DANTRACX/OpenVFD/README.md

# OpenVFD
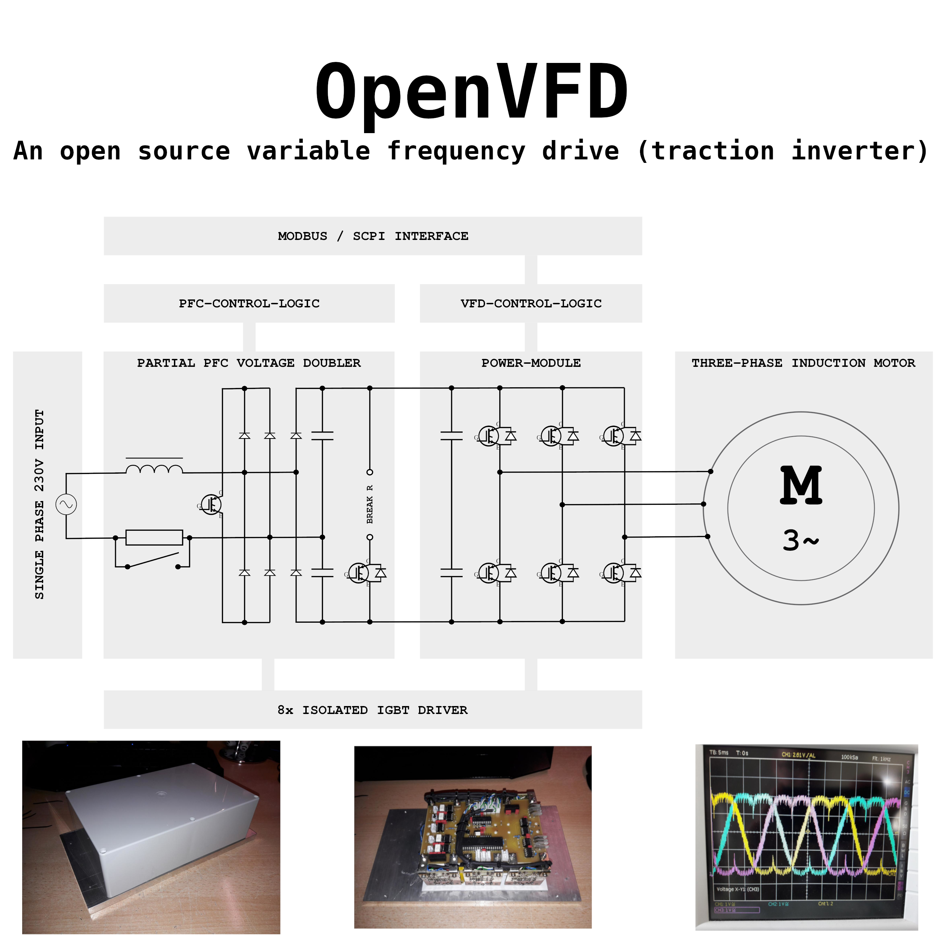
[picture p1: vfd_images/OpenVFD.png]
OpenVFD structure
