DANTRACX/OpenVFD/vfd_images/20190318_145512.jpg

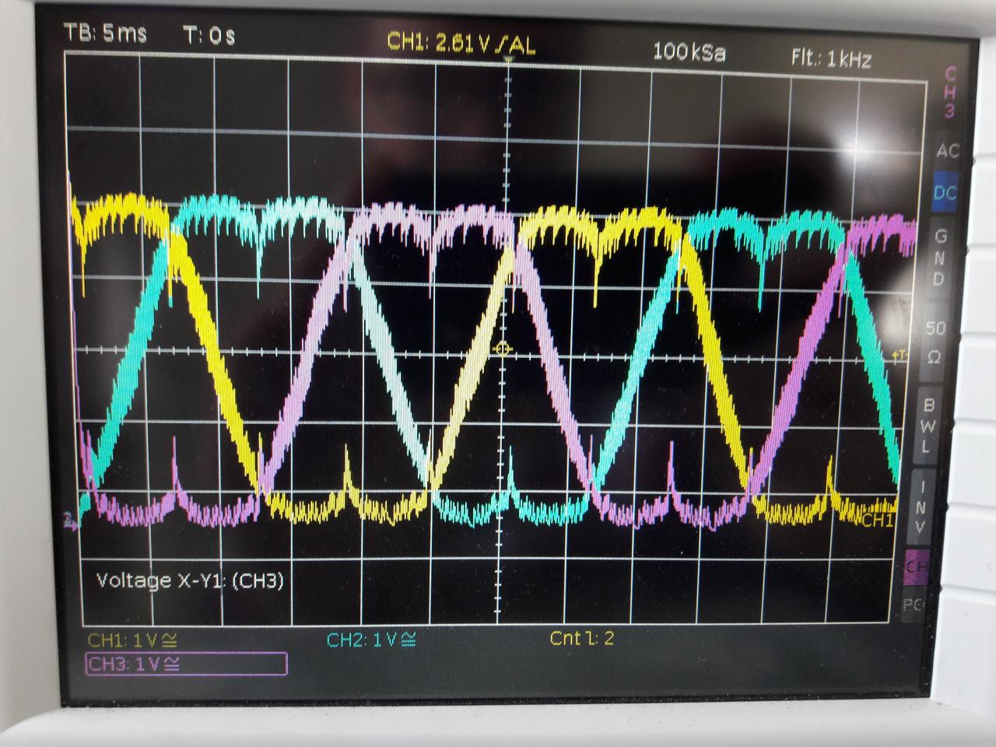
vfd_images/20190318_145512.jpg
