DANTRACX/OpenVFD/vfd_images/20191023_152630.jpg

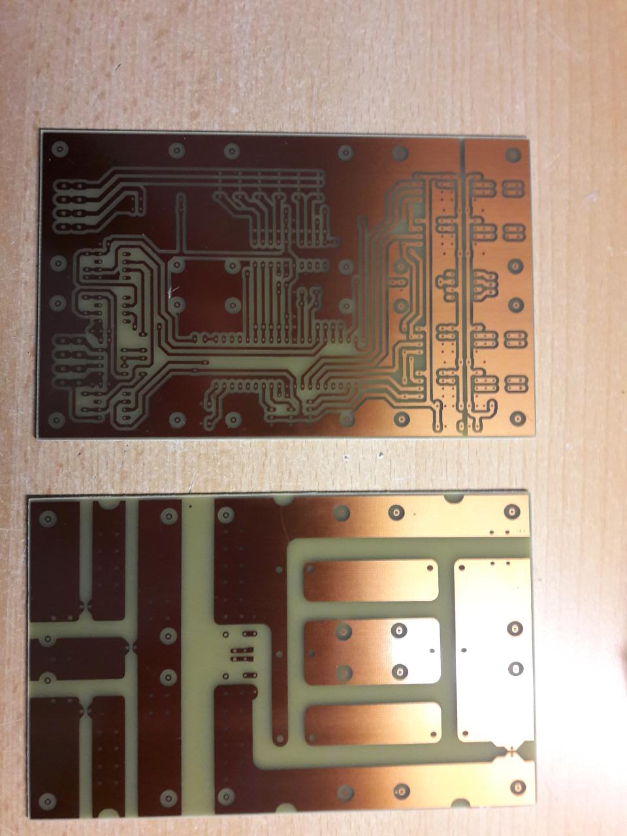
vfd_images/20191023_152630.jpg
