DANTRACX/OpenVFD/vfd_images/20191025_230519.jpg

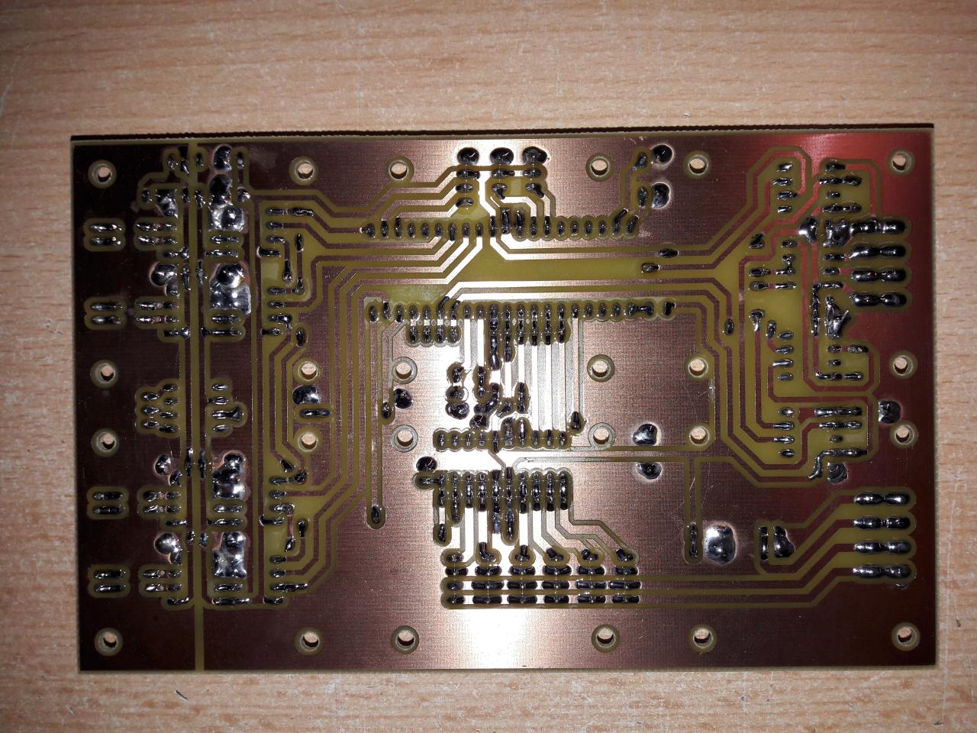
vfd_images/20191025_230519.jpg
