DANTRACX/OpenVFD/vfd_images/20200607_120607.jpg

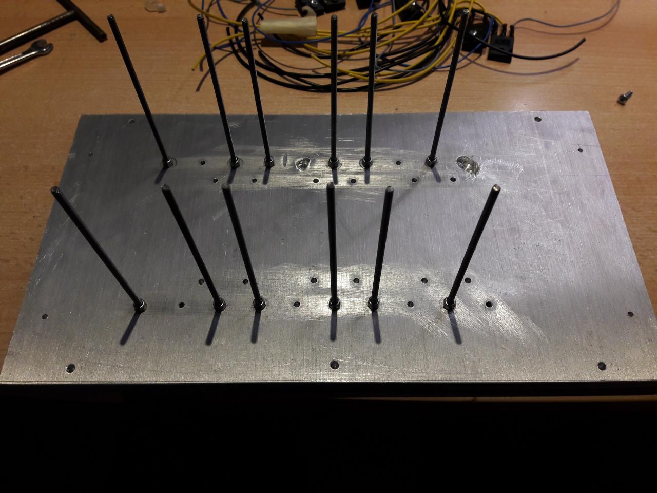
vfd_images/20200607_120607.jpg
