DANTRACX/OpenVFD/vfd_images/20200611_165828.jpg

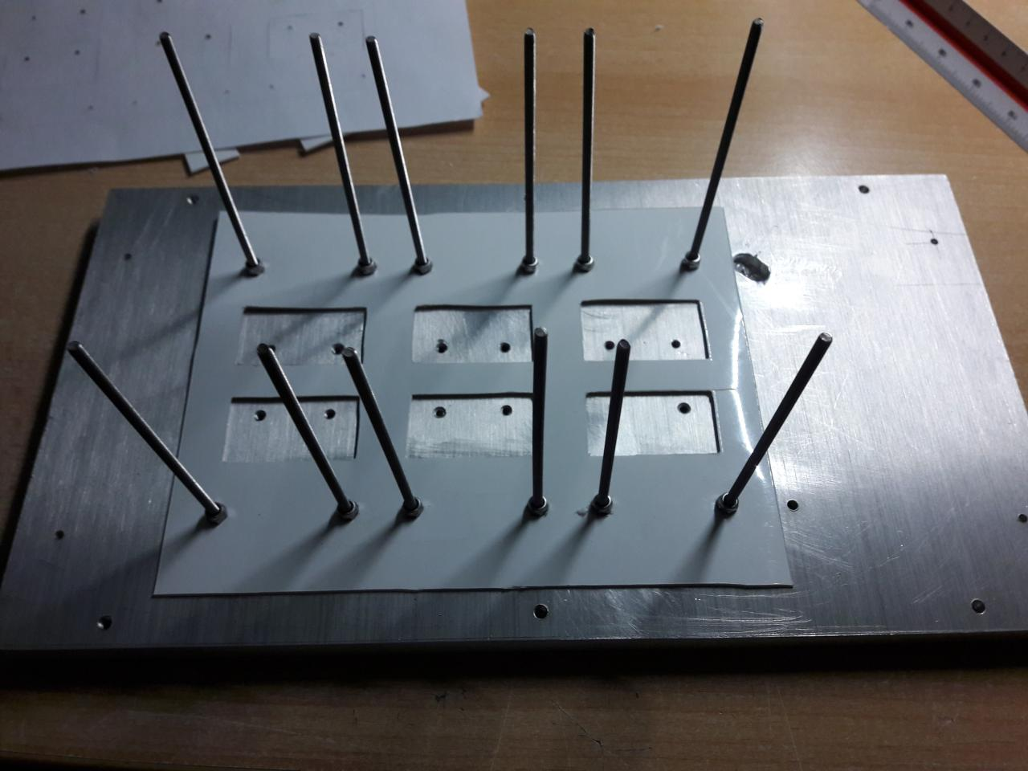
vfd_images/20200611_165828.jpg
