DANTRACX/OpenVFD/vfd_images/20200611_165842.jpg

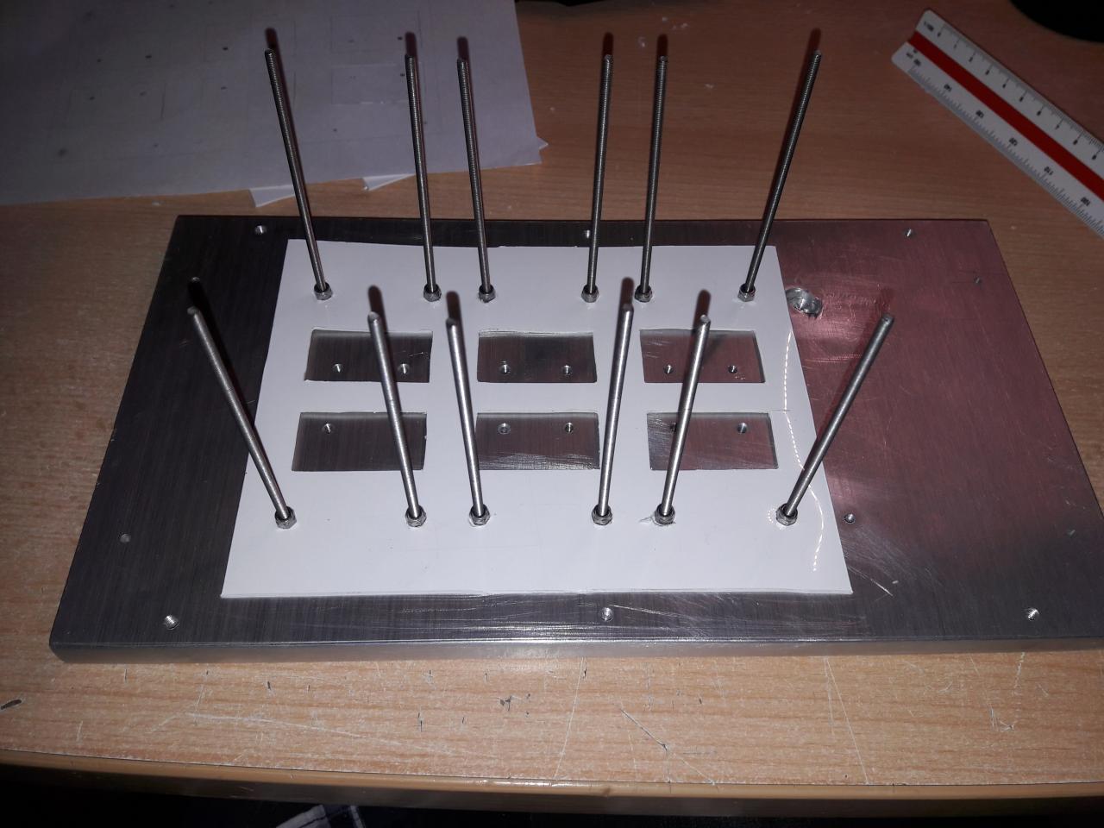
vfd_images/20200611_165842.jpg
