DANTRACX/OpenVFD/vfd_images/20200611_175108.jpg

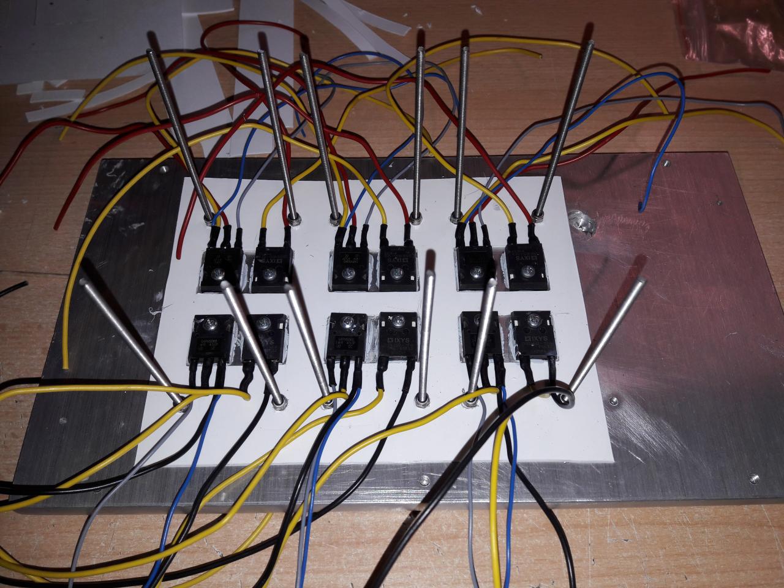
vfd_images/20200611_175108.jpg
