DANTRACX/OpenVFD/vfd_images/20200612_174039.jpg

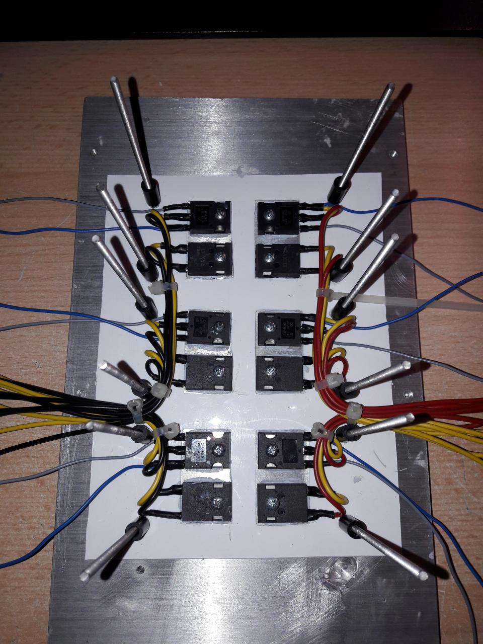
vfd_images/20200612_174039.jpg
