DANTRACX/OpenVFD/vfd_images/20200612_174147.jpg

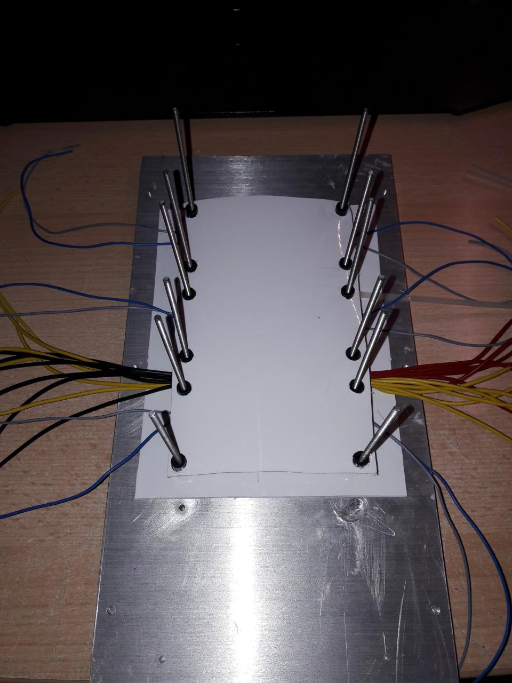
vfd_images/20200612_174147.jpg
