DANTRACX/OpenVFD/vfd_images/20200612_174251.jpg

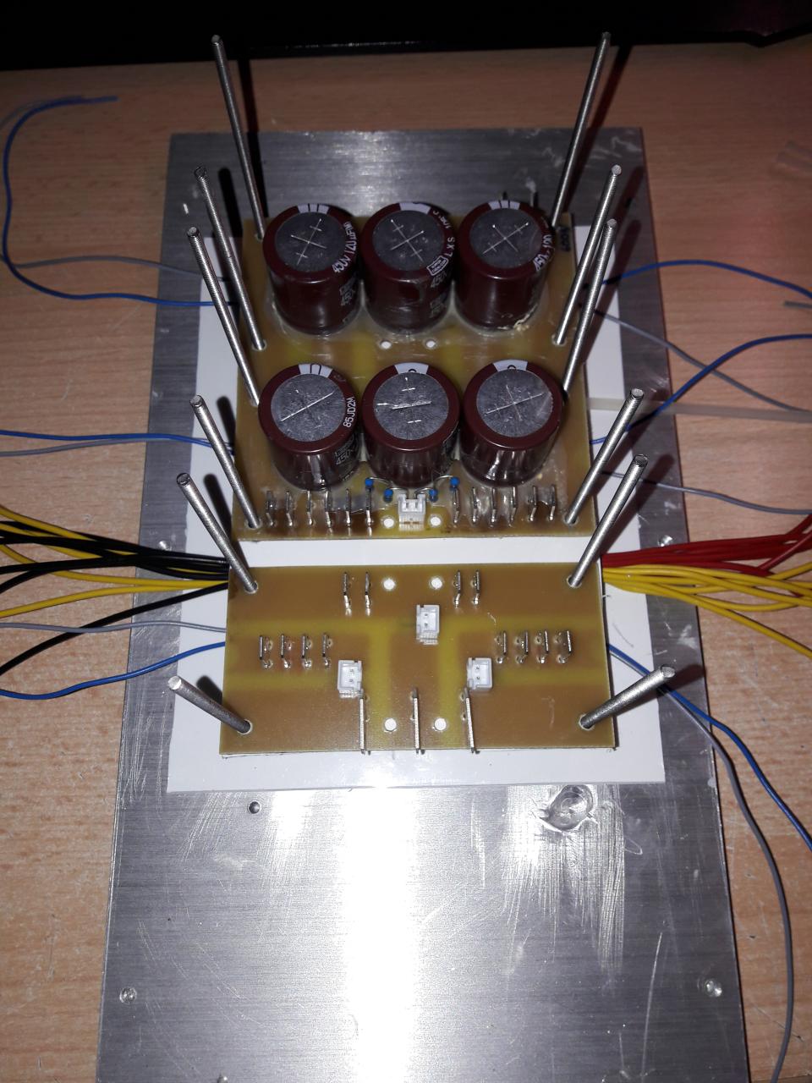
vfd_images/20200612_174251.jpg
