DANTRACX/OpenVFD/vfd_images/20200612_174302.jpg

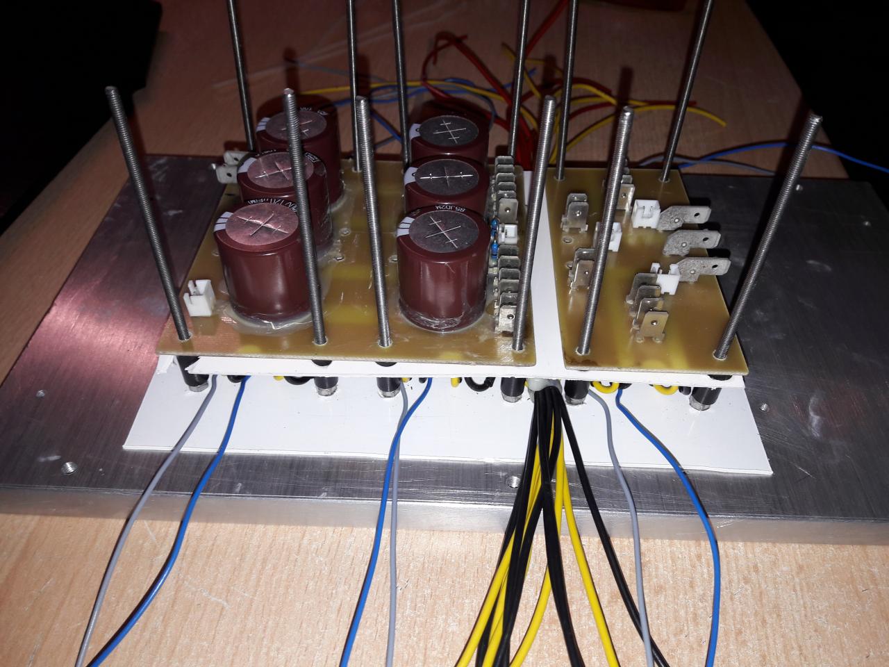
vfd_images/20200612_174302.jpg
