DANTRACX/OpenVFD/vfd_images/20200612_174313.jpg

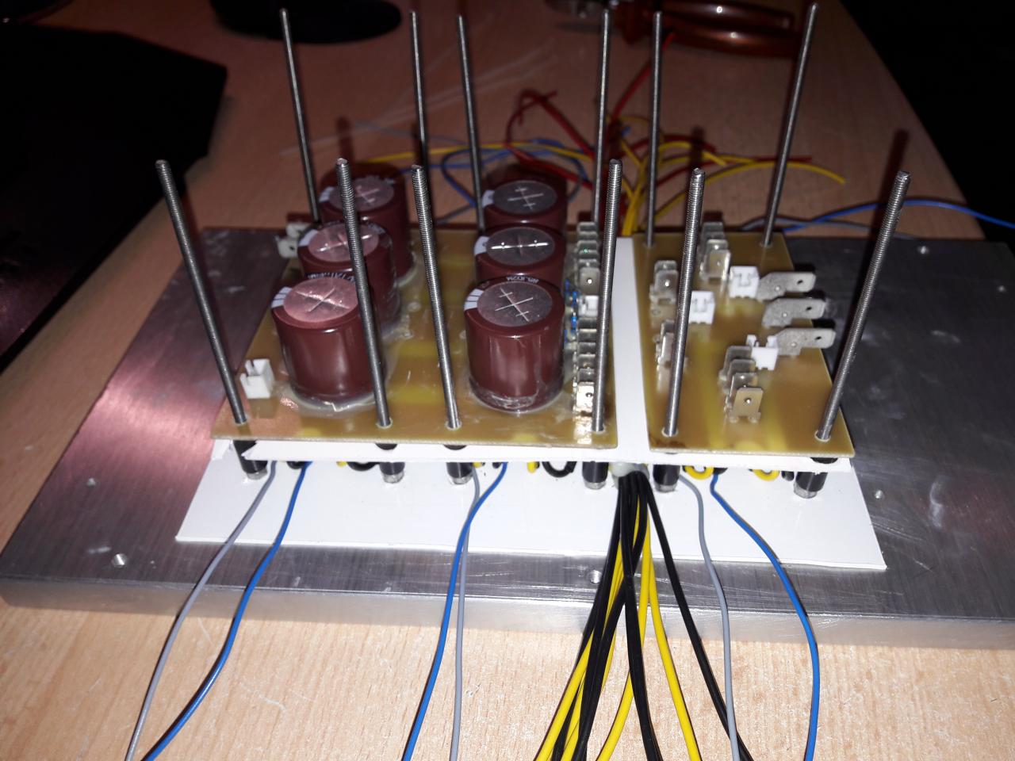
vfd_images/20200612_174313.jpg
