DANTRACX/OpenVFD/vfd_images/20200612_213444.jpg

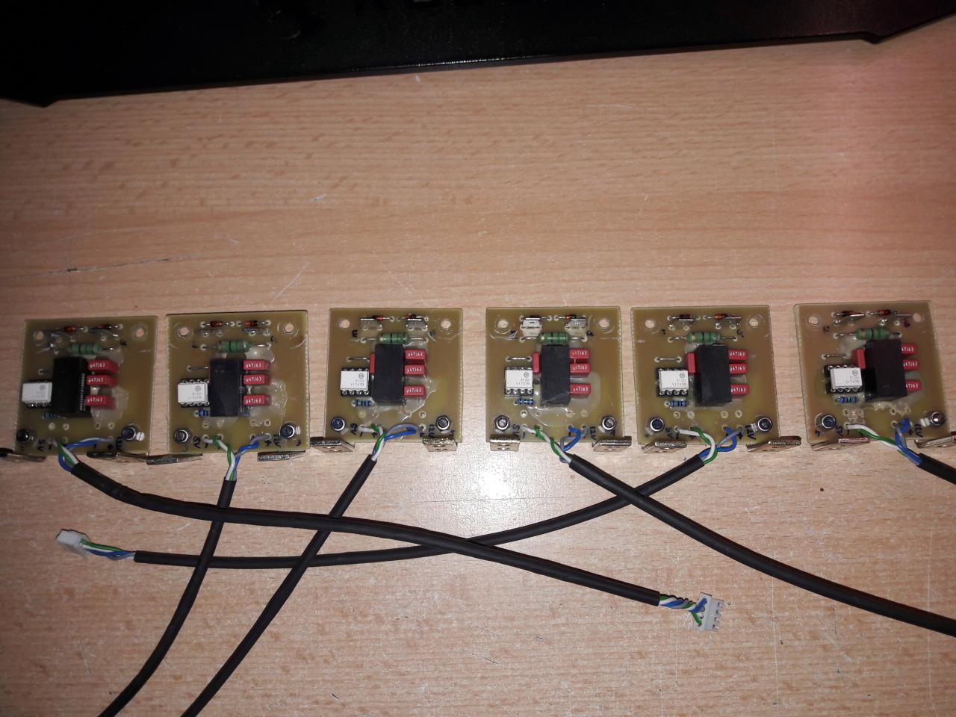
vfd_images/20200612_213444.jpg
