DANTRACX/OpenVFD/vfd_images/20200612_213753.jpg

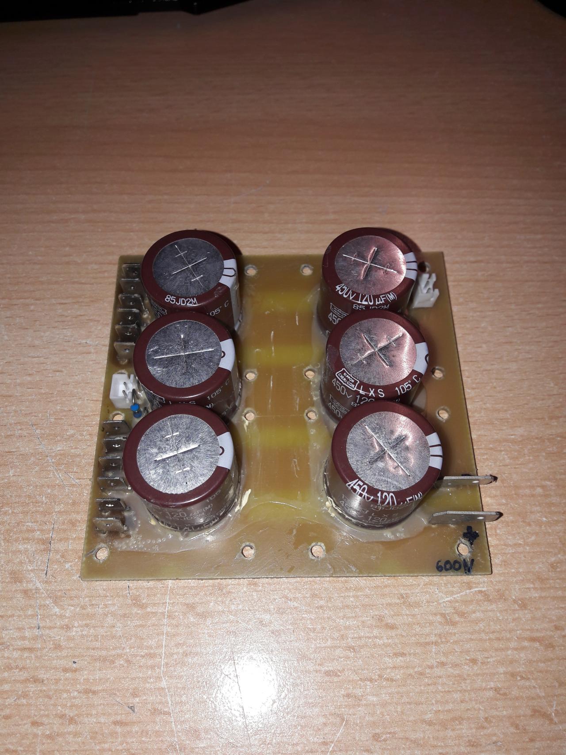
vfd_images/20200612_213753.jpg
