DANTRACX/OpenVFD/vfd_images/20200612_213925.jpg

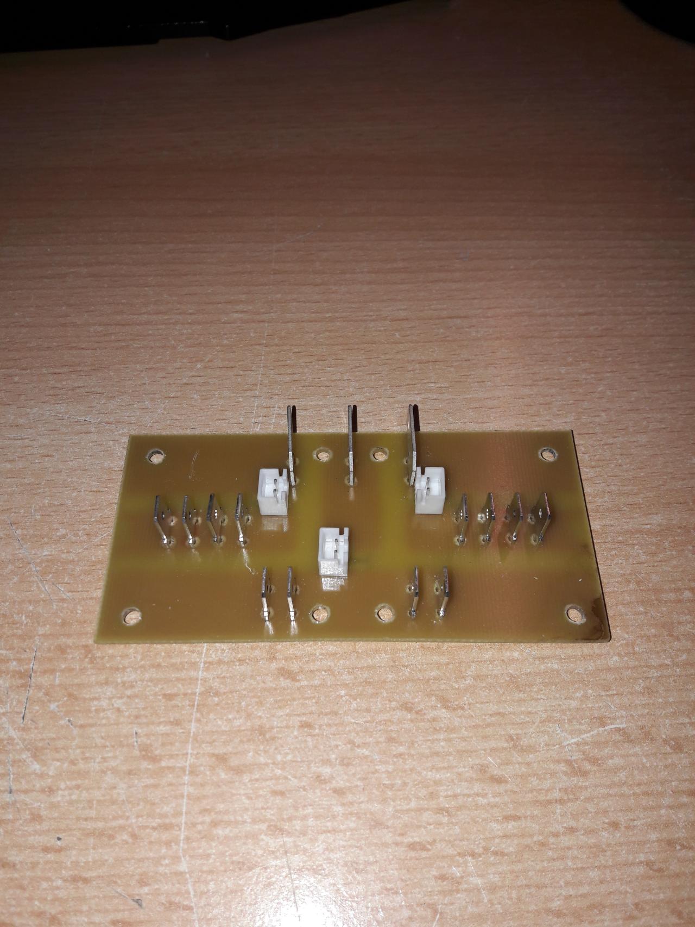
vfd_images/20200612_213925.jpg
