DANTRACX/OpenVFD/vfd_images/20200612_214124.jpg

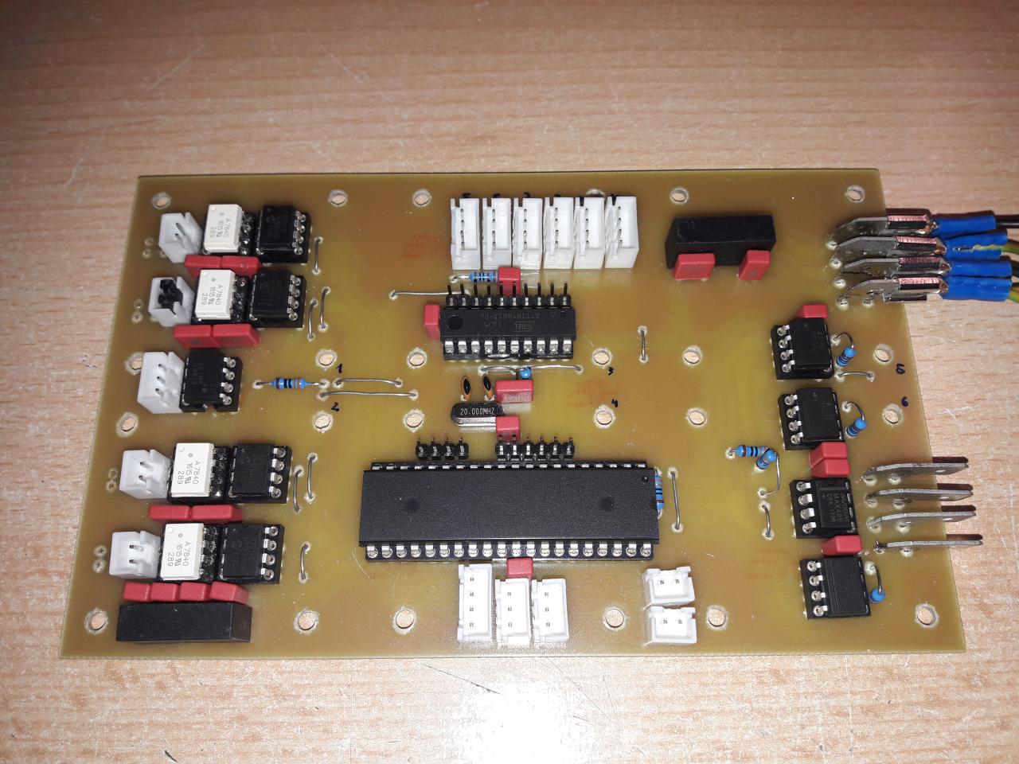
vfd_images/20200612_214124.jpg
