DANTRACX/OpenVFD/vfd_images/20200613_154349.jpg

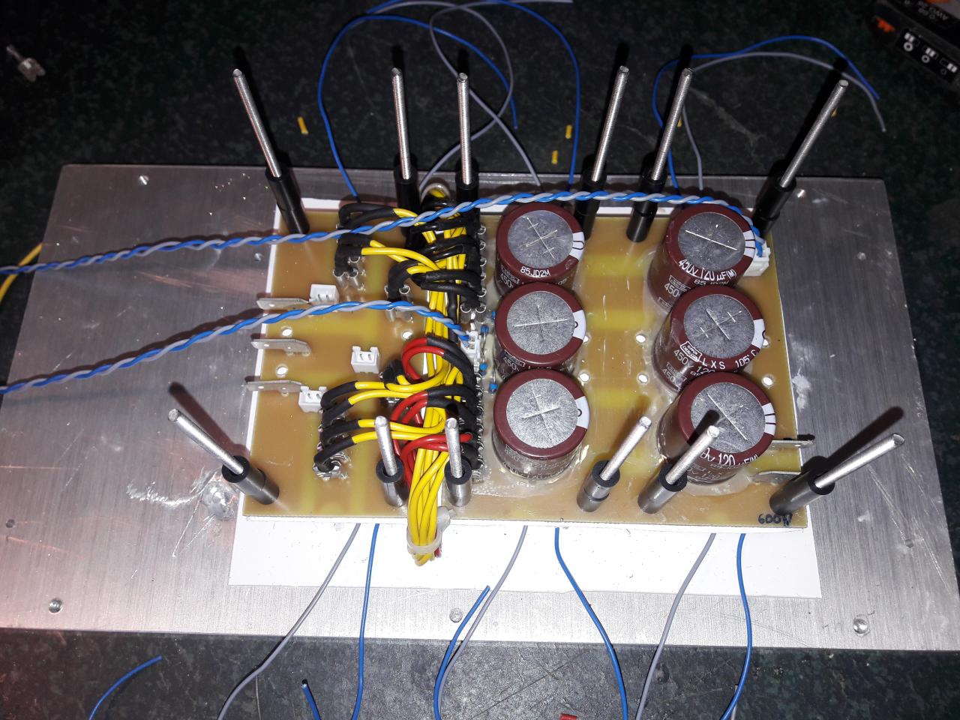
vfd_images/20200613_154349.jpg
