DANTRACX/OpenVFD/vfd_images/20200613_154356.jpg

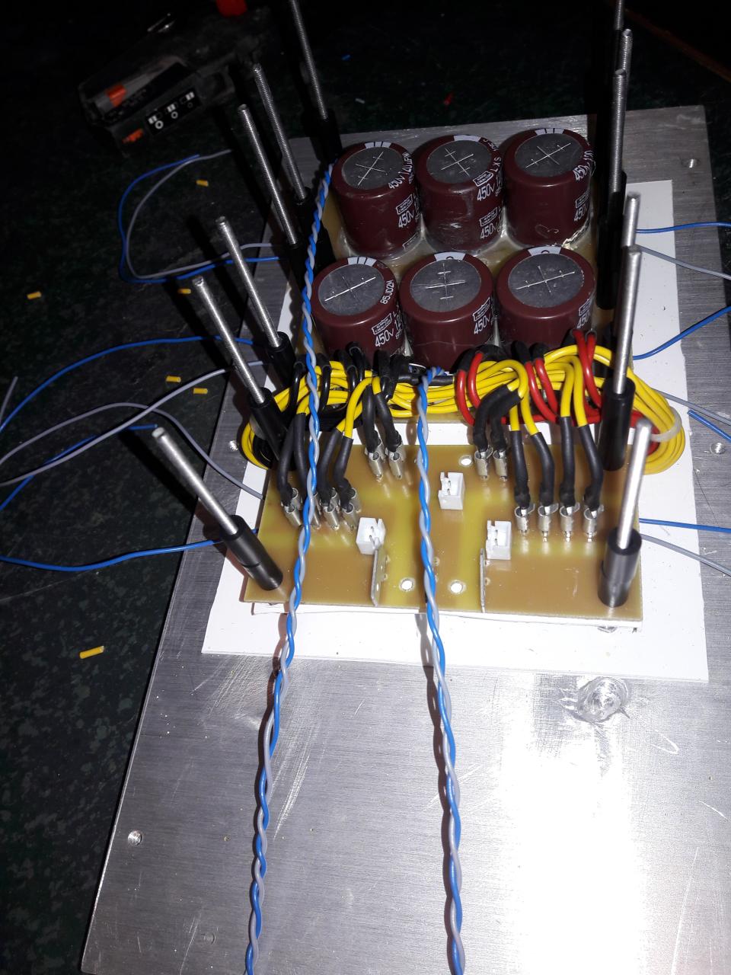
vfd_images/20200613_154356.jpg
