DANTRACX/OpenVFD/vfd_images/20200613_165805.jpg

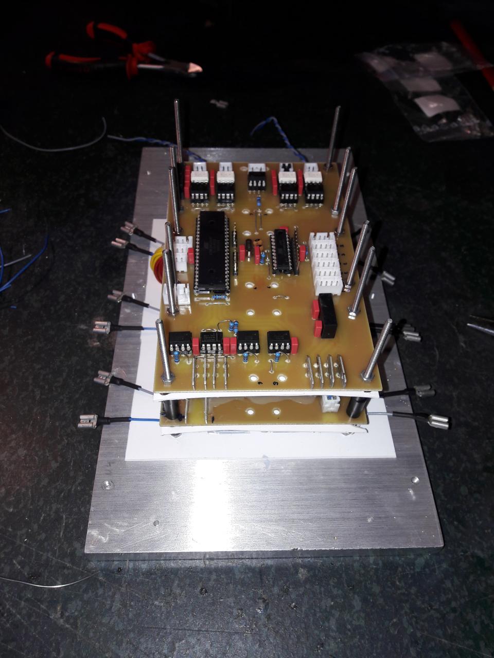
vfd_images/20200613_165805.jpg
