DANTRACX/OpenVFD/vfd_images/20200613_165815.jpg

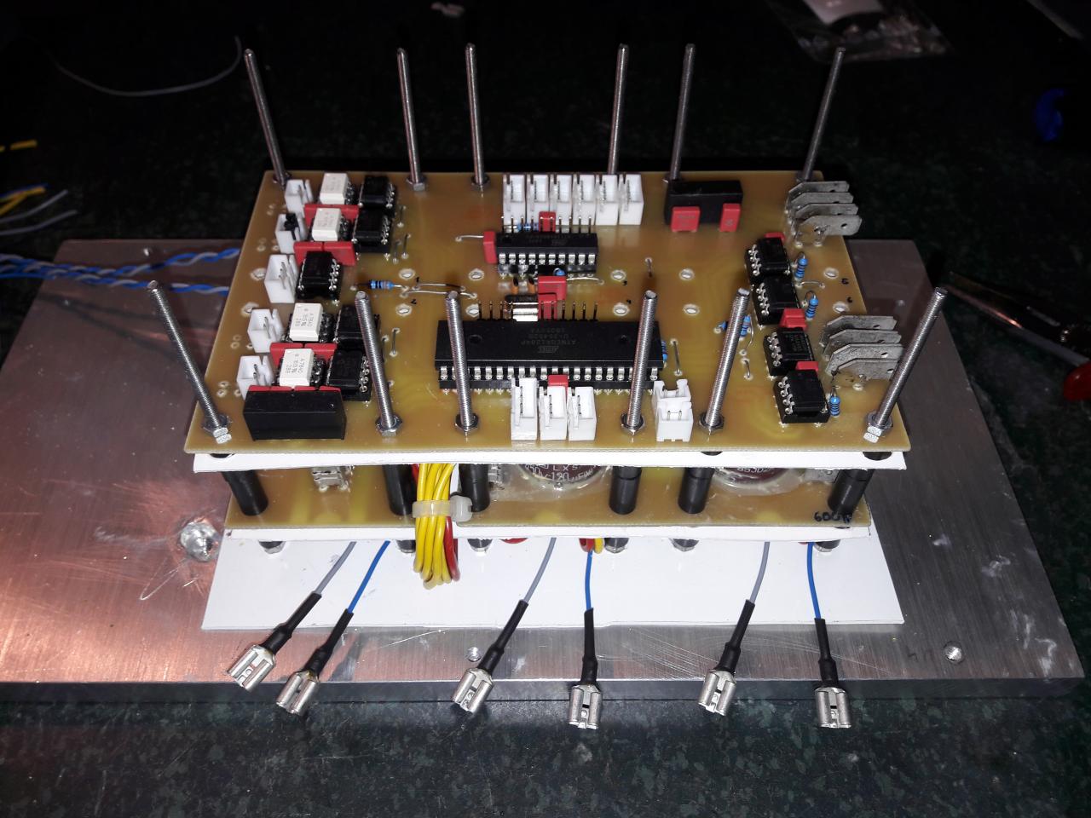
vfd_images/20200613_165815.jpg
