DANTRACX/OpenVFD/vfd_images/20200613_175017.jpg

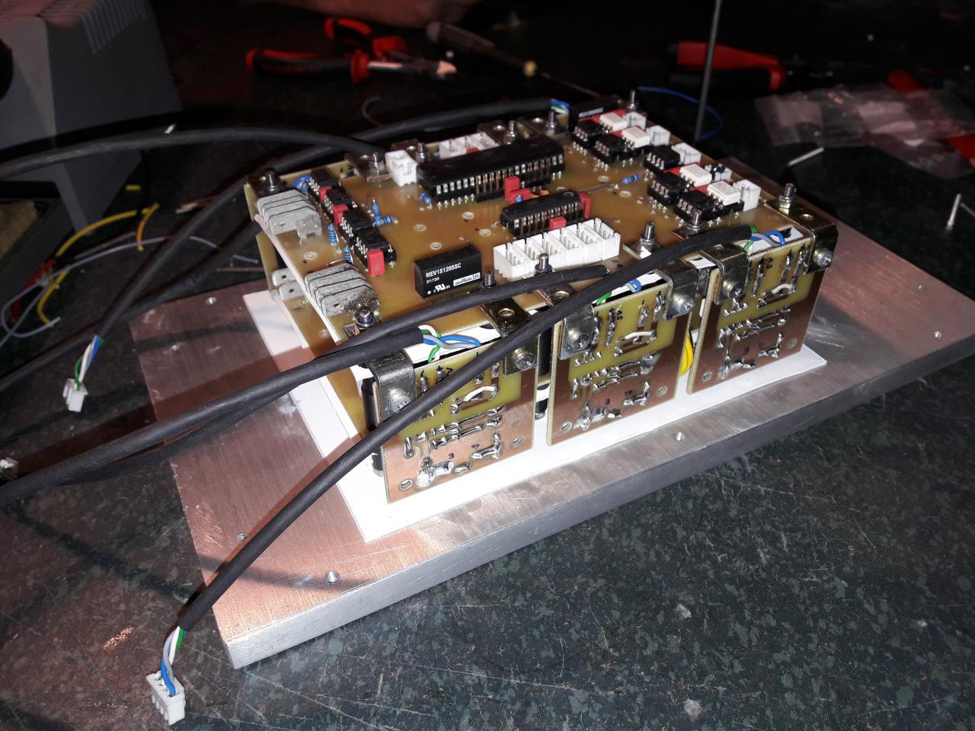
vfd_images/20200613_175017.jpg
