DANTRACX/OpenVFD/vfd_images/20200613_175026.jpg

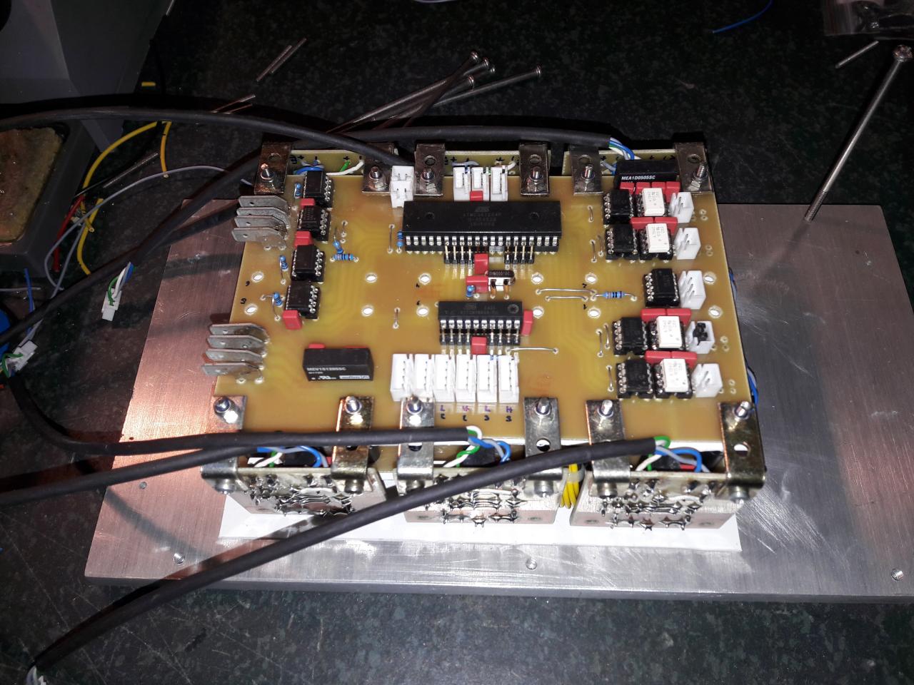
vfd_images/20200613_175026.jpg
