DANTRACX/OpenVFD/vfd_images/20200613_202628.jpg

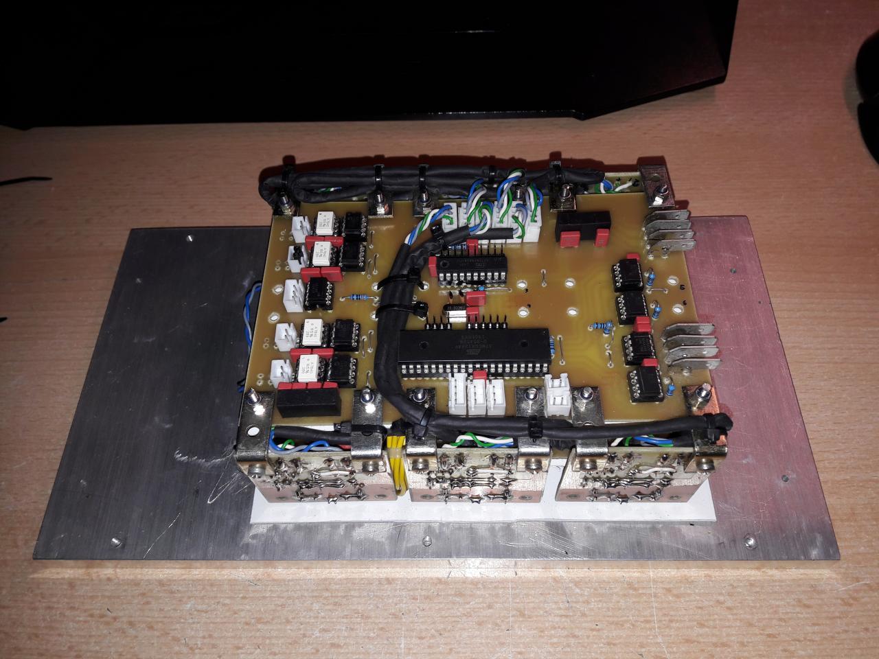
vfd_images/20200613_202628.jpg
