DANTRACX/OpenVFD/vfd_images/20200613_202829.jpg

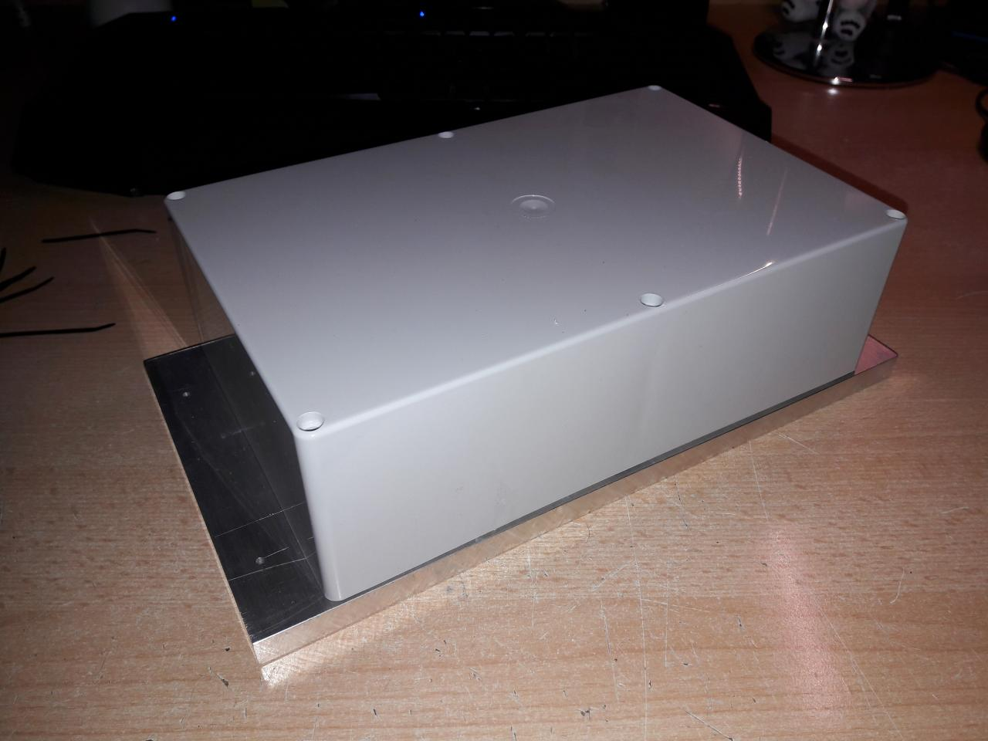
vfd_images/20200613_202829.jpg
