DANTRACX/OpenVFD/vfd_images/IMG-20191023-WA0008.jpeg

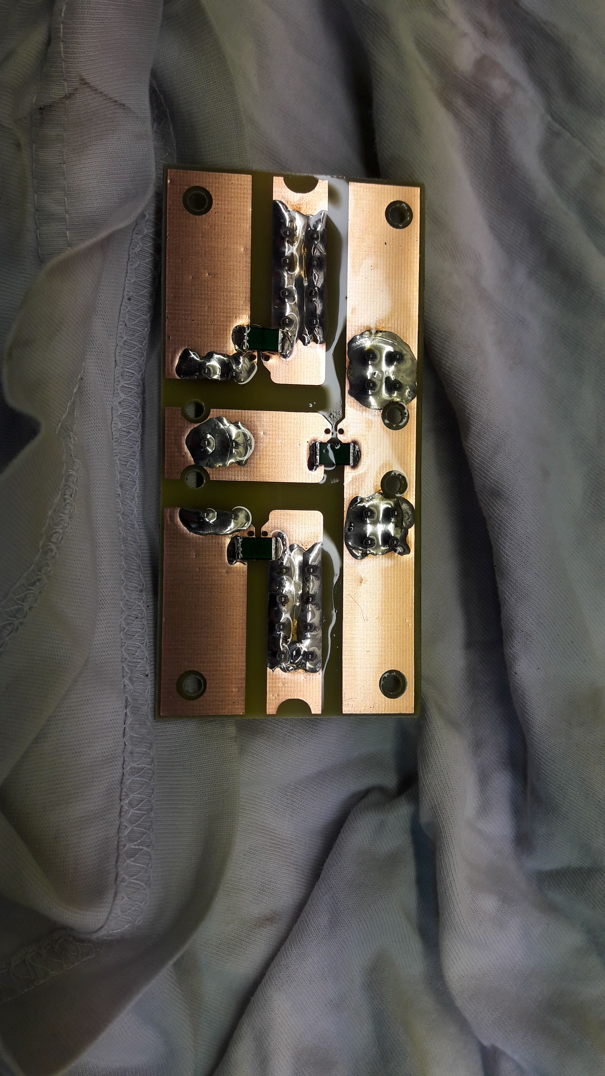
vfd_images/IMG-20191023-WA0008.jpeg
