DANTRACX/OpenVFD/(threads)

Thread 1 (2019-04-19):

IGBT-Driver wrong DC/DC footprint

DANTRACX, 2019-04-19:
The DC/DC footpring got the wrong size.
The input voltage pins are misaligned and the capacitors interfere with the housing.

- [ ] Change DC/DC Footprint

- [ ] Move 470µ Capacitors to the right

Closed 2019-10-10.

Thread 2 (2020-06-18):

U and I measurement incorrect [hardware design flaw confirmed] - will be fixed soon

DANTRACX, 2020-06-18:
The voltage and current measurement for the controlling algorithm does not work as intended. The sensors show strong non-linear dependencies which need to be investigated.

DANTRACX, 2020-07-04:
Tried multiple software filter solutions but results were not acceptable.
Discovered a major design flow with the isolation-amplifier's reference and negative input which should be connected. This might require a complete redesign of the measurement hardware an the controller pcb.
First test show perfect results for one channel when bridging reference and negative input, but all channel's references are connected in parallel which does not allow to connect all negative inputs to the references as this might lead to a potential shift on different measurement points.

Closed 2020-07-18.
