DANTRACX/OpenVFD/vfd_controller/schematics/vfd_controller_cpu_brd.pdf

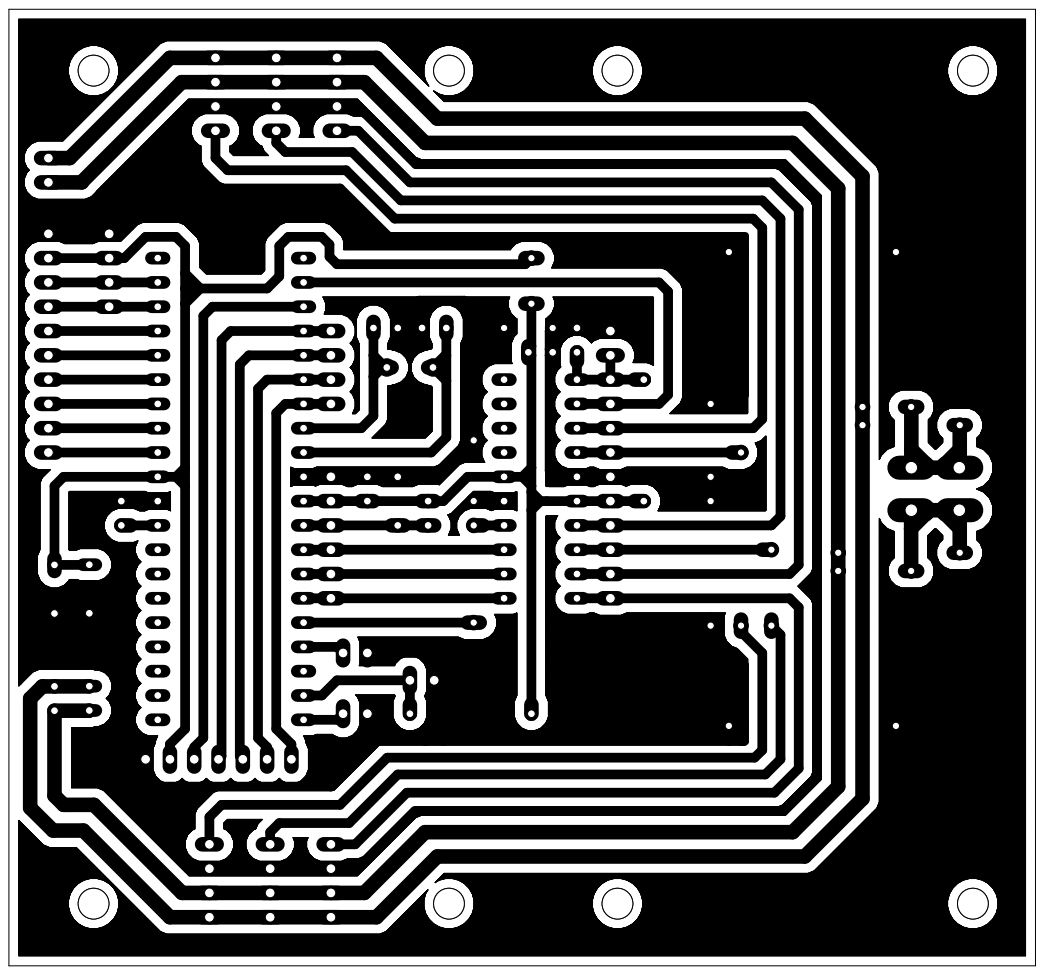
[picture p27: page 1]

VFD-Conroller CPU Board
(C) 2020 Christoph Klie
