DANTRACX/OpenVFD/vfd_controller/schematics/vfd_controller_cpu_brd_assembly.pdf

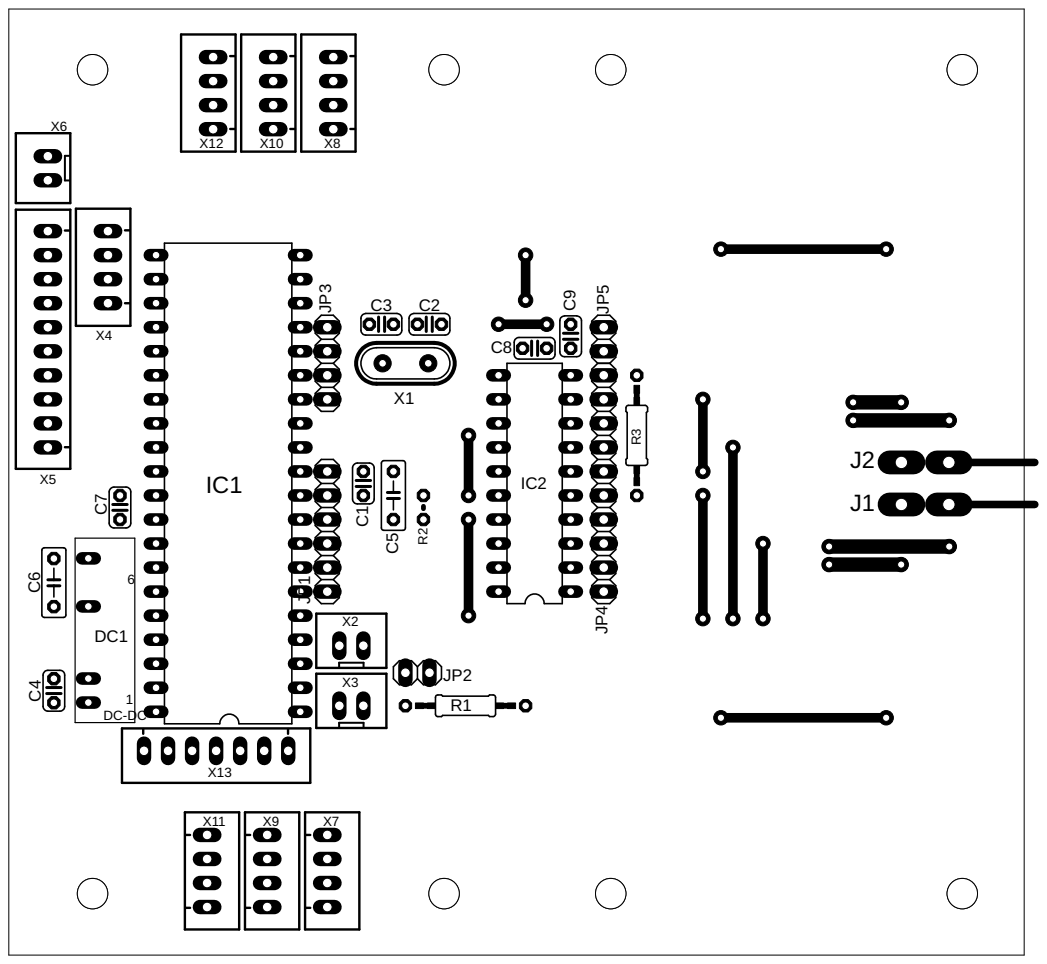
[picture p28: page 1]

OpenVFD VFD-Conroller CPU Board (C) 2020 Christoph Klie

Version 1.0 | [1/1]
