DANTRACX/OpenVFD/vfd_controller/schematics/vfd_controller_cpu_sch.pdf

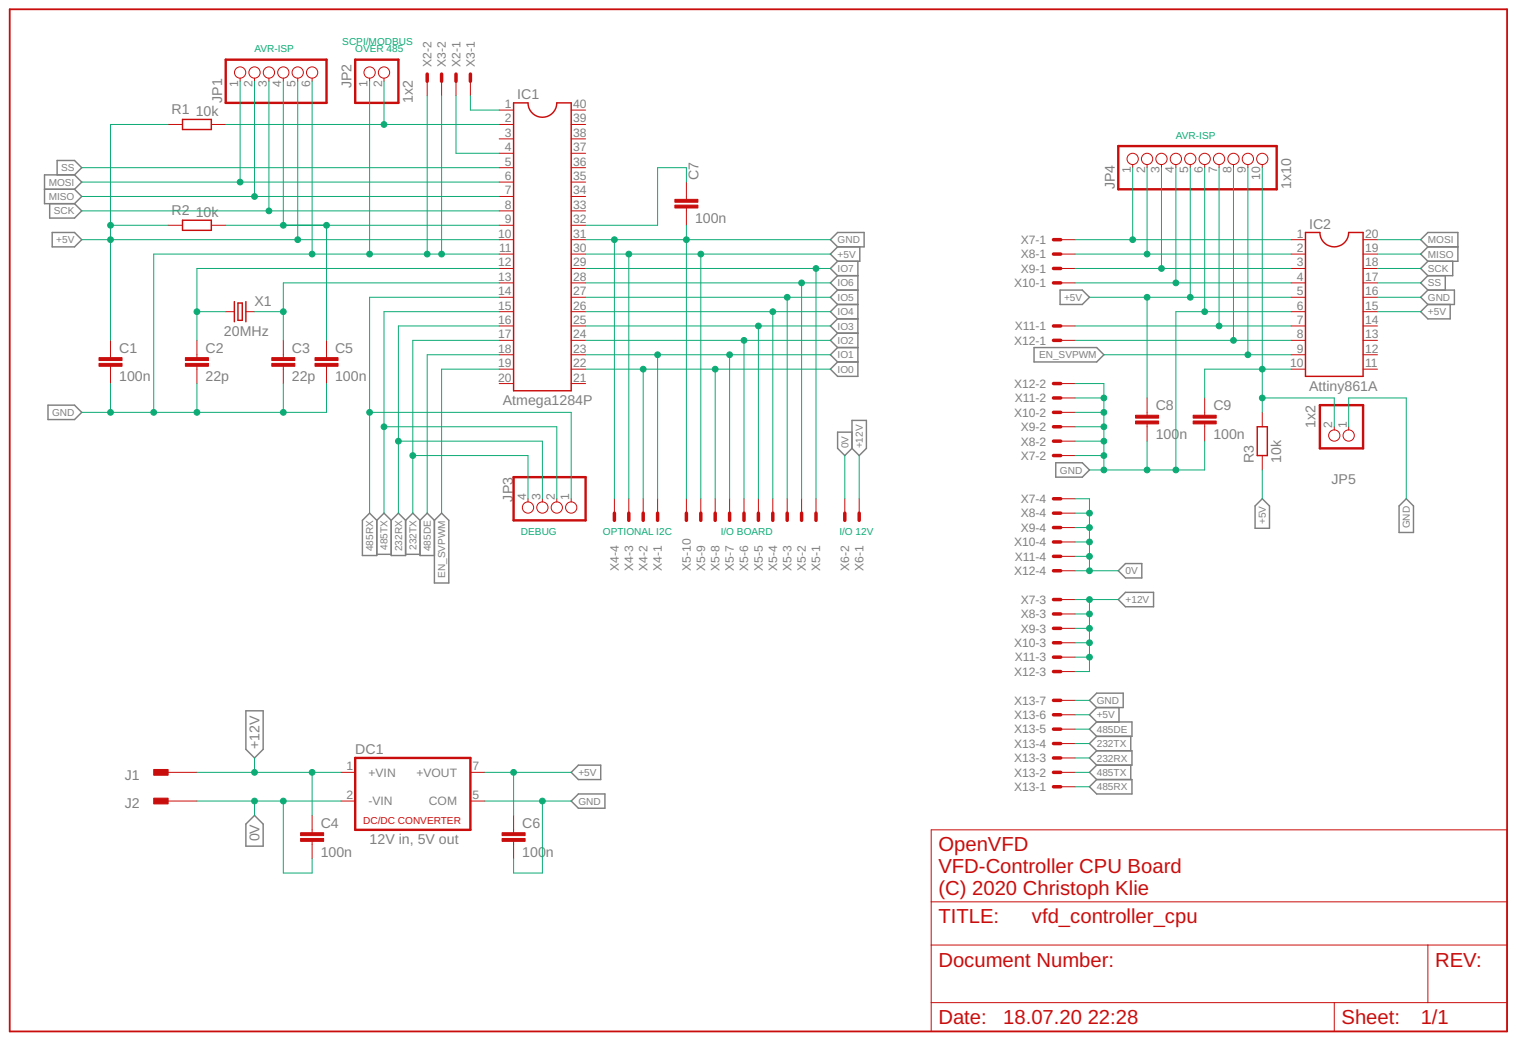
[picture p29: page 1]

OpenVFD
VFD-Controller CPU Board
(C) 2020 Christoph Klie
TITLE:

Document Number: | REV:

Date: 18.07.20 22:28 | Sheet: 1/1
