DANTRACX/OpenVFD/vfd_controller/schematics/vfd_controller_io_brd_assembly.pdf

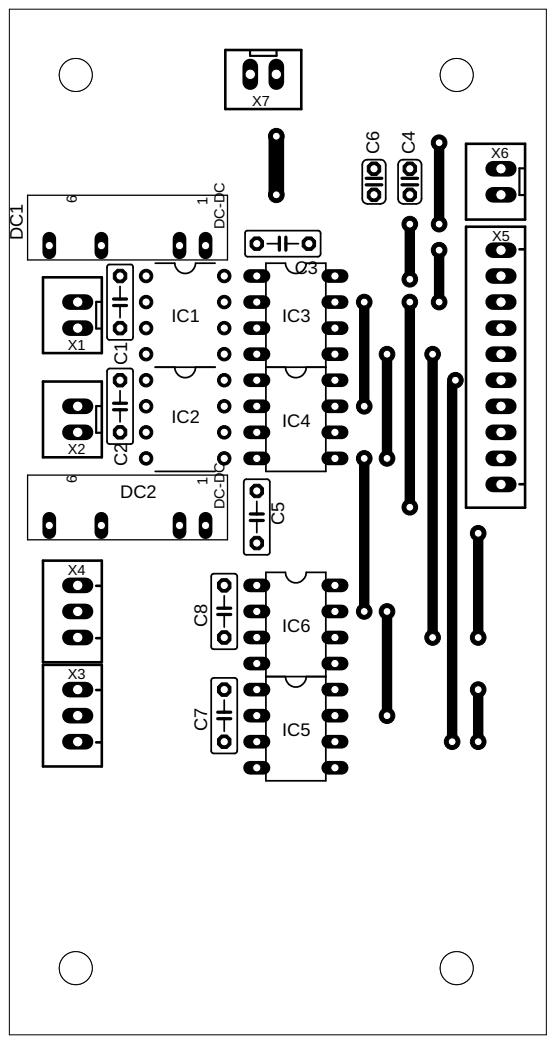
[picture p30: page 1]

OpenVFD VFD-Conroller I/O Board (C) 2020 Christoph Klie

Version 1.0 | [1/1]
