DANTRACX/OpenVFD/vfd_igbt_driver/schematics/vfd_igbtdriver_brd_assembly.pdf

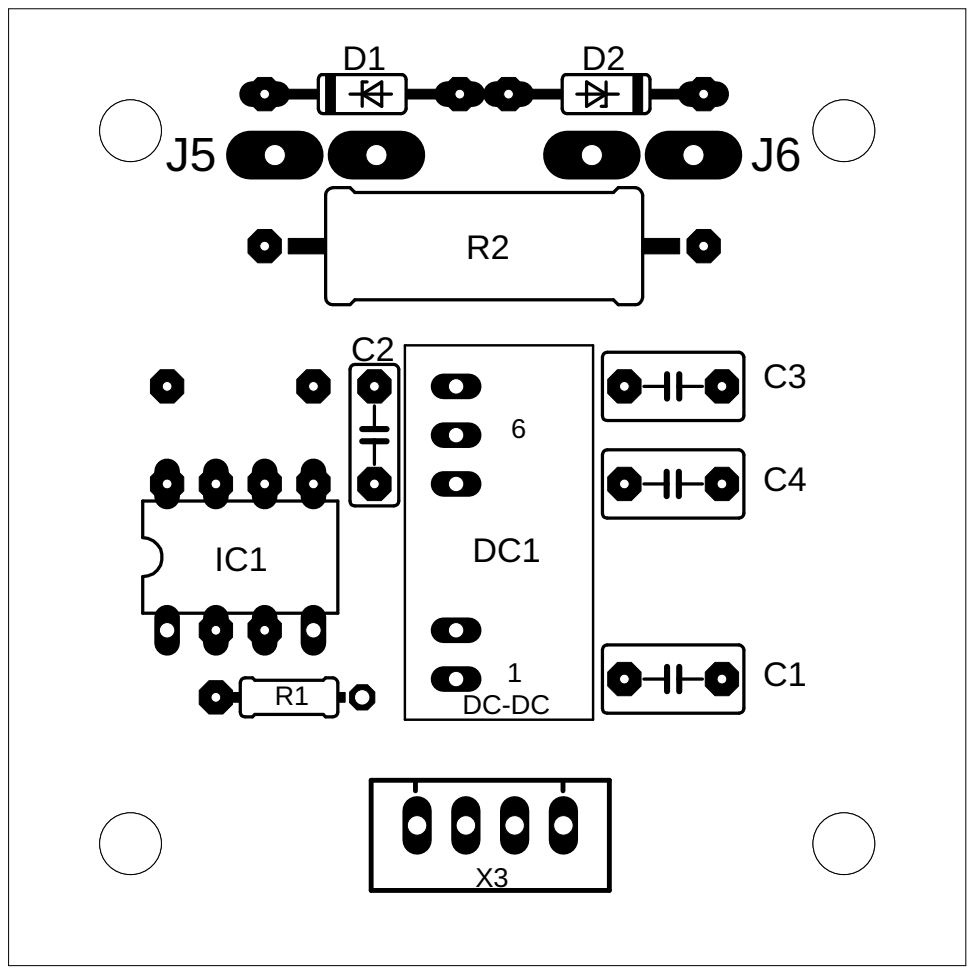
[picture p31: page 1]

OpenVFD VFD IGBT-DRIVER (C) 2020 Christoph Klie

Version 1.0 | [1/1]
