DANTRACX/OpenVFD/vfd_controller/schematics/vfd_controller_io_brd.pdf

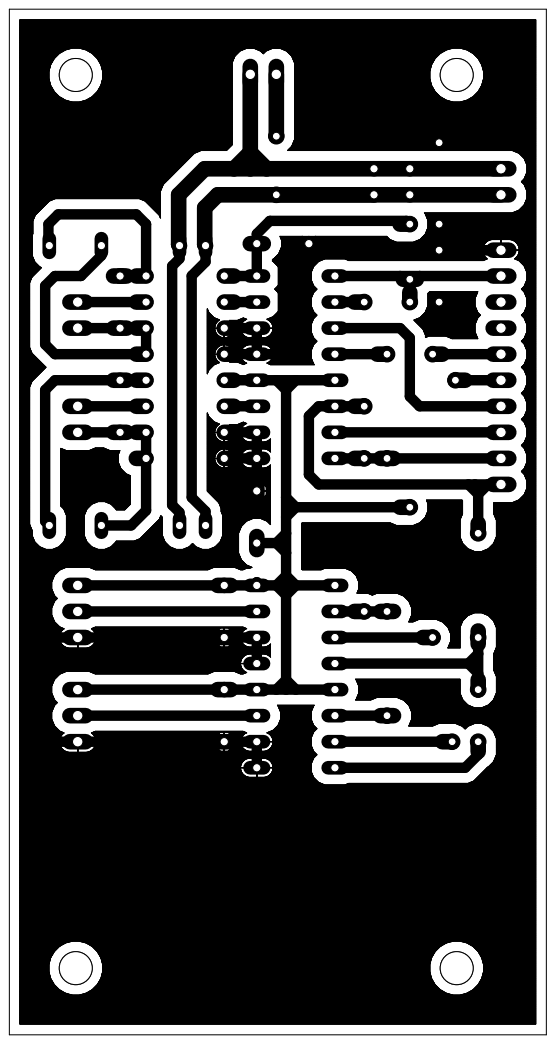
[picture p32: page 1]
