DANTRACX/OpenVFD/vfd_controller/schematics/vfd_controller_io_sch.pdf

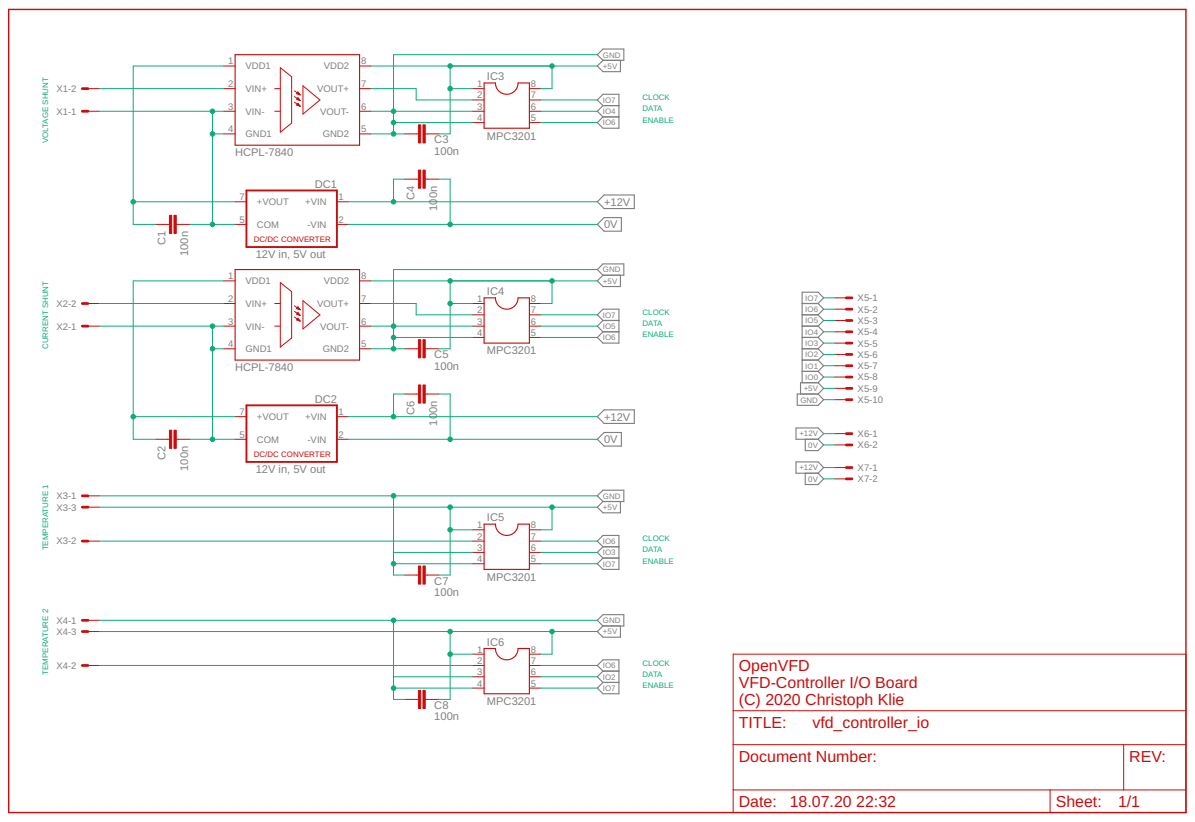
[picture p33: page 1]
