DANTRACX/OpenVFD/vfd_dcbus/schematics/vfd_dcbus_assembly.pdf

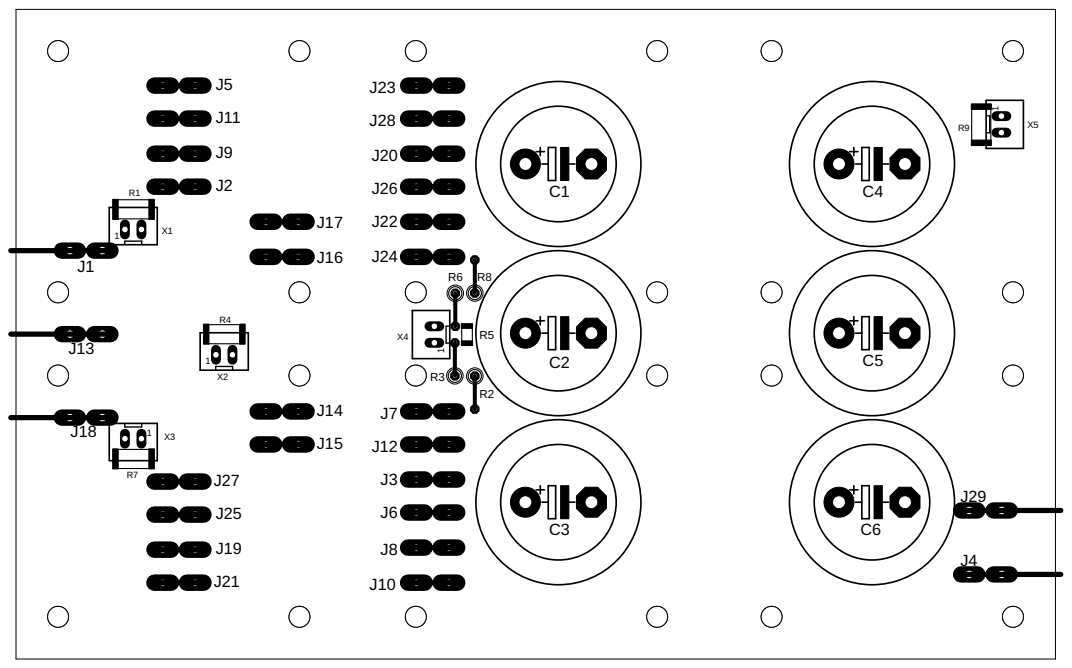
[picture p34: page 1]

1 1 1 1 1 C1 C2 C3 C4 C5 C6 J10 J11 J12 J13 J14 J17 J18 J19 J20 J22 J23 J24 J26 J27 J28 J29 J1 J2 J3 J4 J6J7J8 R1 R9 R4 R7 J9J5 J15 J16 J21 J25 R2 R3 R5 R6 R8 X5 X1 X2 X3 X4 Version 1.0 [1/1] OpenVFD DC-BUS (C) 2019 Christoph Klie ABCD 1 2 3 4 5 6 ABCD 1 2 3 4 5 6
