DANTRACX/OpenVFD/vfd_dcbus/schematics/vfd_dcbus_brd.pdf

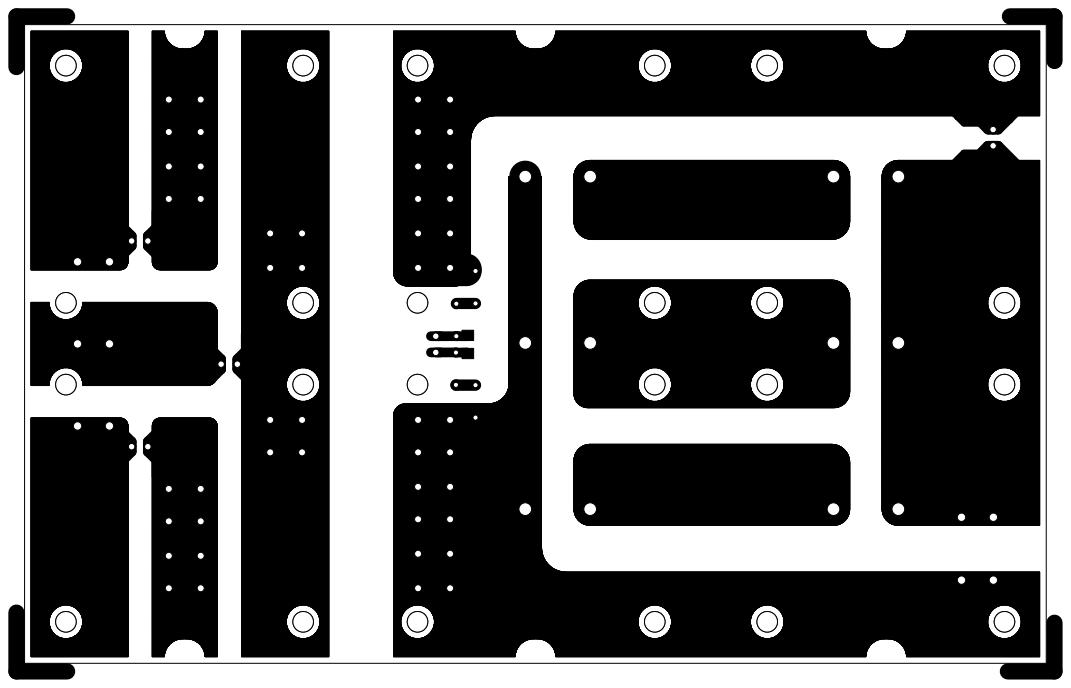
[picture p35: page 1]
