DANTRACX/OpenVFD/vfd_igbt_driver/schematics/vfd_igbtdriver_brd_production.pdf

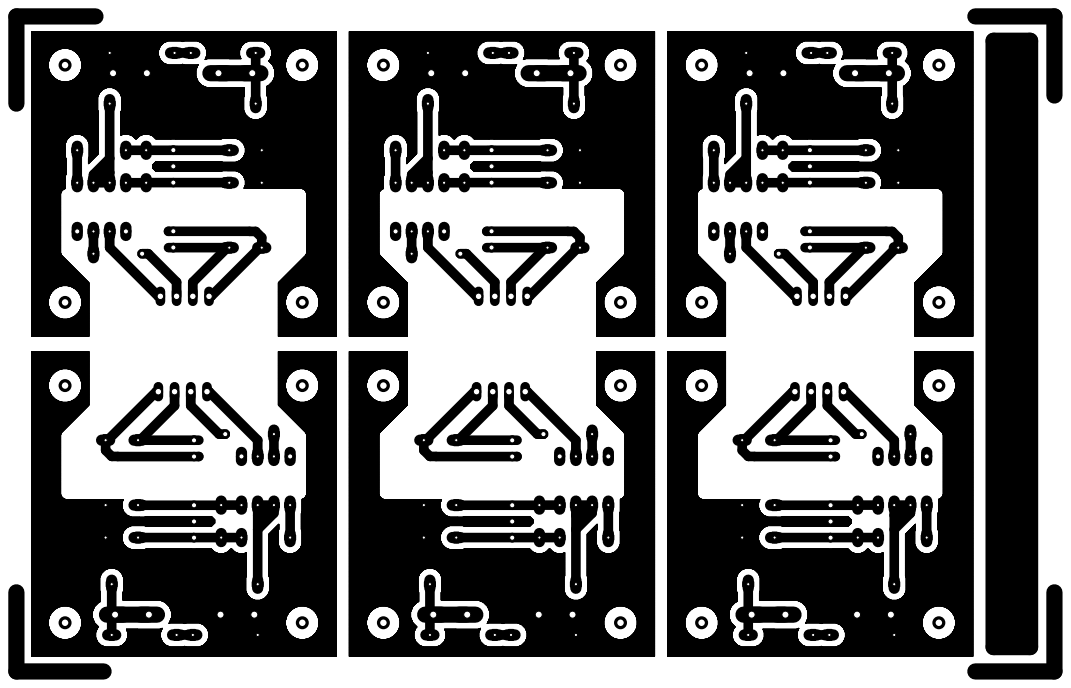
[picture p36: page 1]
