DANTRACX/OpenVFD/vfd_igbt_driver/schematics/vfd_igbtdriver_sch.pdf

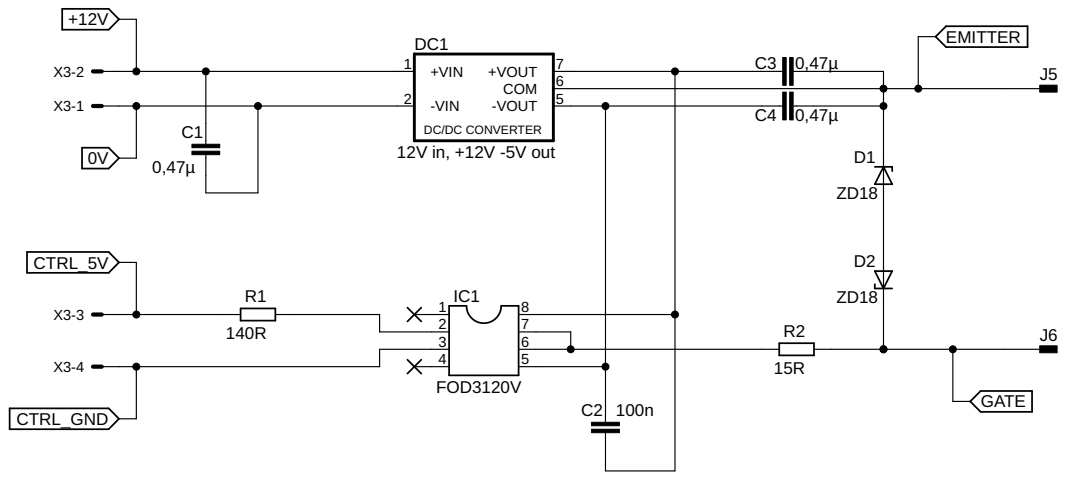
[picture p37: page 1]

Document Number: | REV:

Date: 18.07.20 22:25 | Sheet: 1/1
