DANTRACX/OpenVFD/vfd_controller/schematics/vfd_controller_production.pdf

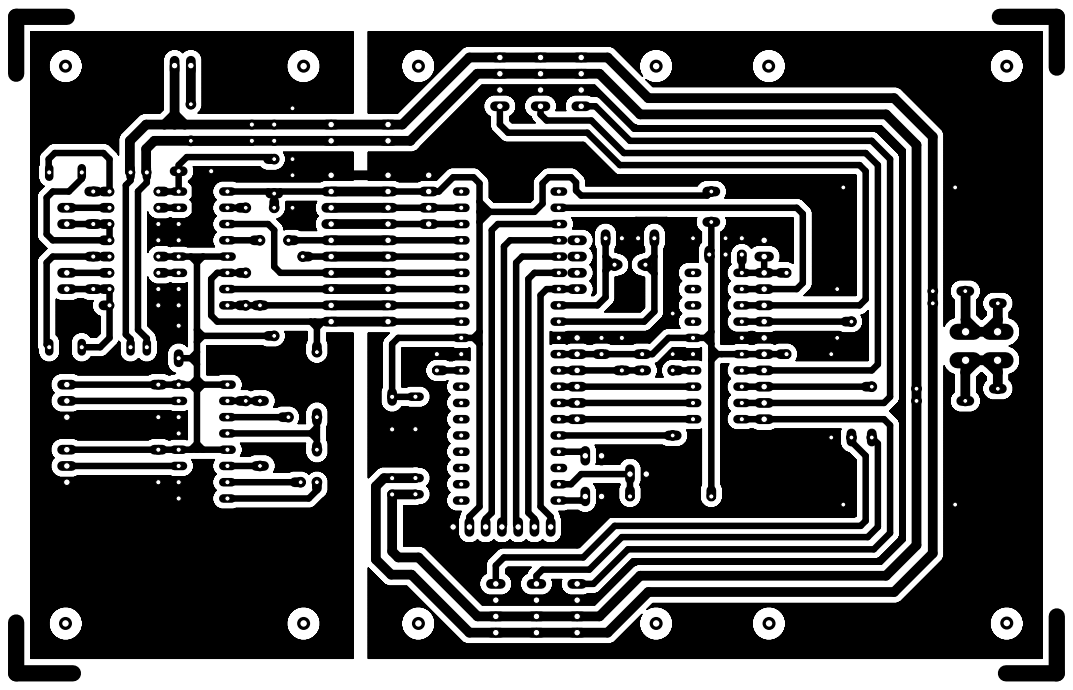
[picture p38: page 1]
