DANTRACX/OpenVFD/vfd_power_module/schematics/vfd_dcbus.pdf

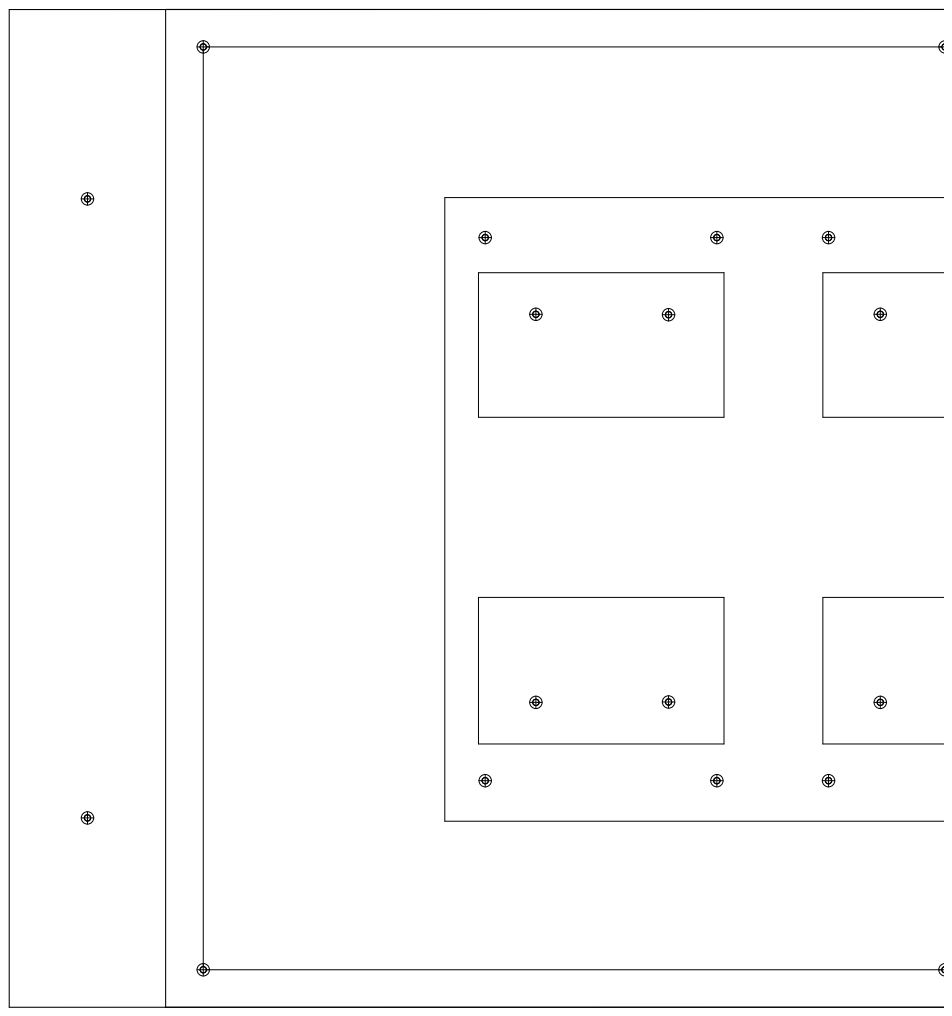
[picture p39: page 1]

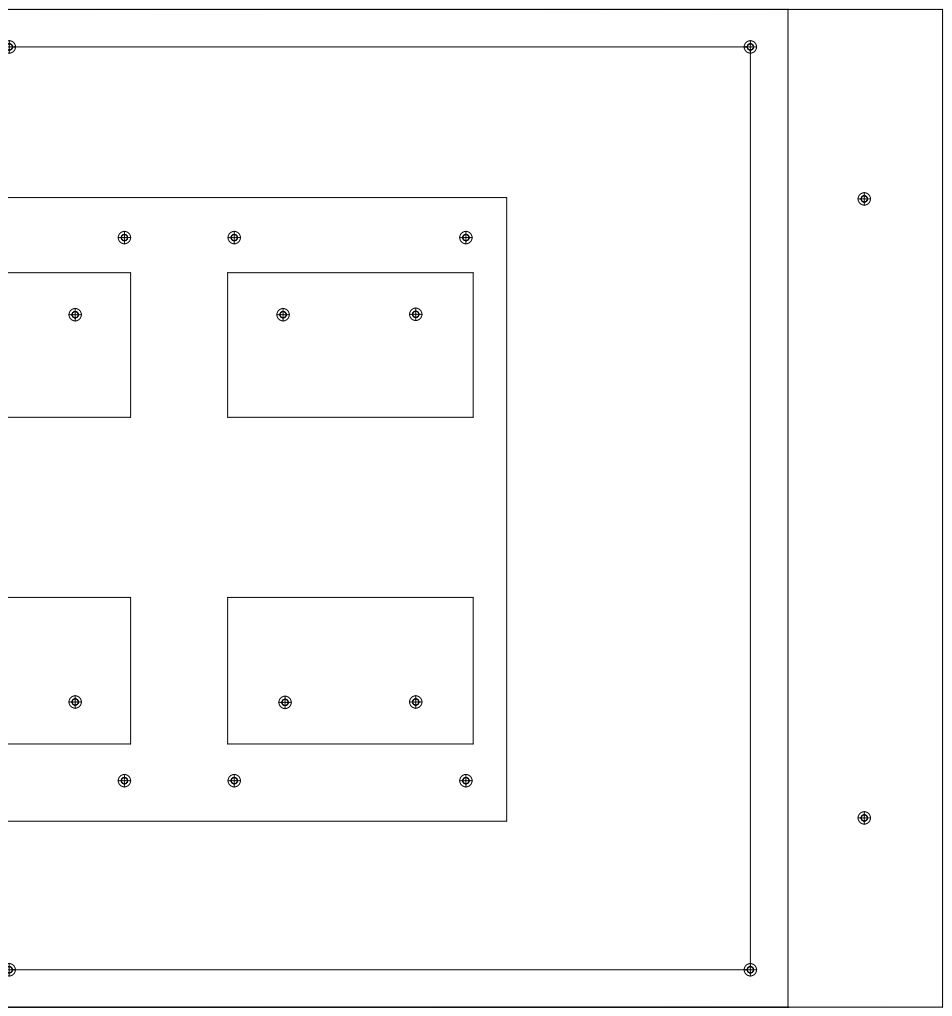
[picture p40: page 2]
