DANTRACX/OpenVFD/vfd_power_module/schematics/vfd_power_module.pdf

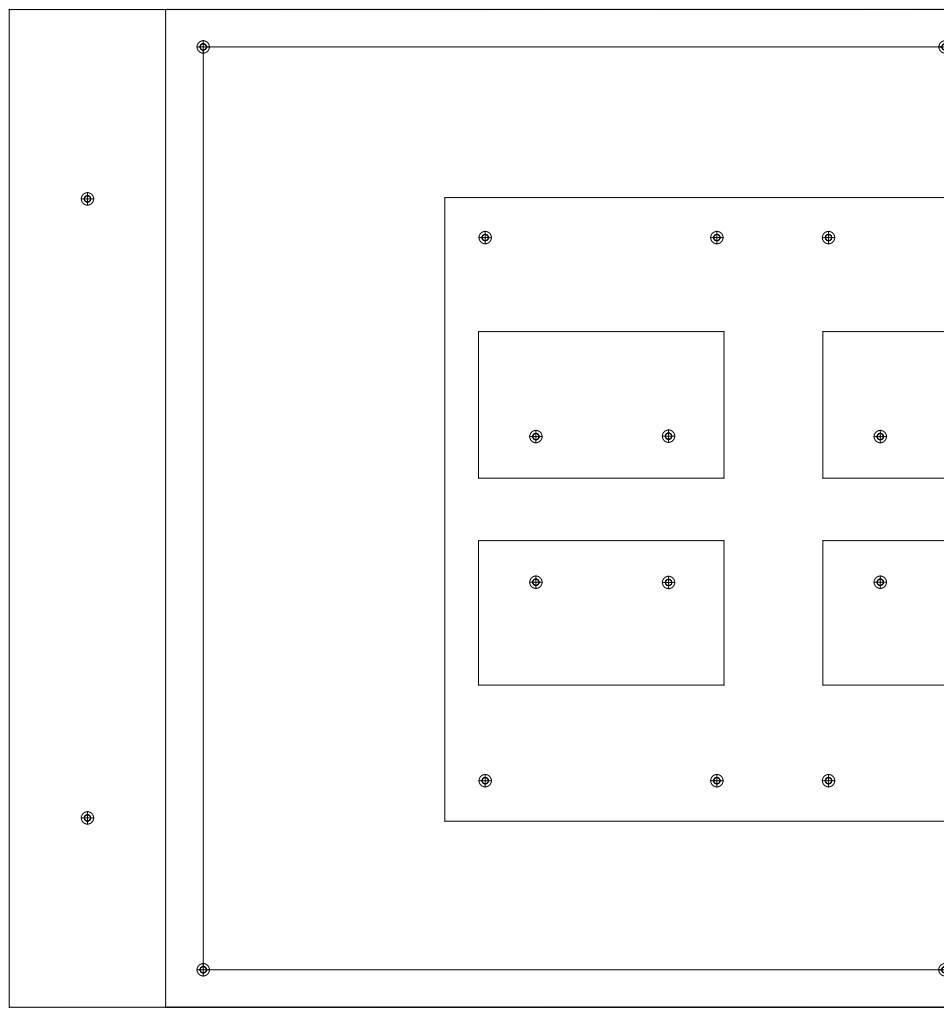
[picture p41: page 1]

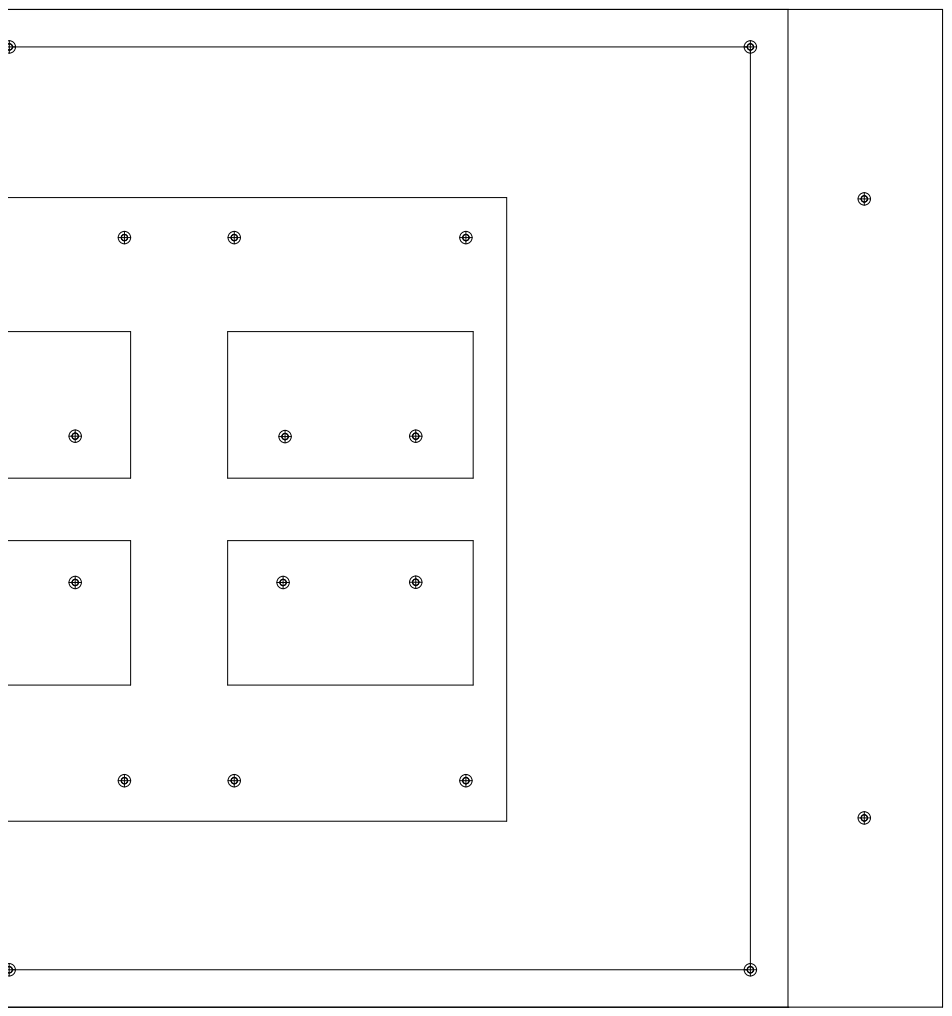
[picture p42: page 2]
