DANTRACX/OpenVFD/vfd_dcbus/schematics/vfd_dcbus_sch.pdf

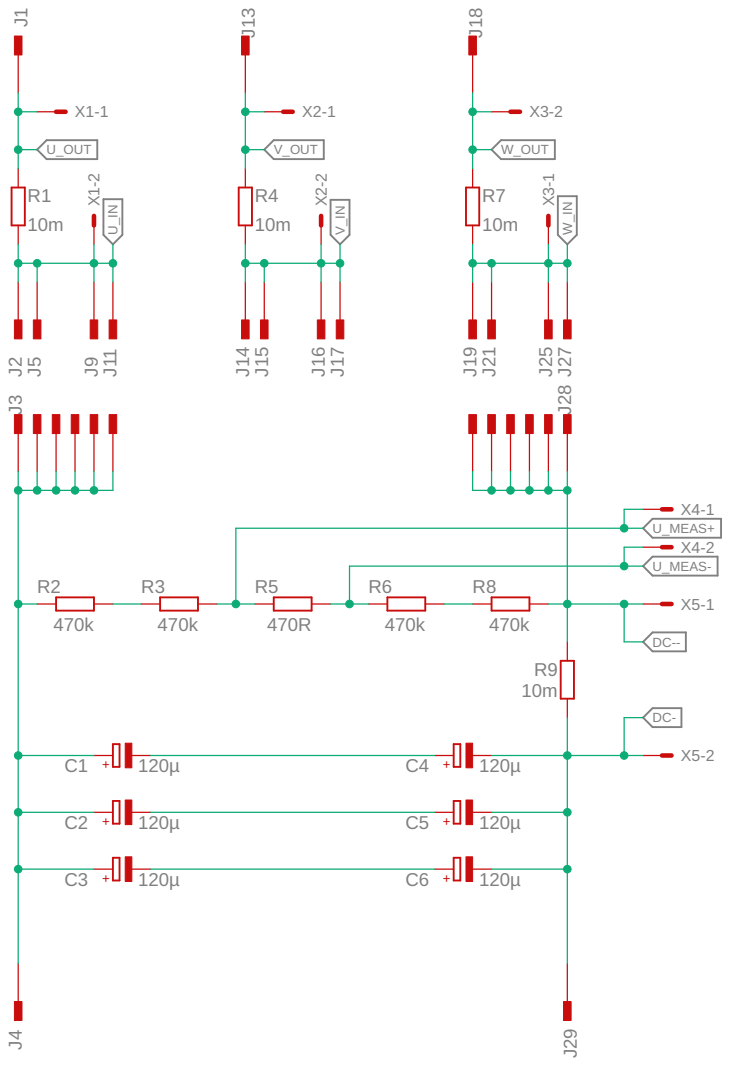
[picture p43: page 1]

Document Number: | REV:

Date: 20.10.19 16:37 | Sheet: 1/1
