DANTRACX/OpenVFD/vfd_controller/schematics/vfd_controller_io.brd

## EAGLE design vfd_controller/schematics/vfd_controller_io.brd (2020-07-18)

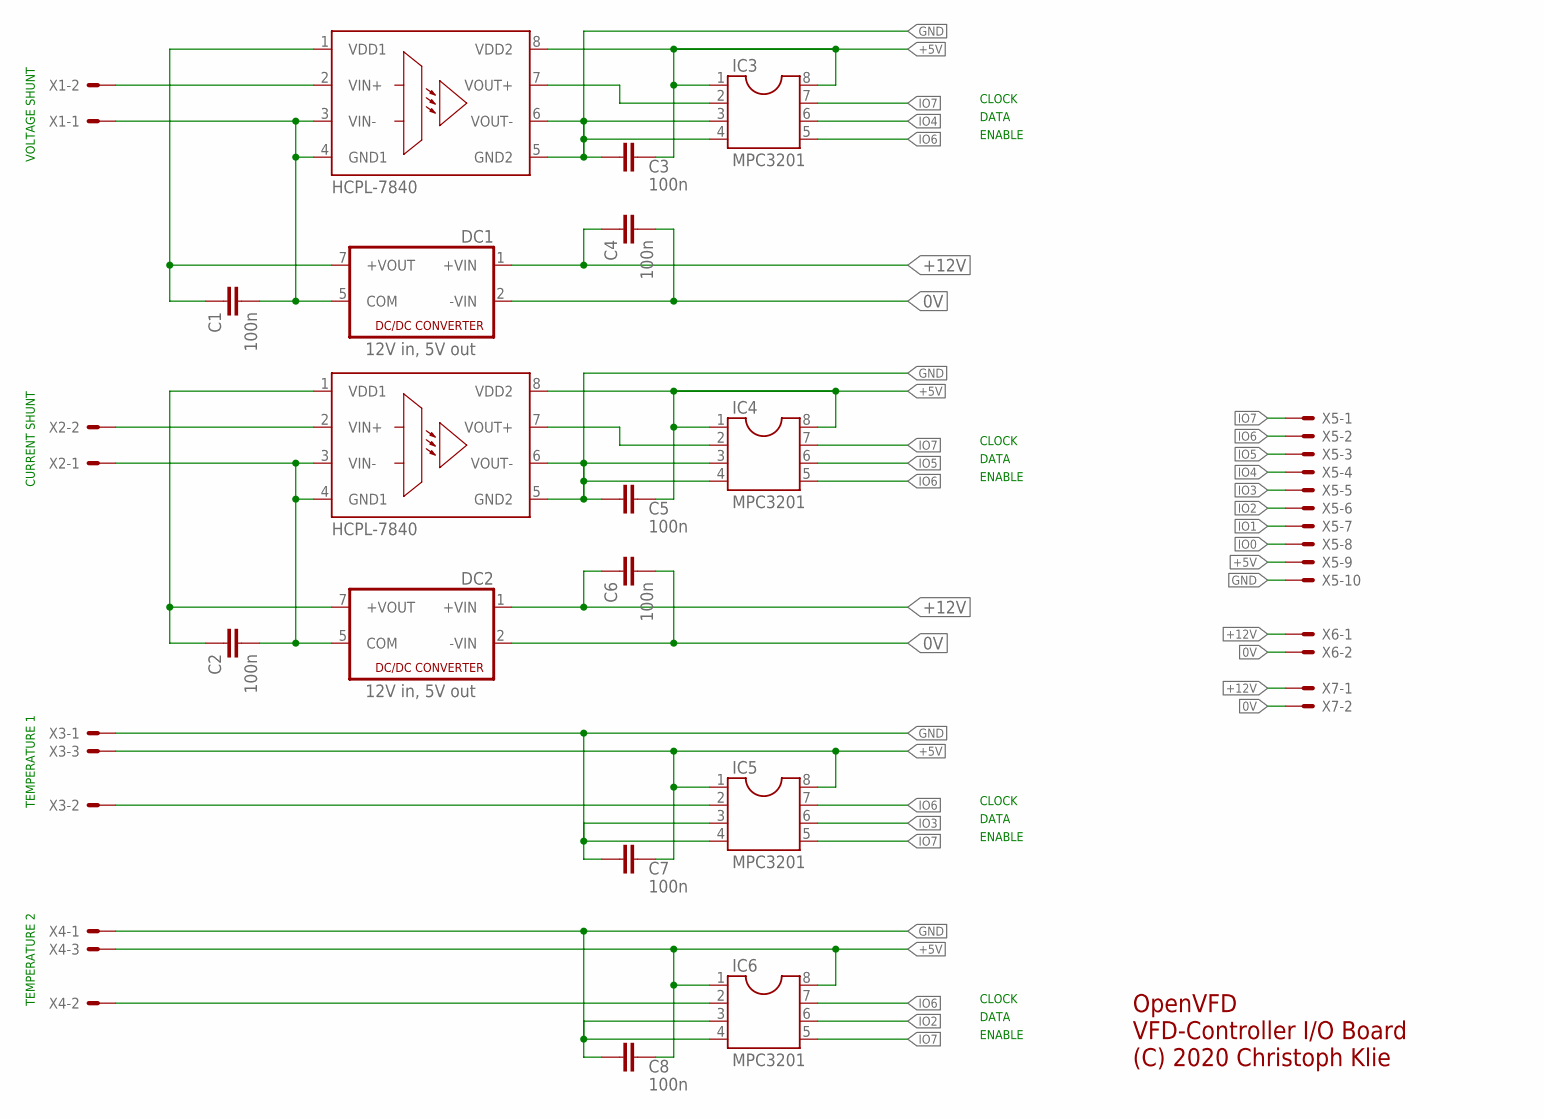
[picture p44: schematic vfd_controller_io.sch]

Parts:
C1, C2, C3, C5, C7, C8: 100n; C050-025X075
C4, C6: 100n; C025-024X044
DC1, DC2: 12V in, 5V out; MEV
IC1, IC2: HCPL-7840; DIL08
IC3, IC4, IC5, IC6: MPC3201; DIL08
X1, X2, X6, X7: JST-XH-02-PIN-LONG-PAD; JST-XH-02-PACKAGE-LONG-PAD
X3, X4: JST-XH-03-PIN-LONG-PAD; JST-XH-03-PACKAGE-LONG-PAD
X5: JST-XH-10-PIN-LONG-PAD; JST-XH-10-PACKAGE-LONG-PAD

Connections:
0V: C4.2, C6.2, DC1.2 (-VIN), DC2.2 (-VIN), X6.2, X7.2
+5V: C3.2, C5.2, C7.2, C8.2, IC1.8 (VDD2), IC2.8 (VDD2), IC3.1, IC3.8, IC4.1, IC4.8, IC5.1, IC5.8, IC6.1, IC6.8, X3.3, X4.3, X5.9
+12V: C4.1, C6.1, DC1.1 (+VIN), DC2.1 (+VIN), X6.1, X7.1
GND: C3.1, C5.1, C7.1, C8.1, IC1.5 (GND2), IC1.6 (VOUT-), IC2.5 (GND2), IC2.6 (VOUT-), IC3.3, IC3.4, IC4.3, IC4.4, IC5.3, IC5.4, IC6.3, IC6.4, X3.1, X4.1, X5.10
IO0: X5.8
IO1: X5.7
IO2: IC6.6, X5.6
IO3: IC5.6, X5.5
IO4: IC3.6, X5.4
IO5: IC4.6, X5.3
IO6: IC3.5, IC4.5, IC5.7, IC6.7, X5.2
IO7: IC3.7, IC4.7, IC5.5, IC6.5, X5.1
unnamed: IC6.2, X4.2
unnamed: IC5.2, X3.2
unnamed: C2.1, DC2.7 (+VOUT), IC2.1 (VDD1)
unnamed: C2.2, DC2.5 (COM), IC2.3 (VIN-), IC2.4 (GND1), X2.1
unnamed: IC1.2 (VIN+), X1.2
unnamed: IC1.7 (VOUT+), IC3.2
unnamed: C1.2, DC1.5 (COM), IC1.3 (VIN-), IC1.4 (GND1), X1.1
unnamed: IC2.2 (VIN+), X2.2
unnamed: C1.1, DC1.7 (+VOUT), IC1.1 (VDD1)
unnamed: IC2.7 (VOUT+), IC4.2

Notes on the sheet:
CLOCK
ENABLE
DATA
VOLTAGE SHUNT
CURRENT SHUNT
TEMPERATURE 1
TEMPERATURE 2
OpenVFD
VFD-Controller I/O Board
(C) 2020 Christoph Klie

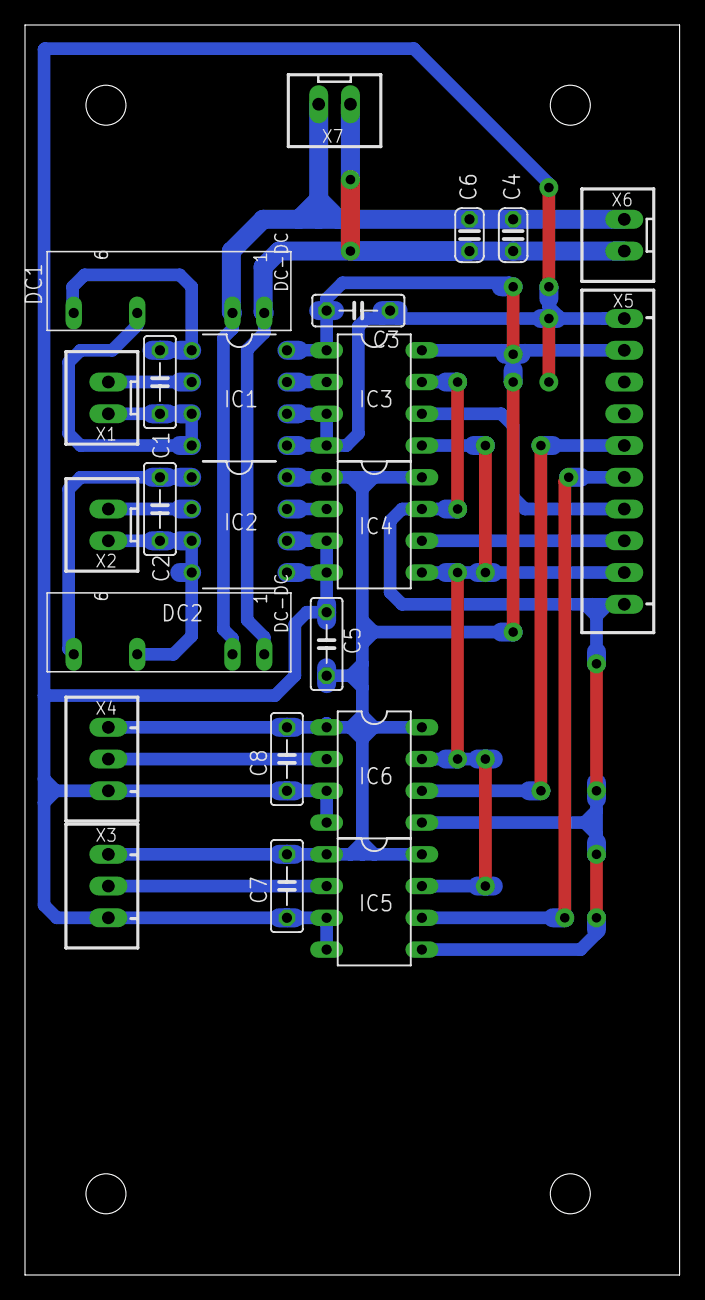
[picture p45: board vfd_controller_io.brd from above]

Board: 2 copper layers, 52.4 x 100.0 mm, 24 parts (0 on the bottom side), 20 nets.

Other parts of the board:
U$1: A4L-LOC
