DANTRACX/OpenVFD/vfd_igbt_driver/schematics/vfd_igbtdriver.brd

## EAGLE design vfd_igbt_driver/schematics/vfd_igbtdriver.brd (2020-07-18)

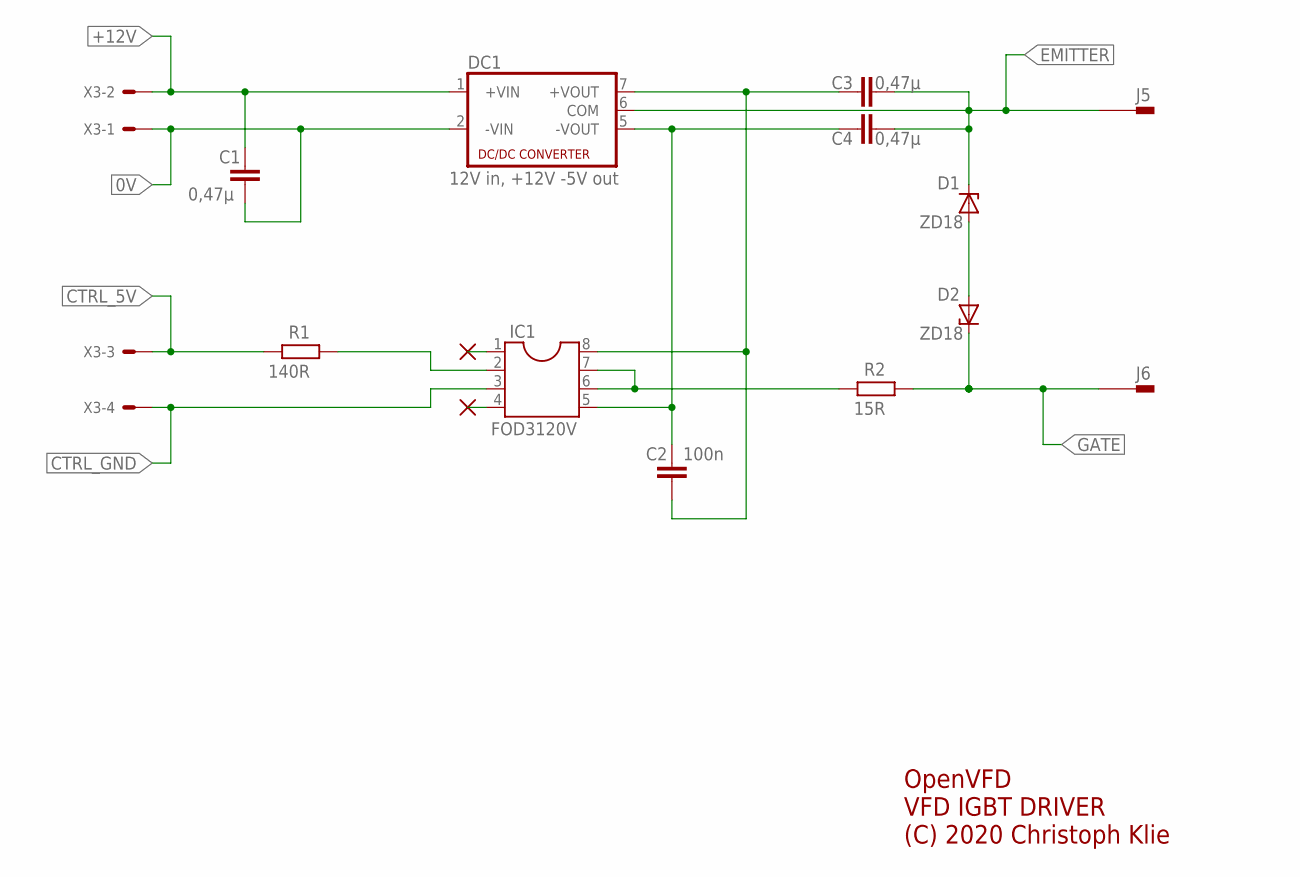
[picture p46: schematic vfd_igbtdriver.sch]

Parts:
C1, C3, C4: 0,47µ; C050-035X075
C2: 100n; C050-025X075
D1, D2: ZD18; DO35Z10
DC1: 12V in, +12V -5V out; MGJ2
IC1: FOD3120V; DIL08
J5, J6: PIN2F061.040; F061.040
R1: 140R; 0204/7
R2: 15R; 0617/22
X3: JST-XH-04-PIN-LONG-PAD; JST-XH-04-PACKAGE-LONG-PAD

Connections:
0V: C1.2, DC1.2 (-VIN), X3.1
+12V: C1.1, DC1.1 (+VIN), X3.2
CTRL_5V: R1.2, X3.3
CTRL_GND: IC1.3, X3.4
EMITTER: C3.2, C4.1, D1.C, DC1.6 (COM), J5.A1, J5.A2
GATE: D2.C, J6.A1, J6.A2, R2.1
unnamed: C2.1, C4.2, DC1.5 (-VOUT), IC1.5
unnamed: C2.2, C3.1, DC1.7 (+VOUT), IC1.8
unnamed: IC1.6, IC1.7, R2.2
unnamed: IC1.2, R1.1
unnamed: D1.A, D2.A

Notes on the sheet:
OpenVFD
VFD IGBT DRIVER
(C) 2020 Christoph Klie

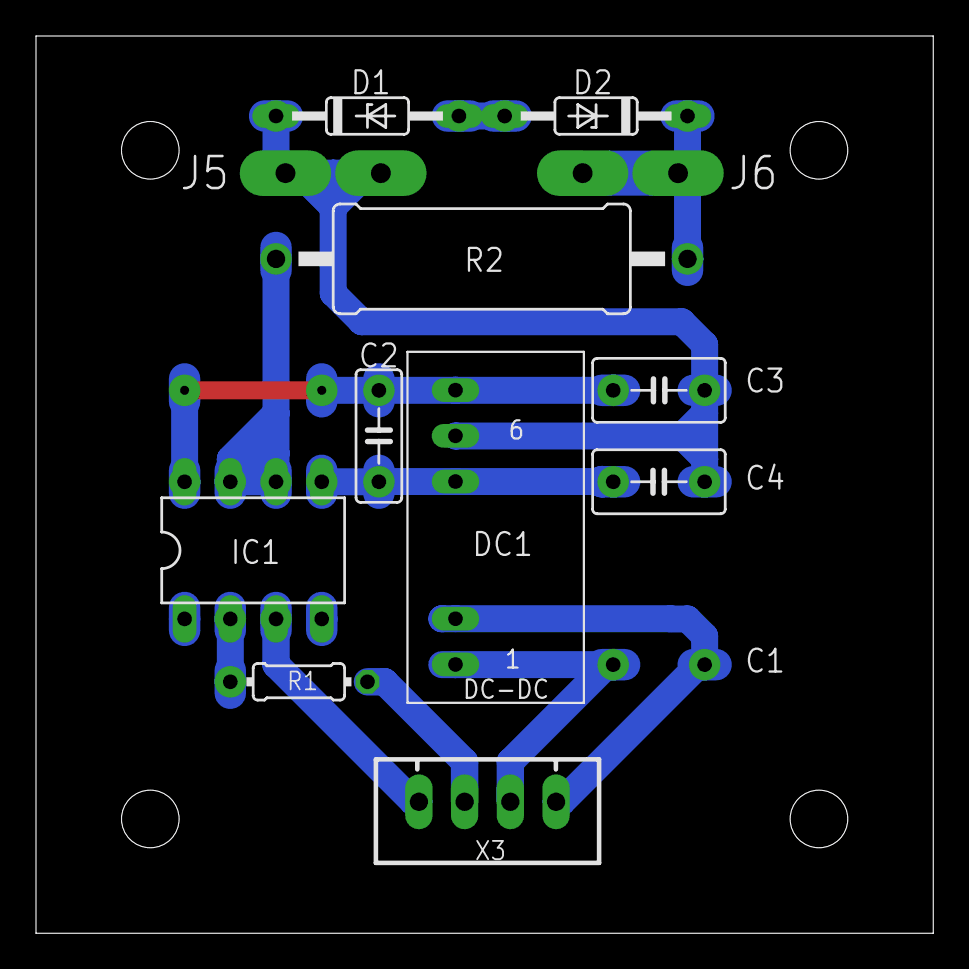
[picture p47: board vfd_igbtdriver.brd from above]

Board: 2 copper layers, 49.8 x 49.8 mm, 14 parts (1 on the bottom side), 11 nets.

Other parts of the board:
U$1: A4L-LOC
