DANTRACX/OpenVFD/vfd_dcbus/schematics/vfd_dcbus.brd

## EAGLE design vfd_dcbus/schematics/vfd_dcbus.brd (2020-07-18)

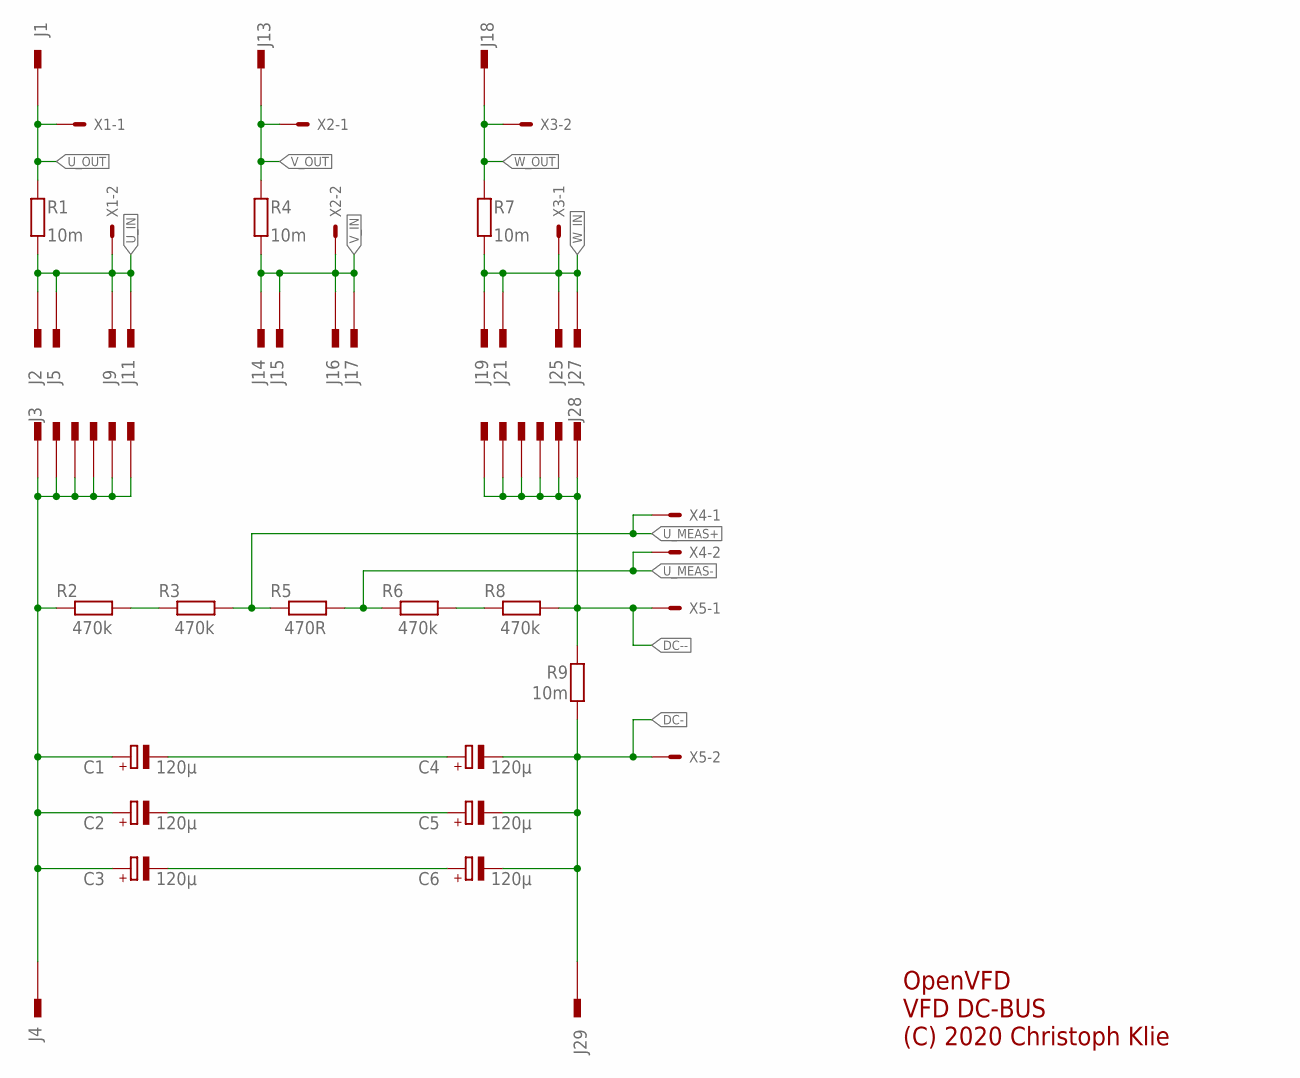
[picture p48: schematic vfd_dcbus.sch]

Parts:
C1, C2, C3, C4, C5, C6: 120µ; EB25D
J1, J4, J13, J18, J29: PIN2F061.200; F061.200
J2, J3, J5, J6, J7, J8, J9, J10, J11, J12, J14, J15, J16, J17, J19, J20, J21, J22, J23, J24, J25, J26, J27, J28: PIN2F061.080; F061.080
R1, R4, R7, R9: 10m; R2512
R2, R3, R6, R8: 470k; 0207/5V
R5: 470R; R1206
X1, X2, X3, X4, X5: JST-XH-02-PIN-LONG-PAD; JST-XH-02-PACKAGE-LONG-PAD

Connections:
DC+: C1.+, C2.+, C3.+, J3.1A, J3.1B, J4.1A, J4.1B, J6.1A, J6.1B, J7.1A, J7.1B, J8.1A, J8.1B, J10.1A, J10.1B, J12.1A, J12.1B, R2.2
DC-: C4.-, C5.-, C6.-, J29.1A, J29.1B, R9.1, X5.2
DC--: J20.1A, J20.1B, J22.1A, J22.1B, J23.1A, J23.1B, J24.1A, J24.1B, J26.1A, J26.1B, J28.1A, J28.1B, R8.2, R9.2, X5.1
unnamed: R2.1, R3.1
unnamed: R6.1, R8.1
unnamed: C1.-, C4.+
unnamed: C2.-, C5.+
unnamed: C3.-, C6.+
U_IN: J2.1A, J2.1B, J5.1A, J5.1B, J9.1A, J9.1B, J11.1A, J11.1B, R1.1, X1.2
U_MEAS+: R3.2, R5.1, X4.1
U_MEAS-: R5.2, R6.2, X4.2
U_OUT: J1.1A, J1.1B, R1.2, X1.1
V_IN: J14.1A, J14.1B, J15.1A, J15.1B, J16.1A, J16.1B, J17.1A, J17.1B, R4.1, X2.2
V_OUT: J13.1A, J13.1B, R4.2, X2.1
W_IN: J19.1A, J19.1B, J21.1A, J21.1B, J25.1A, J25.1B, J27.1A, J27.1B, R7.1, X3.1
W_OUT: J18.1A, J18.1B, R7.2, X3.2

Notes on the sheet:
OpenVFD
VFD DC-BUS
(C) 2020 Christoph Klie

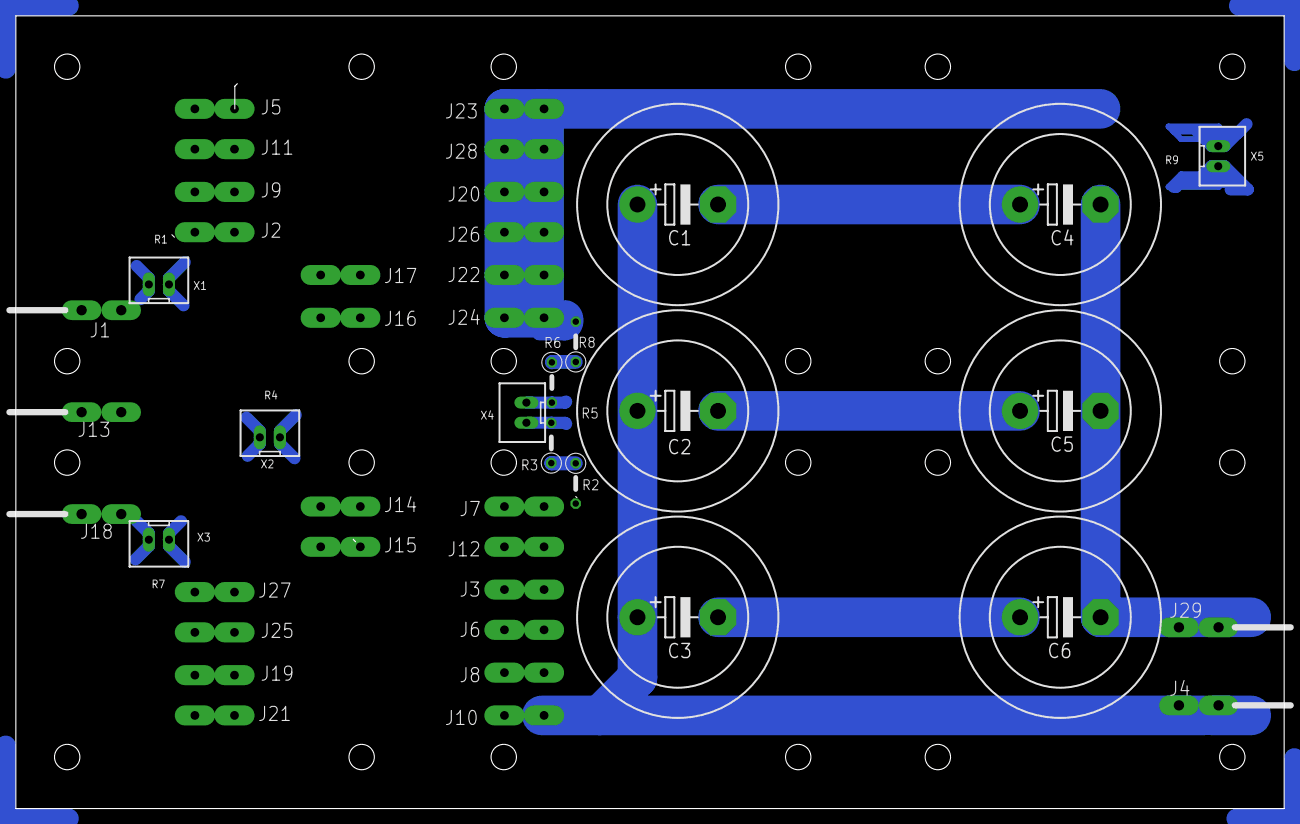
[picture p49: board vfd_dcbus.brd from above]

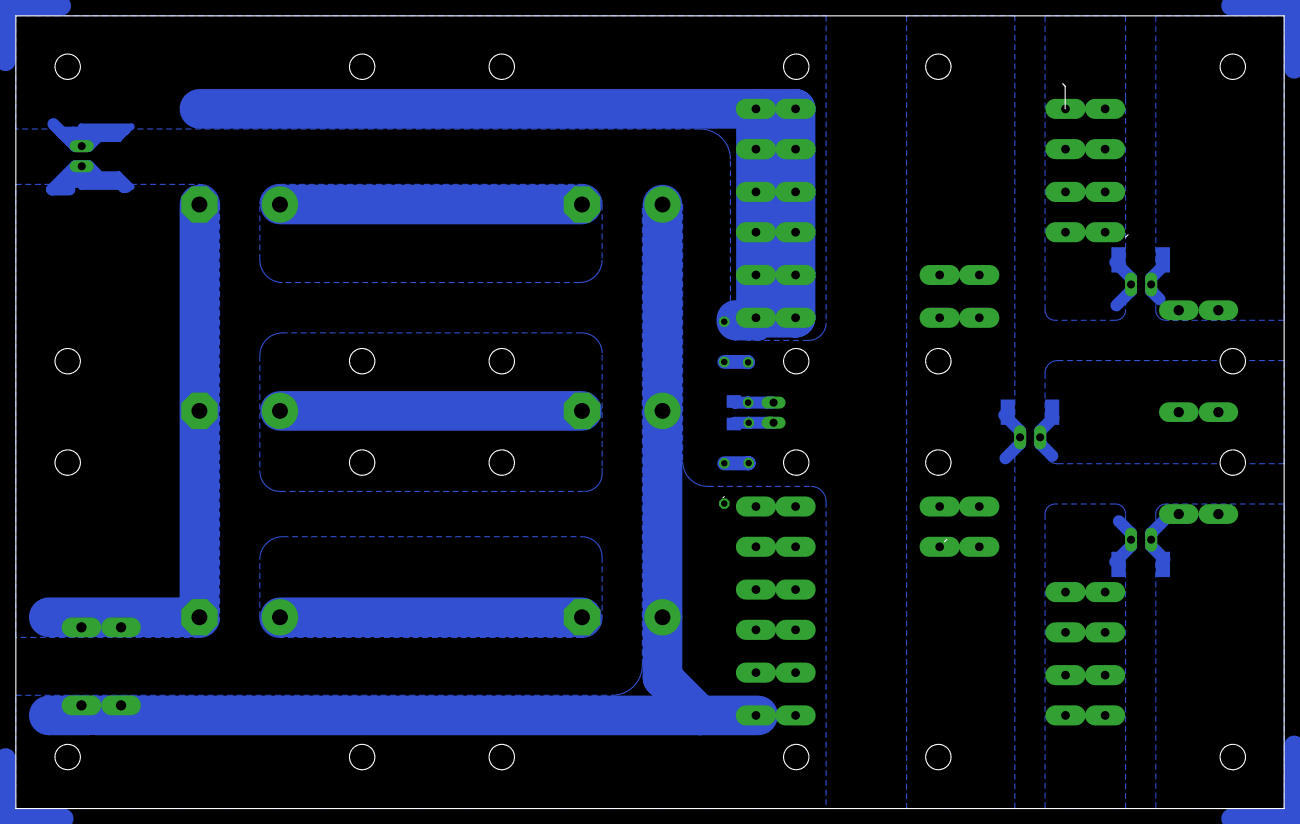
[picture p50: board vfd_dcbus.brd from below]

Board: 2 copper layers, 160.0 x 100.0 mm, 50 parts (5 on the bottom side), 16 nets.

Other parts of the board:
U$1: A4L-LOC
