DANTRACX/OpenVFD/vfd_controller/schematics/vfd_controller_cpu.brd

## EAGLE design vfd_controller/schematics/vfd_controller_cpu.brd (2020-07-18)

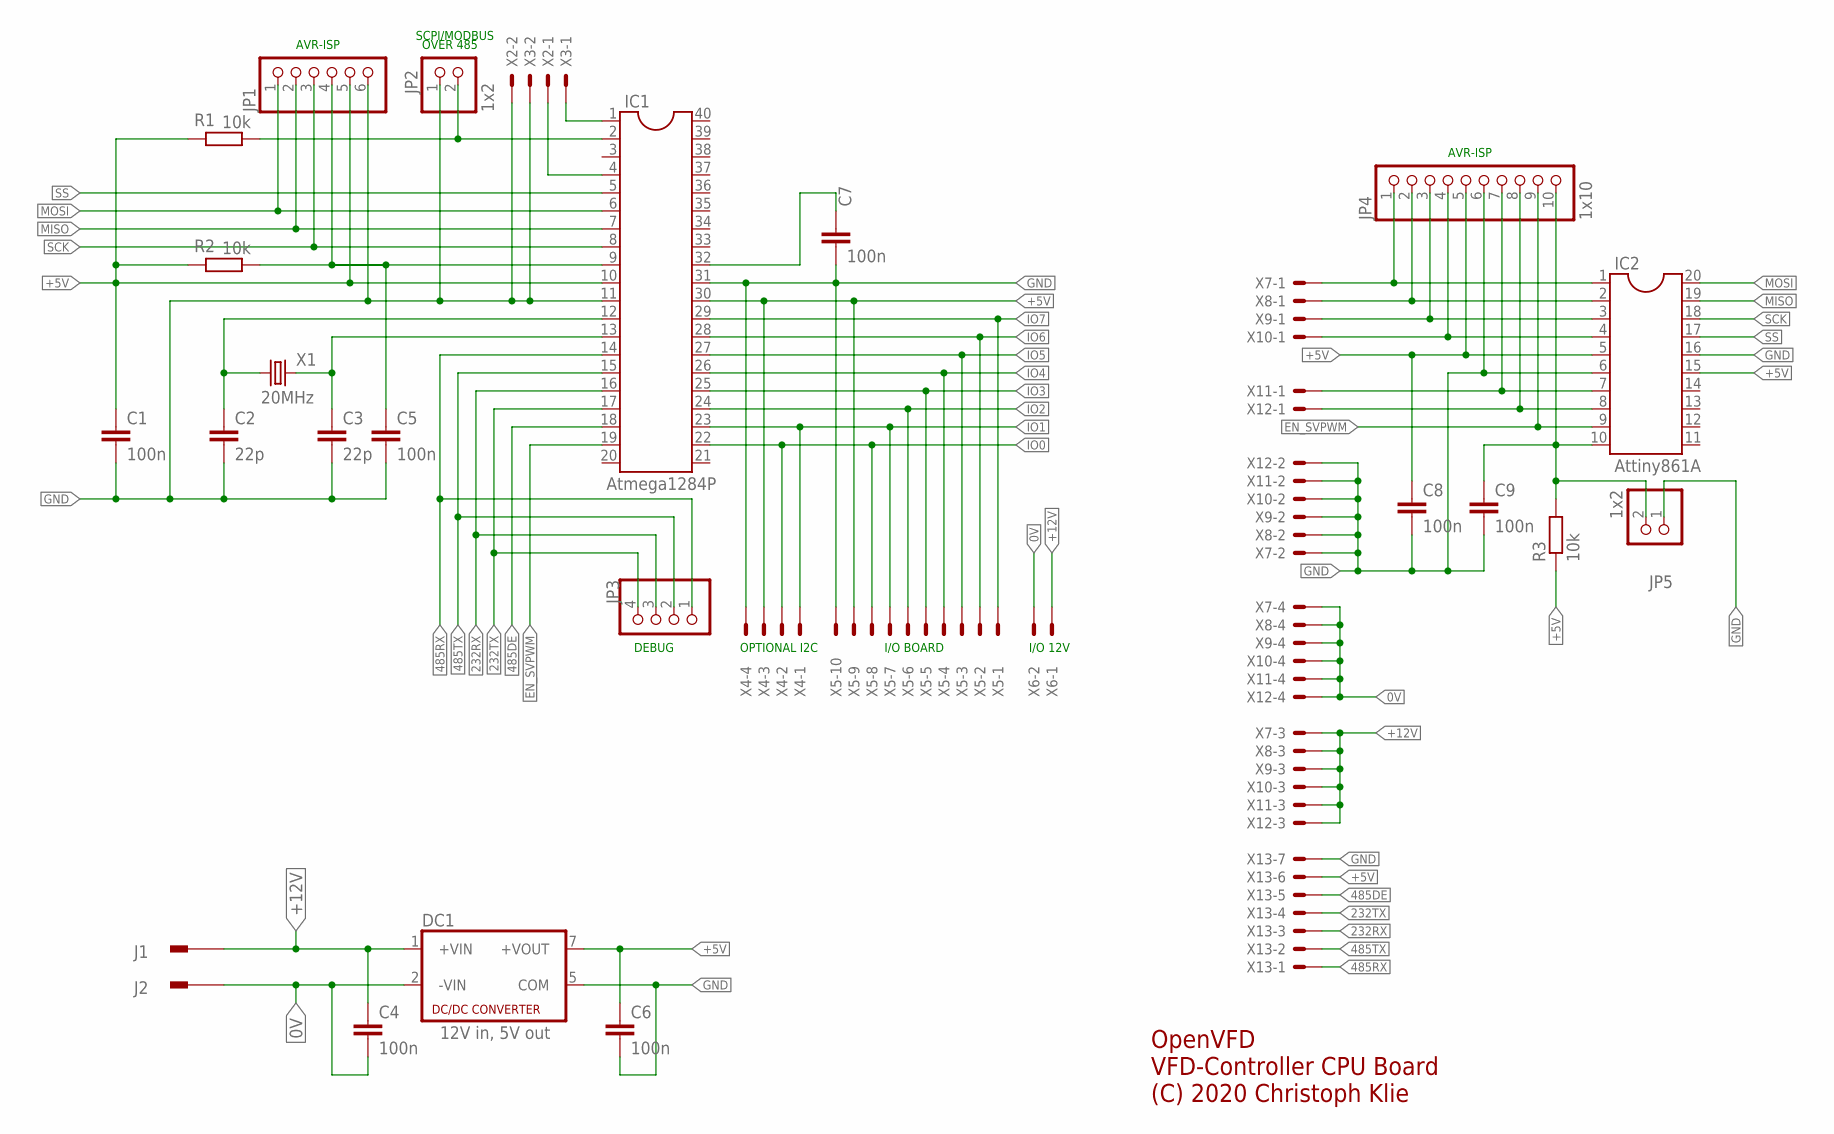
[picture p51: schematic vfd_controller_cpu.sch]

Parts:
C1, C4, C7, C8, C9: 100n; C025-024X044
C2, C3: 22p; C025-024X044
C5, C6: 100n; C050-025X075
DC1: 12V in, 5V out; MEV
IC1: Atmega1284P; DIL40
IC2: Attiny861A; DIL20
J1, J2: F061.200
JP1: 1x6; 1X06
JP2, JP5: 1x2; 1X02
JP3: 1x4; 1X04
JP4: 1x10; 1X10
R1, R3: 10k; 0207/12
R2: 10k; 0204V
X1: 20MHz; HC49
X2, X3, X6: JST-XH-02-PIN-LONG-PAD; JST-XH-02-PACKAGE-LONG-PAD
X4, X7, X8, X9, X10, X11, X12: JST-XH-04-PIN-LONG-PAD; JST-XH-04-PACKAGE-LONG-PAD
X5: JST-XH-10-PIN-LONG-PAD; JST-XH-10-PACKAGE-LONG-PAD
X13: JST-XH-07-PIN-LONG-PAD; JST-XH-07-PACKAGE-LONG-PAD

Connections:
0V: C4.2, DC1.2 (-VIN), J2.1A, J2.1B, X6.2, X7.4, X8.4, X9.4, X10.4, X11.4, X12.4
232RX: IC1.16, JP3.3, X13.3
232TX: IC1.17, JP3.4, X13.4
485DE: IC1.18, X13.5
485RX: IC1.14, JP3.1, X13.1
485TX: IC1.15, JP3.2, X13.2
+5V: C1.1, C6.1, C8.1, DC1.7 (+VOUT), IC1.10, IC1.30, IC2.5, IC2.15, JP1.5, JP4.5, R1.2, R2.2, R3.1, X4.3, X5.9, X13.6
+12V: C4.1, DC1.1 (+VIN), J1.1A, J1.1B, X6.1, X7.3, X8.3, X9.3, X10.3, X11.3, X12.3
EN_SVPWM: IC1.19, IC2.9, JP4.9
GND: C1.2, C2.2, C3.2, C5.2, C6.2, C7.2, C8.2, C9.2, DC1.5 (COM), IC1.11, IC1.31, IC2.6, IC2.16, JP1.6, JP2.1, JP4.6, JP5.1, X2.2, X3.2, X4.4, X5.10, X7.2, X8.2, X9.2, X10.2, X11.2, X12.2, X13.7
H1: IC2.1, JP4.1, X7.1
H2: IC2.3, JP4.3, X9.1
H3: IC2.7, JP4.7, X11.1
IO0: IC1.22, X4.2, X5.8
IO1: IC1.23, X4.1, X5.7
IO2: IC1.24, X5.6
IO3: IC1.25, X5.5
IO4: IC1.26, X5.4
IO5: IC1.27, X5.3
IO6: IC1.28, X5.2
IO7: IC1.29, X5.1
L1: IC2.2, JP4.2, X8.1
L2: IC2.4, JP4.4, X10.1
L3: IC2.8, JP4.8, X12.1
MISO: IC1.7, IC2.19, JP1.2
MOSI: IC1.6, IC2.20, JP1.1
unnamed: IC1.1, X3.1
unnamed: C7.1, IC1.32
unnamed: IC1.4, X2.1
unnamed: IC1.2, JP2.2, R1.1
unnamed: C9.1, IC2.10, JP4.10, JP5.2, R3.2
unnamed: C5.1, IC1.9, JP1.4, R2.1
unnamed: C2.1, IC1.12, X1.1
unnamed: C3.1, IC1.13, X1.2
SCK: IC1.8, IC2.18, JP1.3
SS: IC1.5, IC2.17

Notes on the sheet:
AVR-ISP
OPTIONAL I2C
I/O BOARD
I/O 12V
SCPI/MODBUS
OVER 485
DEBUG
OpenVFD
(C) 2020 Christoph Klie
VFD-Controller CPU Board

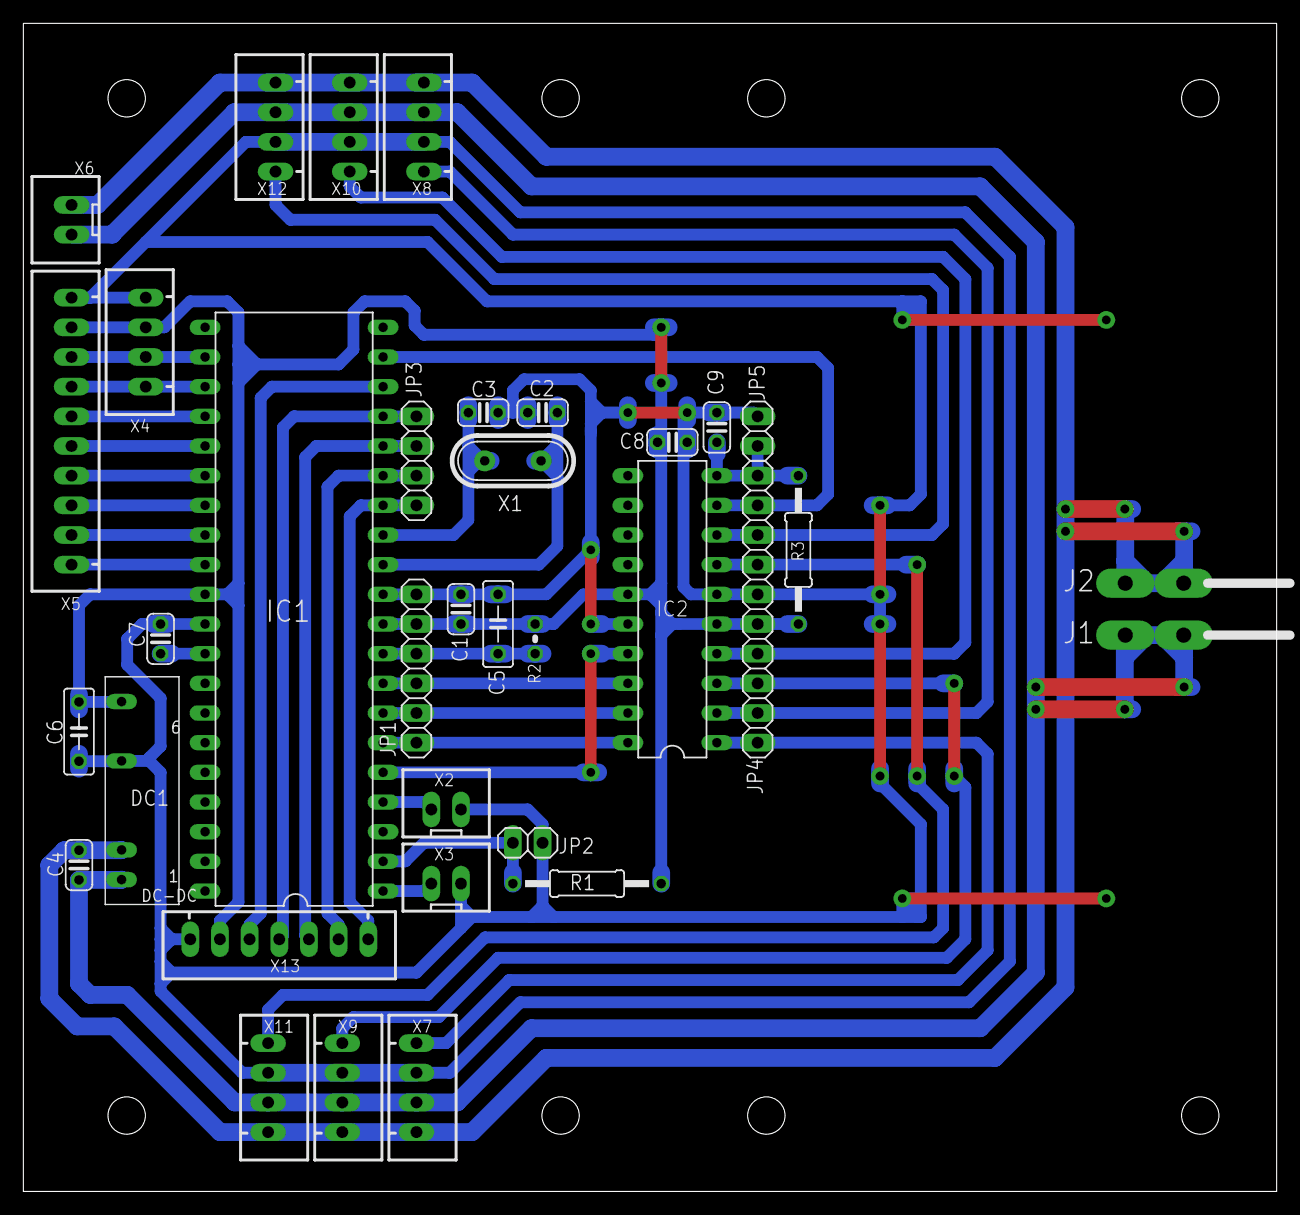
[picture p52: board vfd_controller_cpu.brd from above]

Board: 2 copper layers, 107.3 x 100.0 mm, 36 parts (0 on the bottom side), 36 nets.

Other parts of the board:
U$1: A4L-LOC
