DANTRACX/OpenVFD/vfd_controller/schematics/vfd_controller_com.brd

## EAGLE design vfd_controller/schematics/vfd_controller_com.brd (2020-07-17)

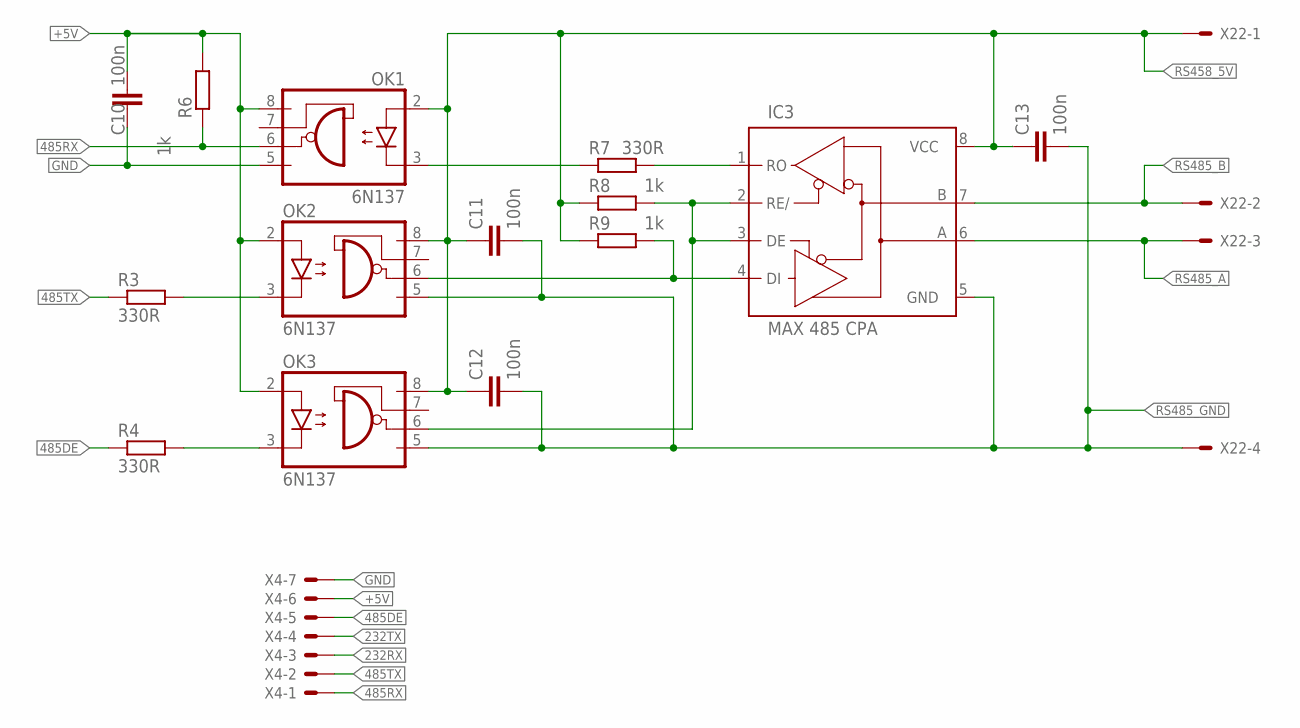
[picture p53: schematic vfd_controller_com.sch]

Parts:
C10, C11, C12, C13: 100n; C025-024X044
IC3: MAX 485 CPA; DIL08
OK1, OK2, OK3: 6N137; DIL08
R3, R4, R7: 330R; 0204/7
R6, R8, R9: 1k; 0204/7
X4: JST-XH-07-PIN-LONG-PAD; JST-XH-07-PACKAGE-LONG-PAD
X22: JST-XH-04-PIN-LONG-PAD; JST-XH-04-PACKAGE-LONG-PAD

Connections:
232RX: X4.3
232TX: X4.4
485DE: R4.1, X4.5
485RX: OK1.6 (VO), R6.1, X4.1
485TX: R3.1, X4.2
+5V: C10.2, OK1.8 (VCC), OK2.2 (A), OK3.2 (A), R6.2, X4.6
GND: C10.1, OK1.5 (GND), X4.7
unnamed: IC3.2 (RE/), IC3.3 (DE), OK3.6 (VO), R8.2
unnamed: IC3.1 (RO), R7.2
unnamed: OK1.3 (C), R7.1
unnamed: IC3.4 (DI), OK2.6 (VO), R9.2
unnamed: OK3.3 (C), R4.2
unnamed: OK2.3 (C), R3.2
RS458_5V: C11.1, C12.1, C13.1, IC3.8 (VCC), OK1.2 (A), OK2.8 (VCC), OK3.8 (VCC), R8.1, R9.1, X22.1
RS485_A: IC3.6 (A), X22.3
RS485_B: IC3.7 (B), X22.2
RS485_GND: C11.2, C12.2, C13.2, IC3.5 (GND), OK2.5 (GND), OK3.5 (GND), X22.4

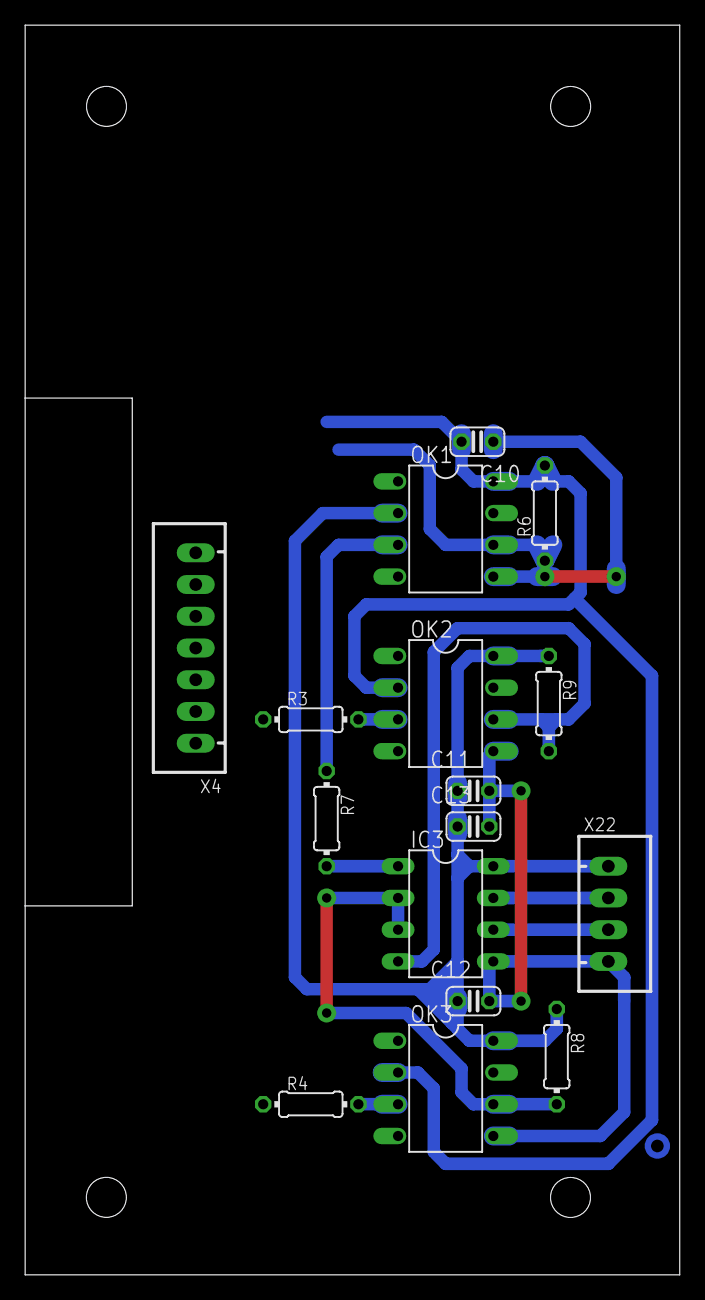
[picture p54: board vfd_controller_com.brd from above]

Board: 2 copper layers, 52.4 x 100.0 mm, 17 parts (0 on the bottom side), 15 nets.

Other parts of the board:
U$1: A4L-LOC
