DANTRACX/OpenVFD/vfd_igbt_driver/schematics/vfd_igbtdriver_brd_production.brd

## EAGLE design vfd_igbt_driver/schematics/vfd_igbtdriver_brd_production.brd (2020-07-18)

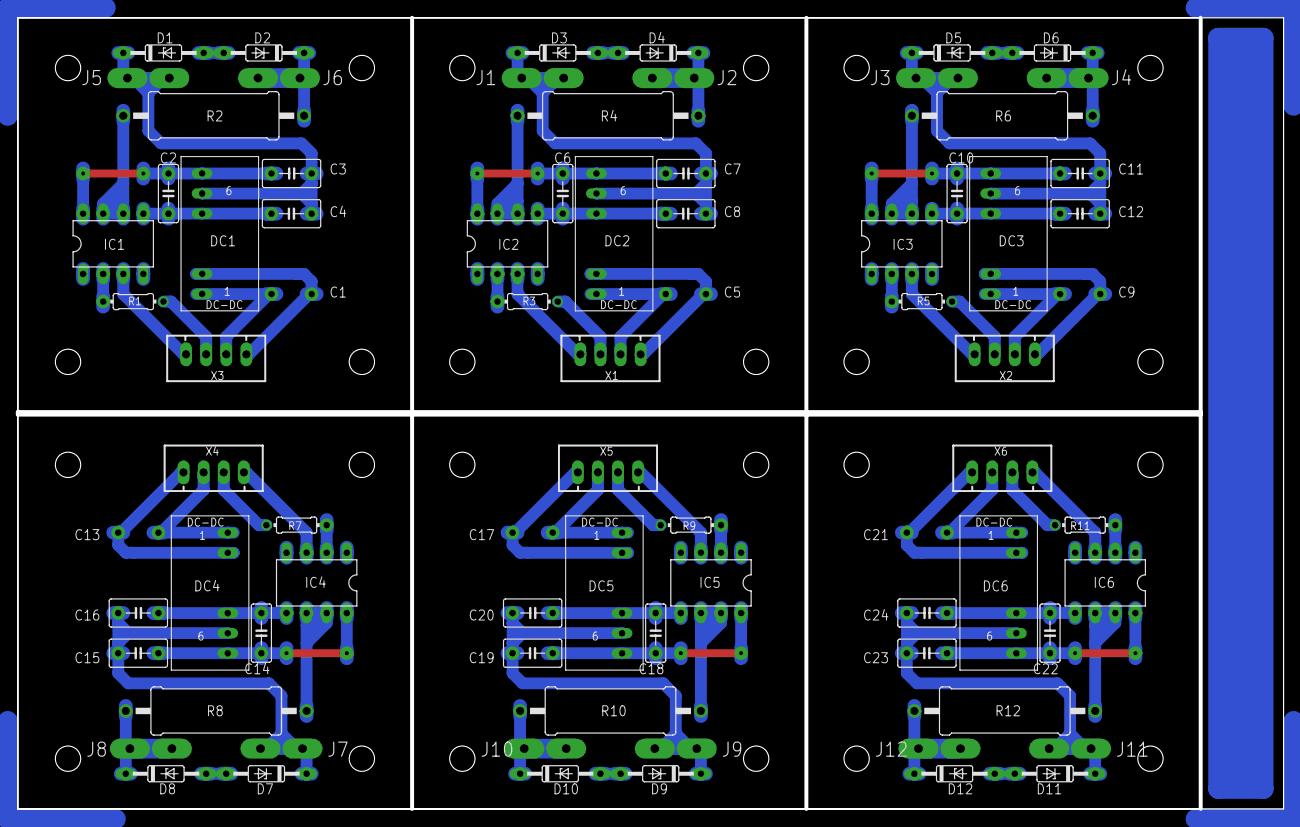
[picture p55: board vfd_igbtdriver_brd_production.brd from above]

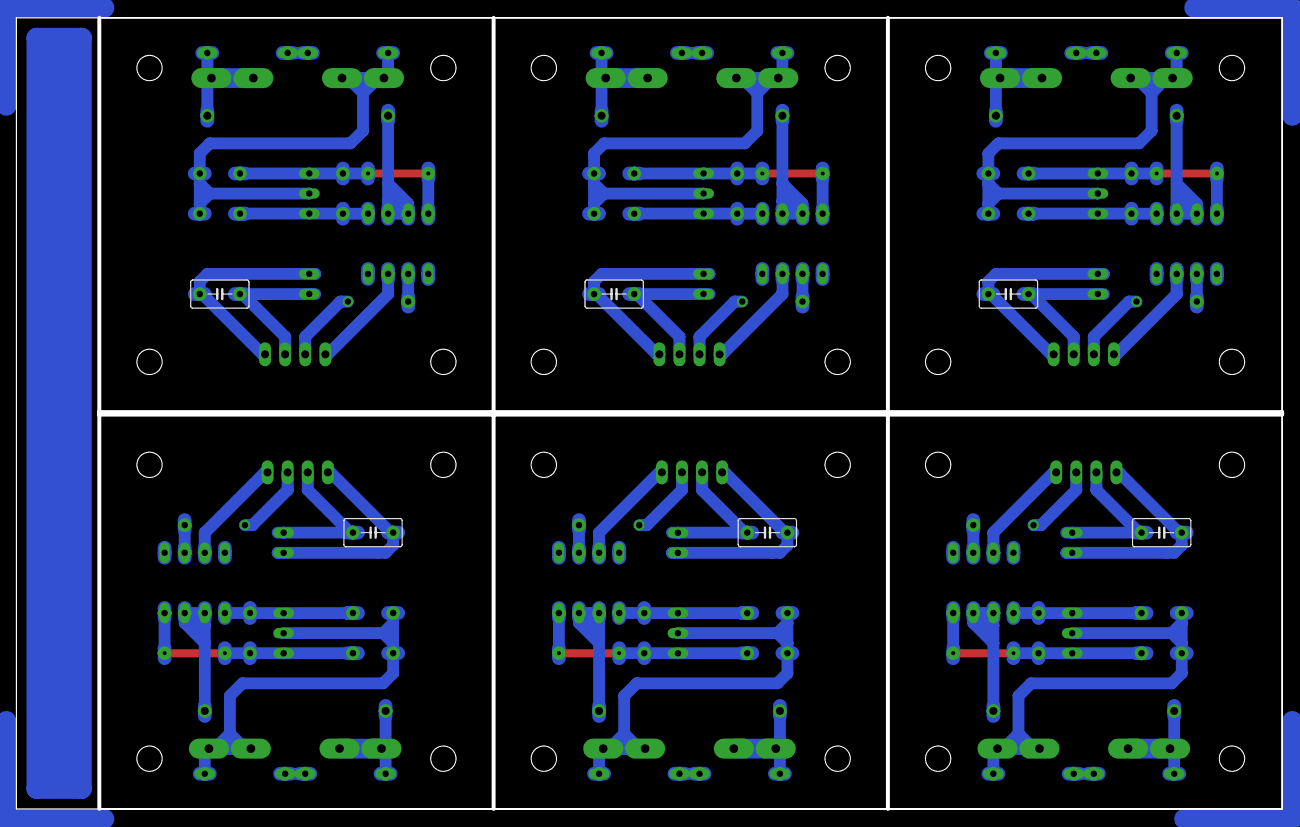
[picture p56: board vfd_igbtdriver_brd_production.brd from below]

Board: 2 copper layers, 160.0 x 100.0 mm, 79 parts (6 on the bottom side), 66 nets.

Parts:
C1, C3, C4, C5, C7, C8, C9, C11, C12, C13, C15, C16, C17, C19, C20, C21, C23, C24: 0,47µ; C050-035X075
C2, C6, C10, C14, C18, C22: 100n; C050-025X075
D1, D2, D3, D4, D5, D6, D7, D8, D9, D10, D11, D12: ZD18; DO35Z10
DC1, DC2, DC3, DC4, DC5, DC6: 12V in, +12V -5V out; MGJ2
E$1: A4L-LOC
IC1, IC2, IC3, IC4, IC5, IC6: FOD3120V; DIL08
J1, J2, J3, J4, J5, J6, J7, J8, J9, J10, J11, J12: F061.040
R1, R3, R5, R7, R9, R11: 140R; 0204/7
R2, R4, R6, R8, R10, R12: 15R; 0617/22
X1, X2, X3, X4, X5, X6: JST-XH-04-PIN-LONG-PAD; JST-XH-04-PACKAGE-LONG-PAD

Connections:
0V: C1.2, DC1.2, X3.1
0V1: C5.2, DC2.2, X1.1
0V2: C9.2, DC3.2, X2.1
0V3: C13.2, DC4.2, X4.1
0V4: C17.2, DC5.2, X5.1
0V5: C21.2, DC6.2, X6.1
+12V: C1.1, DC1.1, X3.2
+12V1: C5.1, DC2.1, X1.2
+12V2: C9.1, DC3.1, X2.2
+12V3: C13.1, DC4.1, X4.2
+12V4: C17.1, DC5.1, X5.2
+12V5: C21.1, DC6.1, X6.2
CTRL_5V: R1.2, X3.3
CTRL_5V1: R3.2, X1.3
CTRL_5V2: R5.2, X2.3
CTRL_5V3: R7.2, X4.3
CTRL_5V4: R9.2, X5.3
CTRL_5V5: R11.2, X6.3
CTRL_GND: IC1.3, X3.4
CTRL_GND1: IC2.3, X1.4
CTRL_GND2: IC3.3, X2.4
CTRL_GND3: IC4.3, X4.4
CTRL_GND4: IC5.3, X5.4
CTRL_GND5: IC6.3, X6.4
EMITTER: C3.2, C4.1, D1.C, DC1.6, J5.A1, J5.A2
EMITTER1: C7.2, C8.1, D3.C, DC2.6, J1.A1, J1.A2
EMITTER2: C11.2, C12.1, D5.C, DC3.6, J3.A1, J3.A2
EMITTER3: C15.2, C16.1, D7.C, DC4.6, J7.A1, J7.A2
EMITTER4: C19.2, C20.1, D9.C, DC5.6, J9.A1, J9.A2
EMITTER5: C23.2, C24.1, D11.C, DC6.6, J11.A1, J11.A2
GATE: D2.C, J6.A1, J6.A2, R2.1
GATE1: D4.C, J2.A1, J2.A2, R4.1
GATE2: D6.C, J4.A1, J4.A2, R6.1
GATE3: D8.C, J8.A1, J8.A2, R8.1
GATE4: D10.C, J10.A1, J10.A2, R10.1
GATE5: D12.C, J12.A1, J12.A2, R12.1
unnamed: C2.1, C4.2, DC1.5, IC1.5
unnamed: C2.2, C3.1, DC1.7, IC1.8
unnamed: IC1.6, IC1.7, R2.2
unnamed: IC1.2, R1.1
unnamed: C6.1, C8.2, DC2.5, IC2.5
unnamed: D1.A, D2.A
unnamed: C6.2, C7.1, DC2.7, IC2.8
unnamed: IC2.6, IC2.7, R4.2
unnamed: D3.A, D4.A
unnamed: IC2.2, R3.1
unnamed: C10.1, C12.2, DC3.5, IC3.5
unnamed: C10.2, C11.1, DC3.7, IC3.8
unnamed: IC3.6, IC3.7, R6.2
unnamed: D5.A, D6.A
unnamed: IC3.2, R5.1
unnamed: C14.1, C16.2, DC4.5, IC4.5
unnamed: C14.2, C15.1, DC4.7, IC4.8
unnamed: IC4.6, IC4.7, R8.2
unnamed: D7.A, D8.A
unnamed: IC4.2, R7.1
unnamed: C18.1, C20.2, DC5.5, IC5.5
unnamed: C18.2, C19.1, DC5.7, IC5.8
unnamed: IC5.6, IC5.7, R10.2
unnamed: D9.A, D10.A
unnamed: IC5.2, R9.1
unnamed: C22.1, C24.2, DC6.5, IC6.5
unnamed: C22.2, C23.1, DC6.7, IC6.8
unnamed: IC6.6, IC6.7, R12.2
unnamed: D11.A, D12.A
unnamed: IC6.2, R11.1
