DANTRACX/OpenVFD/vfd_controller/schematics/vfd_controller_production.brd

## EAGLE design vfd_controller/schematics/vfd_controller_production.brd (2020-07-17)

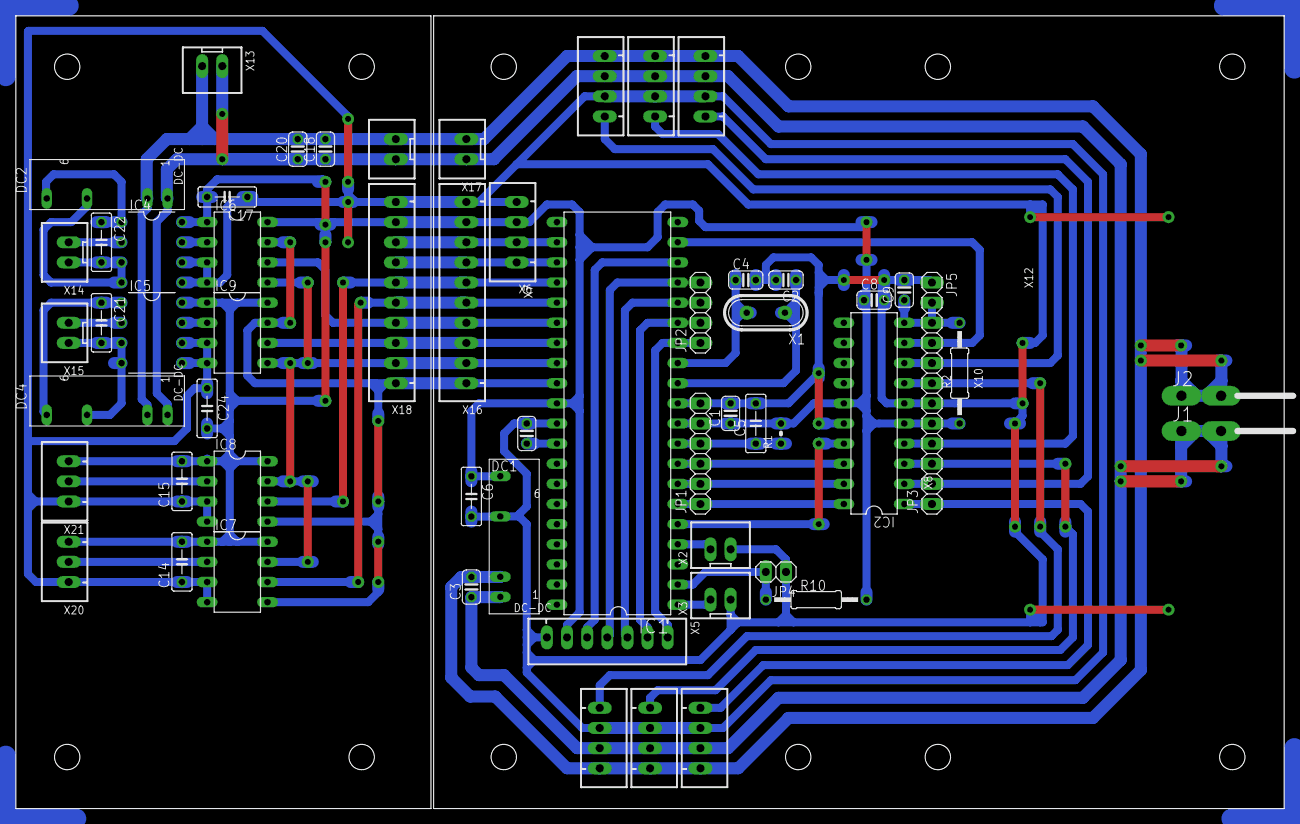
[picture p57: board vfd_controller_production.brd from above]

Board: 2 copper layers, 160.0 x 100.0 mm, 59 parts (0 on the bottom side), 46 nets.

Parts:
C1, C3, C7, C8, C9, C18, C20: 100n; C025-024X044
C2, C4: 22p; C025-024X044
C5, C6, C14, C15, C17, C21, C22, C24: 100n; C050-025X075
DC1, DC2, DC4: 12V in, 5V out; MEV
IC1: Atmega1284P; DIL40
IC2: Attiny861A; DIL20
IC4, IC5: HCPL-7840; DIL08
IC6, IC7, IC8, IC9: MPC3201; DIL08
J1, J2: F061.200
JP1: 1x6; 1X06
JP2: 1x4; 1X04
JP3: 1x10; 1X10
JP4, JP5: 1X02
R1: 10k; 0204V
R2, R10: 10k; 0207/12
U$1: A4L-LOC
X1: 20MHz; HC49
X2, X3, X14, X15: JST-XH-02-PACKAGE-LONG-PAD
X5: JST-XH-07-PIN-LONG-PAD; JST-XH-07-PACKAGE-LONG-PAD
X6, X7, X8, X9, X10, X11, X12: JST-XH-04-PACKAGE-LONG-PAD
X13, X17, X19: JST-XH-02-PIN-LONG-PAD; JST-XH-02-PACKAGE-LONG-PAD
X16, X18: JST-XH-10-PIN-LONG-PAD; JST-XH-10-PACKAGE-LONG-PAD
X20, X21: JST-XH-03-PIN-LONG-PAD; JST-XH-03-PACKAGE-LONG-PAD

Connections:
0V: C3.2, C18.2, C20.2, DC1.2, DC2.2, DC4.2, J2.1A, J2.1B, X7.4, X8.4, X9.4, X10.4, X11.4, X12.4, X13.2, X17.2, X19.2
232RX: IC1.16, JP2.3, X5.3
232TX: IC1.17, JP2.4, X5.4
485DE: IC1.18, X5.5
485RX: IC1.14, JP2.1, X5.1
485TX: IC1.15, JP2.2, X5.2
+5V: C1.1, C6.1, C8.1, C14.2, C15.2, C17.2, C24.2, DC1.7, IC1.10, IC1.30, IC2.5, IC2.15, IC4.8, IC5.8, IC6.1, IC6.8, IC7.1, IC7.8, IC8.1, IC8.8, IC9.1, IC9.8, JP1.5, JP3.5, R1.2, R2.1, R10.2, X5.6, X6.3, X16.9, X18.9, X20.3, X21.3
+12V: C3.1, C18.1, C20.1, DC1.1, DC2.1, DC4.1, J1.1A, J1.1B, X7.3, X8.3, X9.3, X10.3, X11.3, X12.3, X13.1, X17.1, X19.1
EN_SVPWM: IC1.19, IC2.9, JP3.9
GND: C1.2, C2.2, C4.2, C5.2, C6.2, C7.2, C8.2, C9.2, C14.1, C15.1, C17.1, C24.1, DC1.5, IC1.11, IC1.31, IC2.6, IC2.16, IC4.5, IC4.6, IC5.5, IC5.6, IC6.3, IC6.4, IC7.3, IC7.4, IC8.3, IC8.4, IC9.3, IC9.4, JP1.6, JP3.6, JP4.1, JP5.1, X2.2, X3.2, X5.7, X6.4, X7.2, X8.2, X9.2, X10.2, X11.2, X12.2, X16.10, X18.10, X20.1, X21.1
H1: IC2.1, JP3.1, X7.1
H2: IC2.3, JP3.3, X9.1
H3: IC2.7, JP3.7, X11.1
IO0: IC1.22, X6.2, X16.8, X18.8
IO1: IC1.23, X6.1, X16.7, X18.7
IO2: IC1.24, IC8.6, X16.6, X18.6
IO3: IC1.25, IC7.6, X16.5, X18.5
IO4: IC1.26, IC6.6, X16.4, X18.4
IO5: IC1.27, IC9.6, X16.3, X18.3
IO6: IC1.28, IC6.5, IC7.7, IC8.7, IC9.5, X16.2, X18.2
IO7: IC1.29, IC6.7, IC7.5, IC8.5, IC9.7, X16.1, X18.1
L1: IC2.2, JP3.2, X8.1
L2: IC2.4, JP3.4, X10.1
L3: IC2.8, JP3.8, X12.1
MISO: IC1.7, IC2.19, JP1.2
MOSI: IC1.6, IC2.20, JP1.1
unnamed: IC8.2, X21.2
unnamed: IC7.2, X20.2
unnamed: IC1.1, X3.1
unnamed: C21.1, DC4.7, IC5.1
unnamed: C21.2, DC4.5, IC5.3, IC5.4, X15.1
unnamed: IC4.2, X14.2
unnamed: C7.1, IC1.32
unnamed: IC4.7, IC6.2
unnamed: C22.2, DC2.5, IC4.3, IC4.4, X14.1
unnamed: IC5.2, X15.2
unnamed: C22.1, DC2.7, IC4.1
unnamed: IC1.4, X2.1
unnamed: IC1.2, JP4.2, R10.1
unnamed: IC5.7, IC9.2
unnamed: C9.1, IC2.10, JP3.10, JP5.2, R2.2
unnamed: C5.1, IC1.9, JP1.4, R1.1
unnamed: C2.1, IC1.12, X1.1
unnamed: C4.1, IC1.13, X1.2
SCK: IC1.8, IC2.18, JP1.3
SS: IC1.5, IC2.17
