DANTRACX/OpenVFD/vfd_igbt_driver/schematics/vfd_igbtdriver_mfg.brd

## EAGLE design vfd_igbt_driver/schematics/vfd_igbtdriver_mfg.brd (2019-10-20)

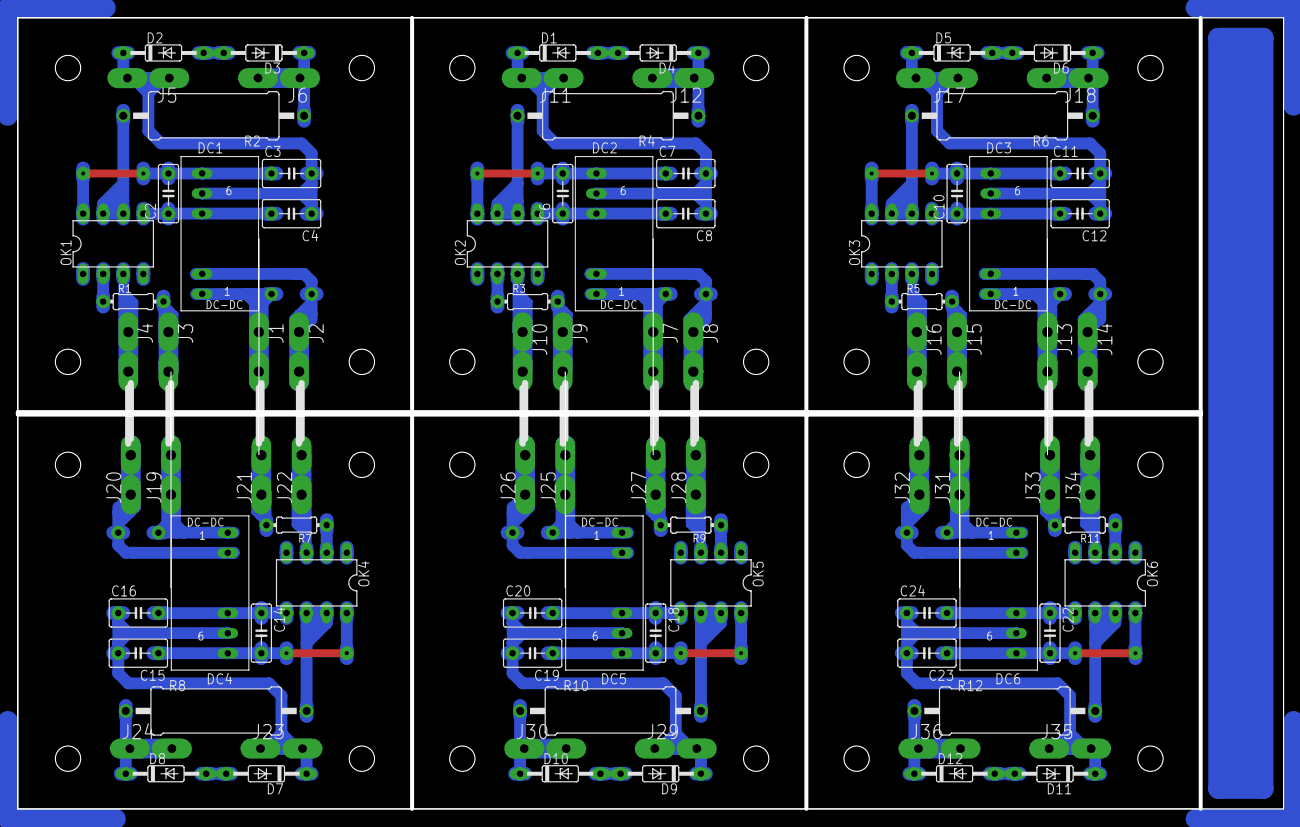
[picture p58: board vfd_igbtdriver_mfg.brd from above]

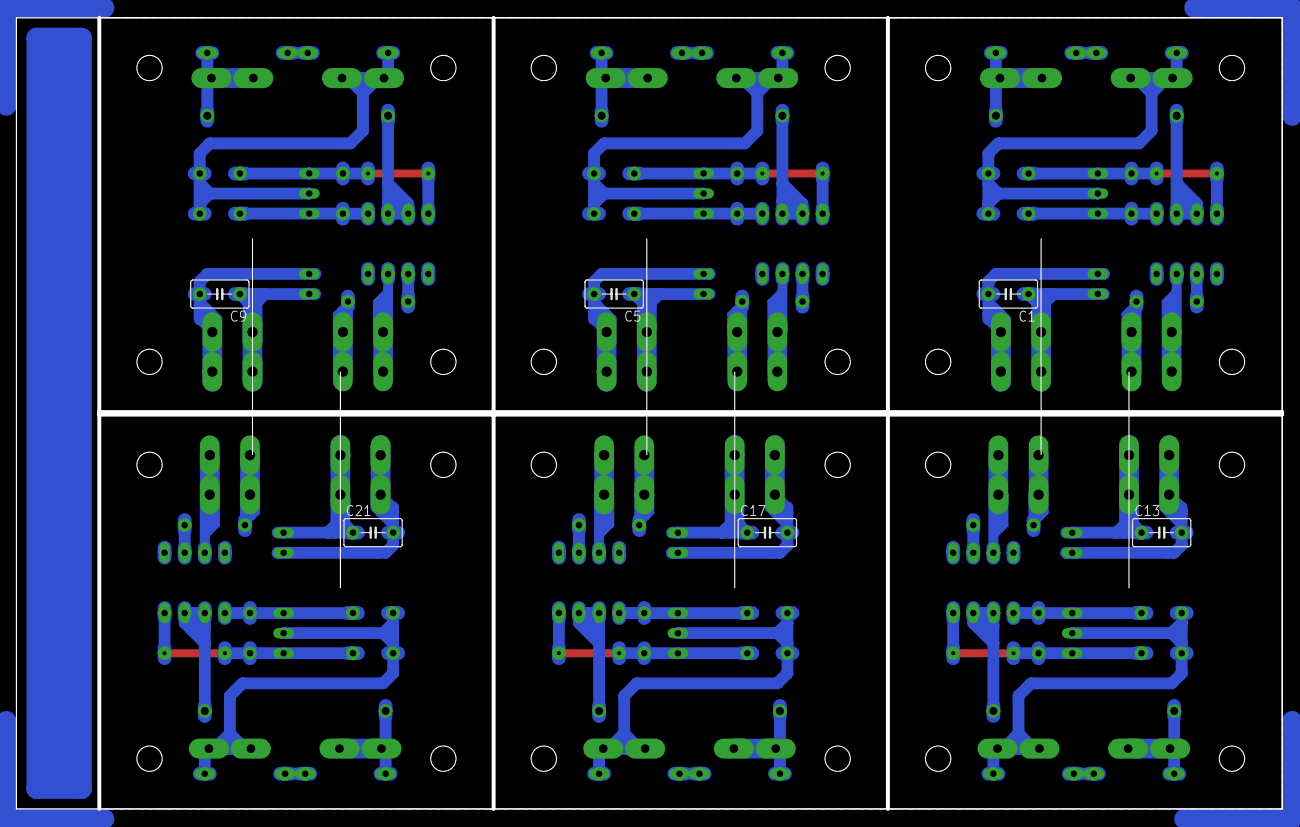
[picture p59: board vfd_igbtdriver_mfg.brd from below]

Board: 2 copper layers, 160.0 x 100.0 mm, 97 parts (6 on the bottom side), 66 nets.

Parts:
C1, C3, C4, C5, C7, C8, C9, C11, C12, C13, C15, C16, C17, C19, C20, C21, C23, C24: 0,47µ; C050-035X075
C2, C6, C10, C14, C18, C22: 100n; C050-025X075
D1, D2, D3, D4, D5, D6, D7, D8, D9, D10, D11, D12: ZD18; DO35Z10
DC1, DC2, DC3, DC4, DC5, DC6: MGJ2D121505SC; MGJ2
E$1: A4L-LOC
J1, J2, J3, J4, J7, J8, J9, J10, J13, J14, J15, J16, J19, J20, J21, J22, J25, J26, J27, J28, J31, J32, J33, J34: FS-PW 2,8; F061.200
J5, J6, J11, J12, J17, J18, J23, J24, J29, J30, J35, J36: FS-P 6,35; F061.040
OK1, OK2, OK3, OK4, OK5, OK6: FOD3120V; DIL08
R1, R3, R5, R7, R9, R11: 140R; 0204/7
R2, R4, R6, R8, R10, R12: 15R; 0617/22

Connections:
0V: C1.2, DC1.2, J2.1A, J2.1B
0V1: C5.2, DC2.2, J8.1A, J8.1B
0V2: C9.2, DC3.2, J14.1A, J14.1B
0V3: C13.2, DC4.2, J20.1A, J20.1B
0V4: C17.2, DC5.2, J26.1A, J26.1B
0V5: C21.2, DC6.2, J32.1A, J32.1B
+12V: C1.1, DC1.1, J1.1A, J1.1B
+12V1: C5.1, DC2.1, J7.1A, J7.1B
+12V2: C9.1, DC3.1, J13.1A, J13.1B
+12V3: C13.1, DC4.1, J19.1A, J19.1B
+12V4: C17.1, DC5.1, J25.1A, J25.1B
+12V5: C21.1, DC6.1, J31.1A, J31.1B
CTRL_5V: J3.1A, J3.1B, R1.2
CTRL_5V1: J9.1A, J9.1B, R3.2
CTRL_5V2: J15.1A, J15.1B, R5.2
CTRL_5V3: J21.1A, J21.1B, R7.2
CTRL_5V4: J27.1A, J27.1B, R9.2
CTRL_5V5: J33.1A, J33.1B, R11.2
CTRL_GND: J4.1A, J4.1B, OK1.3
CTRL_GND1: J10.1A, J10.1B, OK2.3
CTRL_GND2: J16.1A, J16.1B, OK3.3
CTRL_GND3: J22.1A, J22.1B, OK4.3
CTRL_GND4: J28.1A, J28.1B, OK5.3
CTRL_GND5: J34.1A, J34.1B, OK6.3
EMITTER: C3.2, C4.1, D2.C, DC1.6, J5.A1, J5.A2
EMITTER1: C7.2, C8.1, D1.C, DC2.6, J11.A1, J11.A2
EMITTER2: C11.2, C12.1, D5.C, DC3.6, J17.A1, J17.A2
EMITTER3: C15.2, C16.1, D7.C, DC4.6, J23.A1, J23.A2
EMITTER4: C19.2, C20.1, D9.C, DC5.6, J29.A1, J29.A2
EMITTER5: C23.2, C24.1, D11.C, DC6.6, J35.A1, J35.A2
GATE: D3.C, J6.A1, J6.A2, R2.1
GATE1: D4.C, J12.A1, J12.A2, R4.1
GATE2: D6.C, J18.A1, J18.A2, R6.1
GATE3: D8.C, J24.A1, J24.A2, R8.1
GATE4: D10.C, J30.A1, J30.A2, R10.1
GATE5: D12.C, J36.A1, J36.A2, R12.1
unnamed: C2.1, C4.2, DC1.5, OK1.5
unnamed: C2.2, C3.1, DC1.7, OK1.8
unnamed: OK1.6, OK1.7, R2.2
unnamed: OK1.2, R1.1
unnamed: C6.1, C8.2, DC2.5, OK2.5
unnamed: D2.A, D3.A
unnamed: C6.2, C7.1, DC2.7, OK2.8
unnamed: OK2.6, OK2.7, R4.2
unnamed: D1.A, D4.A
unnamed: OK2.2, R3.1
unnamed: C10.1, C12.2, DC3.5, OK3.5
unnamed: C10.2, C11.1, DC3.7, OK3.8
unnamed: OK3.6, OK3.7, R6.2
unnamed: D5.A, D6.A
unnamed: OK3.2, R5.1
unnamed: C14.1, C16.2, DC4.5, OK4.5
unnamed: C14.2, C15.1, DC4.7, OK4.8
unnamed: OK4.6, OK4.7, R8.2
unnamed: D7.A, D8.A
unnamed: OK4.2, R7.1
unnamed: C18.1, C20.2, DC5.5, OK5.5
unnamed: C18.2, C19.1, DC5.7, OK5.8
unnamed: OK5.6, OK5.7, R10.2
unnamed: D9.A, D10.A
unnamed: OK5.2, R9.1
unnamed: C22.1, C24.2, DC6.5, OK6.5
unnamed: C22.2, C23.1, DC6.7, OK6.8
unnamed: OK6.6, OK6.7, R12.2
unnamed: D11.A, D12.A
unnamed: OK6.2, R11.1
