DANTRACX/OpenVFD/vfd_vdppfc/schematics/vfd_vdppfc.sch

## EAGLE design vfd_vdppfc/schematics/vfd_vdppfc.sch (2019-10-10)

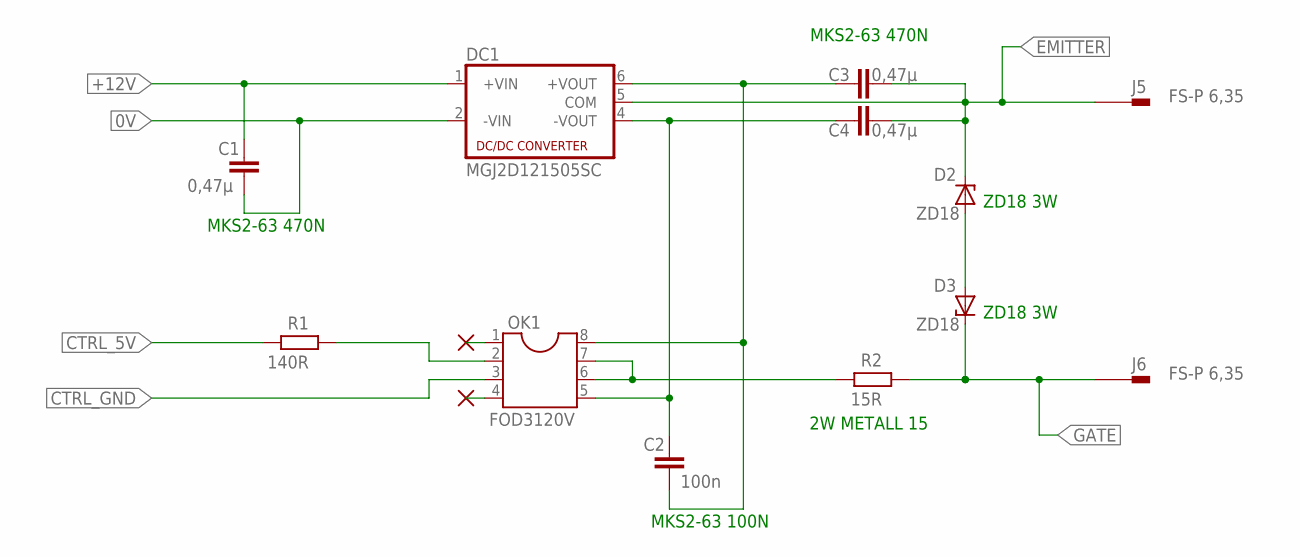
[picture p60: schematic vfd_vdppfc.sch]

Parts:
C1, C3, C4: 0,47µ; C050-035X075
C2: 100n; C050-025X075
D2, D3: ZD18; DO35Z10
DC1: MGJ2D121505SC; NMA
J5, J6: FS-P 6,35; F061.040
OK1: FOD3120V; DIL08
R1: 140R; 0204/7
R2: 15R; 0617/22

Connections:
0V: C1.2, DC1.2 (-VIN)
+12V: C1.1, DC1.1 (+VIN)
CTRL_5V: R1.2
CTRL_GND: OK1.3
EMITTER: C3.2, C4.1, D2.C, DC1.5 (COM), J5.A1
GATE: D3.C, J6.A1, R2.1
unnamed: C2.1, C4.2, DC1.4 (-VOUT), OK1.5
unnamed: C2.2, C3.1, DC1.6 (+VOUT), OK1.8
unnamed: OK1.6, OK1.7, R2.2
unnamed: OK1.2, R1.1
unnamed: D2.A, D3.A

Notes on the sheet:
MKS2-63 470N
MKS2-63 100N
ZD18 3W
2W METALL 15
