DANTRACX/OpenVFD/vfd_svpwm_ic/firmware/src/svpwm.asm

; ******************************************************************************
; *                A V R   S V P W M   S U B P R O C E S S O R                 *
; *                                 svpwm.asm                                  *
; *                          (C) Christoph Klie 2019                           *
; *                            TAB SIZE =  4 SPACES                            *
; ******************************************************************************
; ==============================================================================
;                               S  V  P  W  M
; ==============================================================================
; This file implements the svpwm algorithm in soft- and hardware. Timer1 with
; its integrated deadtime generator is used.

; !!!!!!!!!!!!!!!!!!!!!!!!!!!!!
; TODO: - Alle zeilen kommentieren

; ==============================================================================
;          R  E  G  I  S  T  E  R     D  E  F  I  N  I  T  I  O  N  S
; ==============================================================================
.def SVPWM_CALC0L   = r0                ; calc 0 register low byte
.def SVPWM_CALC0H   = r1                ; calc 0 register high byte
.def SVPWM_CALC1L   = r2                ; calc 1 register low byte
.def SVPWM_CALC1H   = r3                ; calc 1 register high byte
.def SVPWM_CALC2L   = r4                ; calc 2 register low byte
.def SVPWM_CALC2H   = r5                ; calc 2 register high byte
.def SVPWM_INTVL0L  = r6                ; channel A interval low byte
.def SVPWM_INTVL0H  = r7                ; channel A interval high byte
.def SVPWM_INTVL1L  = r8                ; channel B interval low byte
.def SVPWM_INTVL1H  = r9                ; channel B interval high byte
.def SVPWM_INTVL2L  = r10               ; channel C interval low byte
.def SVPWM_INTVL2H  = r11               ; channel C interval high byte
.def SVPWM_CPHASE0  = r12               ;
.def SVPWM_CPHASE1  = r13               ;
.def SVPWM_CPHASE2  = r14               ;
.def SVPWM_CPHASE3  = r15               ;
.def SVPWM_TEMPL    = r16               ; temp register low byte
.def SVPWM_TEMPH    = r17               ; temp register high byte
.def SVPWM_COUNTERL = r18               ; counter register low byte
.def SVPWM_COUNTERH = r19               ; counter register high byte
.def SVPWM_MAGN     = r20               ; holds the desired magnitude
.def SVPWM_FREQL    = r21               ; holds the desired frequency
.def SVPWM_FREQH    = r22               ; holds the desired frequency
.def SVPWM_PHASEL   = r23               ; low byte of the current angle
.def SVPWM_PHASEH   = r24               ; high byte of the current angle
.def SVPWM_ESREG    = r25               ;
.equ SVPWM_EESREG   = EEARL             ;
.equ SVPWM_OFFSETL  = GPIOR0            ;
.equ SVPWM_OFFSETH  = GPIOR1            ;
.equ SVPWM_DEADTIME = GPIOR2            ;

;SVPWM_ESREG BIT DEFINITIONS
;———————————————————————————————————————————————————————————————————————————————
;    7    |    6    |    5    |    4    |    3    |    2    |    1    |    0
;  CW/CCW | DATARDY |  BUF1/2 |  DTPS1  |  DTPS0  |  FPWM2  |  FPWM1  |  FPWM0
;———————————————————————————————————————————————————————————————————————————————


; ==============================================================================
;         V  A  R  I  A  B  L  E     D  E  F  I  N  I  T  I  O  N  S
; ==============================================================================
.dseg
.cseg


; ==============================================================================
;       S V P W M  -  U S E R   A C C E S S A B L E   F U N C T I O N S
; ==============================================================================
.cseg
SVPWM_INIT:                             ;
    ldi     SVPWM_ESREG,0b00011000      ;
    ldi     SVPWM_MAGN,0x00             ; init SVPWM_MAGN register
    ldi     SVPWM_FREQL,0x00            ; init SVPWM_FREQ register
    ldi     SVPWM_FREQH,0x00            ;
    ldi     SVPWM_PHASEL,0x00           ; init SVPWM_PHASEL register
    ldi     SVPWM_PHASEH,0x00           ; init SVPWM_PHASEH register
    ldi     SVPWM_TEMPL,0xFF            ;
    out     SVPWM_EESREG,SVPWM_PHASEL   ;
    out     SVPWM_OFFSETL,SVPWM_PHASEL  ;
    out     SVPWM_OFFSETH,SVPWM_PHASEH  ;
    out     SVPWM_DEADTIME,SVPWM_TEMPL  ;
    rcall   _SVPWM_TIMER_OUTPUTS_SETUP  ;
    rcall   _SVPWM_TIMER_DEADTIME_SETUP ;
    rcall   _SVPWM_TIMER_CTRLREG_SETUP  ;
    rcall   _SVPWM_TIMER_RANGE_SETUP    ;
    rcall   _SVPWM_TIMER_PLL_SETUP      ;
    rcall   _SVPWM_TIMER_PWMOUT_DISABLE ;
    rcall   _SVPWM_CALC_UPDATE_PHASE    ;
    rcall   _SVPWM_CALC_UPDATE_INTVL    ;
    ret                                 ;


SVPWM_LOOP:                             ;
    sbis    PINB,6                      ;
    rcall   _SVPWM_TIMER_FAULT_ISR      ;
    sbis    SVPWM_EESREG,0              ;
    rjmp    update_angle                ;
    cbi     SVPWM_EESREG,0              ;
update_pwmfreq:                         ;
    mov     SVPWM_TEMPL,SVPWM_ESREG     ;
    cbr     SVPWM_TEMPL,0b11111000      ;
update_pwmfreq_1khz:                    ;
    cpi     SVPWM_TEMPL,0x01            ;
    brne    update_pwmfreq_2khz         ;
    rcall   _SVPWM_TIMER_1KHZ           ;
    rjmp    update_angle                ;
update_pwmfreq_2khz:                    ;
    cpi     SVPWM_TEMPL,0x02            ;
    brne    update_pwmfreq_4khz         ;
    rcall   _SVPWM_TIMER_2KHZ           ;
    rjmp    update_angle                ;
update_pwmfreq_4khz:                    ;
    cpi     SVPWM_TEMPL,0x03            ;
    brne    update_pwmfreq_8khz         ;
    rcall   _SVPWM_TIMER_4KHZ           ;
    rjmp    update_angle                ;
update_pwmfreq_8khz:                    ;
    cpi     SVPWM_TEMPL,0x04            ;
    brne    update_pwmfreq_16khz        ;
    rcall   _SVPWM_TIMER_8KHZ           ;
    rjmp    update_angle                ;
update_pwmfreq_16khz:                   ;
    cpi     SVPWM_TEMPL,0x05            ;
    brne    update_pwmfreq_stop         ;
    rcall   _SVPWM_TIMER_16KHZ          ;
    rjmp    update_angle                ;
update_pwmfreq_stop:                    ;
    rcall   _SVPWM_TIMER_STOP           ;
    ret                                 ;
update_angle:                           ;
    in      SVPWM_TEMPL,TIFR            ;
    sbrs    TEMPL,2                     ;
    ret                                 ;
    rcall   _SVPWM_CALC_UPDATE_PHASE    ;
    rcall   _SVPWM_CALC_UPDATE_INTVL    ;
    ldi     SVPWM_TEMPL,0b00000100      ;
    out     TIFR,SVPWM_TEMPL            ;
    ret                                 ;



; ==============================================================================
;      S V P W M  -  H A R D W A R E   G E N E R A T O R   ( T I M E R 1 )
; ==============================================================================
.cseg
_SVPWM_TIMER_OUTPUTS_SETUP:             ;
    ldi     SVPWM_TEMPL,0b00111111      ; load bit mask in temp
    out     DDRB,SVPWM_TEMPL            ; set i/o to output
    ldi     SVPWM_TEMPL,0b00000000      ; load bit mask in temp
    out     PORTB,SVPWM_TEMPL           ; set all outputs to off
    ret                                 ;


_SVPWM_TIMER_DEADTIME_SETUP:            ;
    ldi     SVPWM_TEMPL,0xFF            ;
    out     DT1,SVPWM_TEMPL             ; set dead time cycles (0xHigh:Low)
    ret                                 ;


_SVPWM_TIMER_CTRLREG_SETUP:             ;
    ldi     SVPWM_TEMPL,0b01010011      ; load settings for register
    out     TCCR1A,SVPWM_TEMPL          ; set bit for control register A
    ldi     SVPWM_TEMPL,0b00110000      ; load settings for register
    out     TCCR1B,SVPWM_TEMPL          ; set bit for control register B
    ldi     SVPWM_TEMPL,0b00000001      ; load settings for register
    out     TCCR1C,SVPWM_TEMPL          ; set bit for control register C
    ldi     SVPWM_TEMPL,0b11100001      ; load settings for register
    out     TCCR1D,SVPWM_TEMPL          ; set bit for control register D
    ldi     SVPWM_TEMPL,0b00000000      ; load settings for register
    out     TCCR1E,SVPWM_TEMPL          ; set bit for control register E
    ret                                 ;


_SVPWM_TIMER_RANGE_SETUP:               ;
    ldi     SVPWM_TEMPL,0xFF            ; define high byte for OCR1C (top)
    ldi     SVPWM_TEMPH,0x03            ; define low byte for OCR1C (top)
    out     TC1H,SVPWM_TEMPH            ; set high byte for OCR1C (top)
    out     OCR1C,SVPWM_TEMPL           ; set low byte for OCR1C (top)
    ret                                 ;


_SVPWM_TIMER_PLL_SETUP:                 ;
    ldi     SVPWM_TEMPL,0b00000010      ; load settings for register
    out     PLLCSR,SVPWM_TEMPL          ; trigger pll start mechanism
    ldi     SVPWM_COUNTERL,0xFF         ; set counter to max value
svpwm_hw_pll_wait:                      ; wait for pll to lock
    nop                                 ; wait
    nop                                 ; wait
    nop                                 ; wait
    dec     SVPWM_COUNTERL              ; decrement counter
    brne    svpwm_hw_pll_wait           ; loop while counter not 0
svpwm_hw_plock_check:                   ; check if plock is set
    in      SVPWM_TEMPL,PLLCSR          ; load pll register data
    sbrs    SVPWM_TEMPL,0               ; check if plock bit is set
    rjmp    svpwm_hw_plock_check        ; if not set goto pll wait
    ldi     SVPWM_TEMPL,0b00000111      ; else load new register data
    out     PLLCSR,SVPWM_TEMPL          ; set pll register - enable pll timer
    ret                                 ; end function


_SVPWM_TIMER_PWMOUT_ENABLE:             ;
    ldi     SVPWM_TEMPL,0b01010101      ; load settings for register
    out     TCCR1C,SVPWM_TEMPL          ; connect outputs to pwm unit
    ret                                 ;


_SVPWM_TIMER_PWMOUT_DISABLE:            ;
    ldi     SVPWM_TEMPL,0b00000000      ; load settings for register
    out     TCCR1C,SVPWM_TEMPL          ; connect outputs to pwm unit
    ret                                 ;


_SVPWM_TIMER_STOP:                      ;
    rcall   _SVPWM_TIMER_PWMOUT_DISABLE ;
    in      SVPWM_TEMPL,TCCR1B          ;
    cbr     SVPWM_TEMPL,0b00001111      ;
    out     TCCR1B,SVPWM_TEMPL          ;
    ret                                 ;


_SVPWM_TIMER_1KHZ:                      ;
    rcall   _SVPWM_TIMER_PWMOUT_ENABLE  ;
    in      SVPWM_TEMPL,TCCR1B          ;
    cbr     SVPWM_TEMPL,0b00111111      ;
    sbr     SVPWM_TEMPL,0b00000110      ;
    sbrc    SVPWM_ESREG,3               ;
    sbr     SVPWM_TEMPL,0b00010000      ;
    sbrc    SVPWM_ESREG,4               ;
    sbr     SVPWM_TEMPL,0b00100000      ;
    out     TCCR1B,SVPWM_TEMPL          ;
    ldi     SVPWM_TEMPL,0x00            ;
    in      SVPWM_TEMPH,SVPWM_DEADTIME  ;
    cpse    SVPWM_TEMPH,SVPWM_TEMPL     ;
    out     DT1,SVPWM_TEMPH             ;
    ret                                 ;


_SVPWM_TIMER_2KHZ:                      ;
    rcall   _SVPWM_TIMER_PWMOUT_ENABLE  ;
    in      SVPWM_TEMPL,TCCR1B          ;
    cbr     SVPWM_TEMPL,0b00111111      ;
    sbr     SVPWM_TEMPL,0b00000101      ;
    sbrc    SVPWM_ESREG,3               ;
    sbr     SVPWM_TEMPL,0b00010000      ;
    sbrc    SVPWM_ESREG,4               ;
    sbr     SVPWM_TEMPL,0b00100000      ;
    out     TCCR1B,SVPWM_TEMPL          ;
    ldi     SVPWM_TEMPL,0x00            ;
    in      SVPWM_TEMPH,SVPWM_DEADTIME  ;
    cpse    SVPWM_TEMPH,SVPWM_TEMPL     ;
    out     DT1,SVPWM_TEMPH             ;
    ret                                 ;


_SVPWM_TIMER_4KHZ:                      ;
    rcall   _SVPWM_TIMER_PWMOUT_ENABLE  ;
    in      SVPWM_TEMPL,TCCR1B          ;
    cbr     SVPWM_TEMPL,0b00111111      ;
    sbr     SVPWM_TEMPL,0b00000100      ;
    sbrc    SVPWM_ESREG,3               ;
    sbr     SVPWM_TEMPL,0b00010000      ;
    sbrc    SVPWM_ESREG,4               ;
    sbr     SVPWM_TEMPL,0b00100000      ;
    out     TCCR1B,SVPWM_TEMPL          ;
    ldi     SVPWM_TEMPL,0x00            ;
    in      SVPWM_TEMPH,SVPWM_DEADTIME  ;
    cpse    SVPWM_TEMPH,SVPWM_TEMPL     ;
    out     DT1,SVPWM_TEMPH             ;
    ret                                 ;


_SVPWM_TIMER_8KHZ:                      ;
    rcall   _SVPWM_TIMER_PWMOUT_ENABLE  ;
    in      SVPWM_TEMPL,TCCR1B          ;
    cbr     SVPWM_TEMPL,0b00111111      ;
    sbr     SVPWM_TEMPL,0b00000011      ;
    sbrc    SVPWM_ESREG,3               ;
    sbr     SVPWM_TEMPL,0b00010000      ;
    sbrc    SVPWM_ESREG,4               ;
    sbr     SVPWM_TEMPL,0b00100000      ;
    out     TCCR1B,SVPWM_TEMPL          ;
    ldi     SVPWM_TEMPL,0x00            ;
    in      SVPWM_TEMPH,SVPWM_DEADTIME  ;
    cpse    SVPWM_TEMPH,SVPWM_TEMPL     ;
    out     DT1,SVPWM_TEMPH             ;
    ret                                 ;


_SVPWM_TIMER_16KHZ:                     ;
    rcall   _SVPWM_TIMER_PWMOUT_ENABLE  ;
    in      SVPWM_TEMPL,TCCR1B          ;
    cbr     SVPWM_TEMPL,0b00111111      ;
    sbr     SVPWM_TEMPL,0b00000010      ;
    sbrc    SVPWM_ESREG,3               ;
    sbr     SVPWM_TEMPL,0b00010000      ;
    sbrc    SVPWM_ESREG,4               ;
    sbr     SVPWM_TEMPL,0b00100000      ;
    out     TCCR1B,SVPWM_TEMPL          ;
    ldi     SVPWM_TEMPL,0x00            ;
    in      SVPWM_TEMPH,SVPWM_DEADTIME  ;
    cpse    SVPWM_TEMPH,SVPWM_TEMPL     ;
    out     DT1,SVPWM_TEMPH             ;
    ret                                 ;


_SVPWM_TIMER_FAULT_ISR:                 ;
    cli                                 ;
    rcall   _SVPWM_TIMER_STOP           ;
svpwm_timer_fault_isr_loop:             ;
    wdr                                 ;
    sbis    PINB,6                      ;
    rjmp    svpwm_timer_fault_isr_loop  ;
    ldi     SVPWM_MAGN,0b11100001       ;
    out     TCCR1D,SVPWM_MAGN           ;
    ldi     SVPWM_MAGN,0x00             ;
    ldi     SVPWM_FREQL,0x00            ;
    ldi     SVPWM_FREQH,0x00            ;
    out     SVPWM_EESREG,SVPWM_MAGN     ;
    cbr     SVPWM_ESREG,6               ;
    sei                                 ;
    reti                                ;


; ==============================================================================
;            S V P W M   -   S O F T W A R E   C A L C U L A T I O N
; ==============================================================================
.cseg
_SVPWM_CALC_UPDATE_PHASE:               ;
    ldi     SVPWM_TEMPL,0x00            ;
    ldi     SVPWM_TEMPH,0x00            ;
    mov     SVPWM_CALC0L,SVPWM_FREQL    ;
    mov     SVPWM_CALC0H,SVPWM_FREQH    ;
    in      SVPWM_COUNTERL,TCCR1B       ; read prescaler for compensation
    cbr     SVPWM_COUNTERL,0b11110000   ;
    subi    SVPWM_COUNTERL,0x02         ;
    breq    svpwm_calc_decide_direction ;
svpwm_calc_presc_comp:                  ;
    lsl     SVPWM_CALC0L                ;
    rol     SVPWM_CALC0H                ;
    rol     SVPWM_TEMPL                 ;
    dec     SVPWM_COUNTERL              ;
    brne    svpwm_calc_presc_comp       ;
svpwm_calc_decide_direction:            ;
    sbic    SVPWM_ESREG,7               ;
    rjmp    svpwm_calc_ccw              ;
svpwm_calc_cw:                          ;
    add     SVPWM_CPHASE0,SVPWM_CALC0L  ;
    adc     SVPWM_CPHASE1,SVPWM_CALC0H  ;
    adc     SVPWM_CPHASE2,SVPWM_TEMPL   ;
    adc     SVPWM_CPHASE3,SVPWM_TEMPH   ;
    ldi     SVPWM_TEMPL,0x00            ;
    ldi     SVPWM_TEMPH,0x20            ;
    ldi     SVPWM_COUNTERL,0xF4         ;
    cp      SVPWM_CPHASE0,SVPWM_TEMPL   ;
    cpc     SVPWM_CPHASE1,SVPWM_TEMPH   ;
    cpc     SVPWM_CPHASE2,SVPWM_COUNTERL;
    cpc     SVPWM_CPHASE3,SVPWM_TEMPL   ;
    brsh    svpwm_calc_fix_pos_ovf      ;
    rjmp    svpwm_calc_finalize_result  ;
svpwm_calc_ccw:                         ;
    sub     SVPWM_CPHASE0,SVPWM_CALC0L  ;
    sbc     SVPWM_CPHASE1,SVPWM_CALC0H  ;
    sbc     SVPWM_CPHASE2,SVPWM_TEMPL   ;
    sbc     SVPWM_CPHASE3,SVPWM_TEMPH   ;
    ldi     SVPWM_TEMPL,0x00            ;
    ldi     SVPWM_TEMPH,0x20            ;
    ldi     SVPWM_COUNTERL,0xF4         ;
    cp      SVPWM_CPHASE0,SVPWM_TEMPL   ;
    cpc     SVPWM_CPHASE1,SVPWM_TEMPH   ;
    cpc     SVPWM_CPHASE2,SVPWM_COUNTERL;
    cpc     SVPWM_CPHASE3,SVPWM_TEMPL   ;
    brsh    svpwm_calc_fix_neg_ovf      ;
    rjmp    svpwm_calc_finalize_result  ;
svpwm_calc_fix_pos_ovf:                 ;
    sub     SVPWM_CPHASE1,SVPWM_TEMPH   ;
    sbc     SVPWM_CPHASE2,SVPWM_COUNTERL;
    sbc     SVPWM_CPHASE3,SVPWM_TEMPL   ;
    rjmp    svpwm_calc_finalize_result  ;
svpwm_calc_fix_neg_ovf:                 ;
    add     SVPWM_CPHASE1,SVPWM_TEMPH   ;
    adc     SVPWM_CPHASE2,SVPWM_COUNTERL;
    adc     SVPWM_CPHASE3,SVPWM_TEMPL   ;
svpwm_calc_finalize_result:             ;
    mov     SVPWM_PHASEL,SVPWM_CPHASE1  ;
    mov     SVPWM_PHASEH,SVPWM_CPHASE2  ;
    lsr     SVPWM_PHASEH                ;
    ror     SVPWM_PHASEL                ;
    lsr     SVPWM_PHASEH                ;
    ror     SVPWM_PHASEL                ;
svpwm_calc_add_phase_offset:            ;
    in      SVPWM_TEMPL,SVPWM_OFFSETL   ;
    in      SVPWM_TEMPH,SVPWM_OFFSETH   ;
    add     SVPWM_PHASEL,SVPWM_TEMPL    ;
    adc     SVPWM_PHASEH,SVPWM_TEMPH    ;
    ldi     SVPWM_TEMPL,0x08            ;
    ldi     SVPWM_TEMPH,0x3D            ;
    cp      SVPWM_PHASEL,SVPWM_TEMPL    ;
    cpc     SVPWM_PHASEH,SVPWM_TEMPH    ;
    brsh    svpwm_calc_fix_phase_ovf    ;
    ret                                 ;
svpwm_calc_fix_phase_ovf:               ;
    sub     SVPWM_PHASEL,SVPWM_TEMPL    ;
    sbc     SVPWM_PHASEH,SVPWM_TEMPH    ;
    ret                                 ;


_SVPWM_CALC_UPDATE_INTVL:               ;
    ldi     SVPWM_COUNTERH,0x00         ;
    mov     SVPWM_CALC0L,SVPWM_PHASEL   ;
    mov     SVPWM_CALC0H,SVPWM_PHASEH   ;
    ldi     SVPWM_TEMPL,0x2C            ;
    ldi     SVPWM_TEMPH,0x0A            ;
svpwm_calc_intvl_sector:                ; calculate sector number of curr. angle
    cp      SVPWM_CALC0L,SVPWM_TEMPL    ;
    cpc     SVPWM_CALC0H,SVPWM_TEMPH    ;
    brlo    svpwm_calc_intvl_t1         ;
    inc     SVPWM_COUNTERH              ;
    sub     SVPWM_CALC0L,SVPWM_TEMPL    ;
    sbc     SVPWM_CALC0H,SVPWM_TEMPH    ;
    rjmp    svpwm_calc_intvl_sector     ;
svpwm_calc_intvl_t1:                    ; calc time interval t1
    ldi     ZL,LOW(SINE*2)              ;
    ldi     ZH,HIGH(SINE*2)             ;
    sub     SVPWM_TEMPL,SVPWM_CALC0L    ;
    sbc     SVPWM_TEMPH,SVPWM_CALC0H    ;
    add     ZL,SVPWM_TEMPL              ;
    adc     ZH,SVPWM_TEMPH              ;
    add     ZL,SVPWM_TEMPL              ;
    adc     ZH,SVPWM_TEMPH              ;
    lpm     SVPWM_INTVL1L,Z+            ;
    lpm     SVPWM_INTVL1H,Z             ;
svpwm_calc_intvl_t2:                    ;
    ldi     ZL,LOW(SINE*2)              ;
    ldi     ZH,HIGH(SINE*2)             ;
    add     ZL,SVPWM_CALC0L             ;
    adc     ZH,SVPWM_CALC0H             ;
    add     ZL,SVPWM_CALC0L             ;
    adc     ZH,SVPWM_CALC0H             ;
    lpm     SVPWM_INTVL2L,Z+            ;
    lpm     SVPWM_INTVL2H,Z             ;
svpwm_calc_mult_t1t2:                   ;
    mov     SVPWM_COUNTERL,SVPWM_MAGN   ;
    ldi     SVPWM_TEMPL,0x00            ;
    ldi     SVPWM_TEMPH,0x00            ;
    clr     SVPWM_CALC0L                ; clear t1 result byte 0
    clr     SVPWM_CALC1L                ; clear t1 result byte 1
    clr     SVPWM_CALC2L                ; clear t1 result byte 2
    clr     SVPWM_CALC0H                ; clear t2 result byte 0
    clr     SVPWM_CALC1H                ; clear t2 result byte 1
    clr     SVPWM_CALC2H                ; clear t2 result byte 2
svpwm_calc_mult_t1t2_a:                 ;
    lsr     SVPWM_COUNTERL              ;
    brcc    svpwm_calc_mult_t1t2_b      ;
    add     SVPWM_CALC0L,SVPWM_INTVL1L  ;
    adc     SVPWM_CALC1L,SVPWM_INTVL1H  ;
    adc     SVPWM_CALC2L,SVPWM_TEMPL    ;
    add     SVPWM_CALC0H,SVPWM_INTVL2L  ;
    adc     SVPWM_CALC1H,SVPWM_INTVL2H  ;
    adc     SVPWM_CALC2H,SVPWM_TEMPH    ;
svpwm_calc_mult_t1t2_b:                 ;
    lsl     SVPWM_INTVL1L               ;
    rol     SVPWM_INTVL1H               ;
    rol     SVPWM_TEMPL                 ;
    lsl     SVPWM_INTVL2L               ;
    rol     SVPWM_INTVL2H               ;
    rol     SVPWM_TEMPH                 ;
    tst     SVPWM_COUNTERL              ;
    brne    svpwm_calc_mult_t1t2_a      ;
svpwm_calc_div_t1t2:                    ; devide both by 256 by rearranging reg
    mov     SVPWM_INTVL1L,SVPWM_CALC1L  ;
    mov     SVPWM_INTVL1H,SVPWM_CALC2L  ;
    mov     SVPWM_INTVL2L,SVPWM_CALC1H  ;
    mov     SVPWM_INTVL2H,SVPWM_CALC2H  ;
svpwm_calc_intvl_t0:                    ;
    ldi     SVPWM_TEMPL,0xFF            ;
    ldi     SVPWM_TEMPH,0x03            ;
    mov     SVPWM_INTVL0L,SVPWM_TEMPL   ;
    mov     SVPWM_INTVL0H,SVPWM_TEMPH   ;
    sub     SVPWM_INTVL0L,SVPWM_INTVL1L ;
    sbc     SVPWM_INTVL0H,SVPWM_INTVL1H ;
    sub     SVPWM_INTVL0L,SVPWM_INTVL2L ;
    sbc     SVPWM_INTVL0H,SVPWM_INTVL2H ;
svpwm_calc_intvl_setcomp:               ;
    ldi     SVPWM_TEMPL,0x00            ;
    ldi     ZL,low(_SVPWM_CALC_JTB)     ;
    ldi     ZH,high(_SVPWM_CALC_JTB)    ;
    add     ZL,SVPWM_COUNTERH           ;
    adc     ZH,SVPWM_TEMPL              ;
    ijmp                                ;


_SVPWM_CALC_JTB:                        ;
    rjmp    _SVPWM_CALC_SETCOMP_SECTOR0 ;
    rjmp    _SVPWM_CALC_SETCOMP_SECTOR1 ;
    rjmp    _SVPWM_CALC_SETCOMP_SECTOR2 ;
    rjmp    _SVPWM_CALC_SETCOMP_SECTOR3 ;
    rjmp    _SVPWM_CALC_SETCOMP_SECTOR4 ;
    rjmp    _SVPWM_CALC_SETCOMP_SECTOR5 ;
    ret                                 ;


_SVPWM_CALC_SETCOMP_SECTOR0:            ;
    cli                                 ;
    out     TC1H,SVPWM_INTVL0H          ;
    out     OCR1A,SVPWM_INTVL0L         ;
    add     SVPWM_INTVL0L,SVPWM_INTVL1L ;
    adc     SVPWM_INTVL0H,SVPWM_INTVL1H ;
    out     TC1H,SVPWM_INTVL0H          ;
    out     OCR1B,SVPWM_INTVL0L         ;
    add     SVPWM_INTVL0L,SVPWM_INTVL2L ;
    adc     SVPWM_INTVL0H,SVPWM_INTVL2H ;
    out     TC1H,SVPWM_INTVL0H          ;
    out     OCR1D,SVPWM_INTVL0L         ;
    sei                                 ;
    ret                                 ;


_SVPWM_CALC_SETCOMP_SECTOR1:            ;
    cli                                 ;
    out     TC1H,SVPWM_INTVL0H          ;
    out     OCR1B,SVPWM_INTVL0L         ;
    add     SVPWM_INTVL0L,SVPWM_INTVL2L ;
    adc     SVPWM_INTVL0H,SVPWM_INTVL2H ;
    out     TC1H,SVPWM_INTVL0H          ;
    out     OCR1A,SVPWM_INTVL0L         ;
    add     SVPWM_INTVL0L,SVPWM_INTVL1L ;
    adc     SVPWM_INTVL0H,SVPWM_INTVL1H ;
    out     TC1H,SVPWM_INTVL0H          ;
    out     OCR1D,SVPWM_INTVL0L         ;
    sei                                 ;
    ret                                 ;


_SVPWM_CALC_SETCOMP_SECTOR2:            ;
    cli                                 ;
    out     TC1H,SVPWM_INTVL0H          ;
    out     OCR1B,SVPWM_INTVL0L         ;
    add     SVPWM_INTVL0L,SVPWM_INTVL1L ;
    adc     SVPWM_INTVL0H,SVPWM_INTVL1H ;
    out     TC1H,SVPWM_INTVL0H          ;
    out     OCR1D,SVPWM_INTVL0L         ;
    add     SVPWM_INTVL0L,SVPWM_INTVL2L ;
    adc     SVPWM_INTVL0H,SVPWM_INTVL2H ;
    out     TC1H,SVPWM_INTVL0H          ;
    out     OCR1A,SVPWM_INTVL0L         ;
    sei                                 ;
    ret                                 ;


_SVPWM_CALC_SETCOMP_SECTOR3:            ;
    cli                                 ;
    out     TC1H,SVPWM_INTVL0H          ;
    out     OCR1D,SVPWM_INTVL0L         ;
    add     SVPWM_INTVL0L,SVPWM_INTVL2L ;
    adc     SVPWM_INTVL0H,SVPWM_INTVL2H ;
    out     TC1H,SVPWM_INTVL0H          ;
    out     OCR1B,SVPWM_INTVL0L         ;
    add     SVPWM_INTVL0L,SVPWM_INTVL1L ;
    adc     SVPWM_INTVL0H,SVPWM_INTVL1H ;
    out     TC1H,SVPWM_INTVL0H          ;
    out     OCR1A,SVPWM_INTVL0L         ;
    sei                                 ;
    ret                                 ;


_SVPWM_CALC_SETCOMP_SECTOR4:            ;
    cli                                 ;
    out     TC1H,SVPWM_INTVL0H          ;
    out     OCR1D,SVPWM_INTVL0L         ;
    add     SVPWM_INTVL0L,SVPWM_INTVL1L ;
    adc     SVPWM_INTVL0H,SVPWM_INTVL1H ;
    out     TC1H,SVPWM_INTVL0H          ;
    out     OCR1A,SVPWM_INTVL0L         ;
    add     SVPWM_INTVL0L,SVPWM_INTVL2L ;
    adc     SVPWM_INTVL0H,SVPWM_INTVL2H ;
    out     TC1H,SVPWM_INTVL0H          ;
    out     OCR1B,SVPWM_INTVL0L         ;
    sei                                 ;
    ret                                 ;


_SVPWM_CALC_SETCOMP_SECTOR5:            ;
    cli                                 ;
    out     TC1H,SVPWM_INTVL0H          ;
    out     OCR1A,SVPWM_INTVL0L         ;
    add     SVPWM_INTVL0L,SVPWM_INTVL2L ;
    adc     SVPWM_INTVL0H,SVPWM_INTVL2H ;
    out     TC1H,SVPWM_INTVL0H          ;
    out     OCR1D,SVPWM_INTVL0L         ;
    add     SVPWM_INTVL0L,SVPWM_INTVL1L ;
    adc     SVPWM_INTVL0H,SVPWM_INTVL1H ;
    out     TC1H,SVPWM_INTVL0H          ;
    out     OCR1B,SVPWM_INTVL0L         ;
    sei                                 ;
    ret                                 ;


; ==============================================================================
;    S V P W M  -  S I N E   L O O K U P   T A B L E   0 - 6 0   D E G R E E
; ==============================================================================
; (8 x 325) + 3 = 2604 Values / 60 Degrees = 15624 Values / 360 Degrees
.cseg
SINE:
    .dw     0x0000, 0x0000, 0x0001, 0x0001, 0x0002, 0x0002, 0x0002, 0x0003
    .dw     0x0003, 0x0004, 0x0004, 0x0005, 0x0005, 0x0005, 0x0006, 0x0006
    .dw     0x0007, 0x0007, 0x0007, 0x0008, 0x0008, 0x0009, 0x0009, 0x0009
    .dw     0x000A, 0x000A, 0x000B, 0x000B, 0x000C, 0x000C, 0x000C, 0x000D
    .dw     0x000D, 0x000E, 0x000E, 0x000E, 0x000F, 0x000F, 0x0010, 0x0010
    .dw     0x0010, 0x0011, 0x0011, 0x0012, 0x0012, 0x0013, 0x0013, 0x0013
    .dw     0x0014, 0x0014, 0x0015, 0x0015, 0x0015, 0x0016, 0x0016, 0x0017
    .dw     0x0017, 0x0017, 0x0018, 0x0018, 0x0019, 0x0019, 0x001A, 0x001A
    .dw     0x001A, 0x001B, 0x001B, 0x001C, 0x001C, 0x001C, 0x001D, 0x001D
    .dw     0x001E, 0x001E, 0x001E, 0x001F, 0x001F, 0x0020, 0x0020, 0x0020
    .dw     0x0021, 0x0021, 0x0022, 0x0022, 0x0023, 0x0023, 0x0023, 0x0024
    .dw     0x0024, 0x0025, 0x0025, 0x0025, 0x0026, 0x0026, 0x0027, 0x0027
    .dw     0x0027, 0x0028, 0x0028, 0x0029, 0x0029, 0x002A, 0x002A, 0x002A
    .dw     0x002B, 0x002B, 0x002C, 0x002C, 0x002C, 0x002D, 0x002D, 0x002E
    .dw     0x002E, 0x002E, 0x002F, 0x002F, 0x0030, 0x0030, 0x0031, 0x0031
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
    .dw     0x035F, 0x035F, 0x035F, 0x0360, 0x0360, 0x0360, 0x0360, 0x0360
    .dw     0x0361, 0x0361, 0x0361, 0x0361, 0x0362, 0x0362, 0x0362, 0x0362
    .dw     0x0362, 0x0363, 0x0363, 0x0363, 0x0363, 0x0364, 0x0364, 0x0364
    .dw     0x0364, 0x0364, 0x0365, 0x0365, 0x0365, 0x0365, 0x0365, 0x0366
    .dw     0x0366, 0x0366, 0x0366, 0x0367, 0x0367, 0x0367, 0x0367, 0x0367
    .dw     0x0368, 0x0368, 0x0368, 0x0368, 0x0368, 0x0369, 0x0369, 0x0369
    .dw     0x0369, 0x036A, 0x036A, 0x036A, 0x036A, 0x036A, 0x036B, 0x036B
    .dw     0x036B, 0x036B, 0x036B, 0x036C, 0x036C, 0x036C, 0x036C, 0x036D
    .dw     0x036D, 0x036D, 0x036D, 0x036D, 0x036E, 0x036E, 0x036E, 0x036E
    .dw     0x036E, 0x036F, 0x036F, 0x036F, 0x036F, 0x036F, 0x0370, 0x0370
    .dw     0x0370, 0x0370, 0x0371, 0x0371, 0x0371, 0x0371, 0x0371, 0x0372
    .dw     0x0372, 0x0372, 0x0372, 0x0372, 0x0373, 0x0373, 0x0373, 0x0373
    .dw     0x0373, 0x0374, 0x0374, 0x0374, 0x0374, 0x0375, 0x0375, 0x0375
    .dw     0x0375, 0x0375, 0x0376, 0x0376, 0x0376
