DANTRACX/OpenVFD/vfd_controller/firmware/src/SYS/REGISTRY/REGREAD.c

#include "REGISTRY.h"

uint8_t REGISTRY_REGREAD(uint16_t registerAddress, uint16_t *registerValue)
{
    switch(registerAddress)
    {
        case 40100:
        {
            *registerValue = (uint16_t)SETPOINTS.ENABLE;
            return 0;
        }
        case 40101:
        {
            *registerValue = (uint16_t)SETPOINTS.TARGET_TORQUE;
            return 0;
        }
        case 40102:
        {
            *registerValue = (uint16_t)SETPOINTS.TARGET_FREQUENCY;
            return 0;
        }
        case 40103:
        {
            *registerValue = (uint16_t)SETPOINTS.REVERSAL;
            return 0;
        }
        case 40104:
        {
            *registerValue = (uint16_t)SETPOINTS.ENABLE_CURRENT_OVERDRIVE;
            return 0;
        }
        case 40105:
        {
            *registerValue = (uint16_t)SETPOINTS.ENABLE_FREQUENCY_OVERDRIVE;
            return 0;
        }
        case 40110:
        {
            *registerValue = (uint16_t)SETPOINTS.ENABLE_PROGMODE;
            return 0;
        }
        case 40111:
        {
            *registerValue = (uint16_t)SETPOINTS.TRIGGER_PARAMETER_SAVE;
            return 0;
        }
        case 40120:
        {
            *registerValue = (uint16_t)SETPOINTS.TRIGGER_UF_CALCULATION;
            return 0;
        }
        case 40150:
        {
            *registerValue = (uint16_t)SETPOINTS.TRIGGER_RESET;
            return 0;
        }
        case 30200:
        {
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
        {
            if((registerAddress >= 41000) && (registerAddress <= 43047))
            {
                *registerValue = (uint16_t)PARAMETERS.CONTROLLER_UF_VALUE[registerAddress - 41000];
                return 0;
            }

            return 1;
        }
    }

    return 1;
}
