DANTRACX/OpenVFD/vfd_controller/firmware/src/RES/SENSE/SENSE.c

#include "SENSE.h"

void SENSE_INIT(void)
{
    /* setup sense input pins */
    DDRC  &= ~((1 << PC7) | (1 << PC6) | (1 << PC5) | (1 << PC4));
    PORTC &= ~((1 << PC7) | (1 << PC6) | (1 << PC5) | (1 << PC4));

    /* setup clock (idle low) and ~cs/shdn */
    DDRD  |=  ((1 << PD5) | (1 << PD7));
    PORTD &= ~((1 << PD5));
    PORTD |=  ((1 << PD7));
}

void SENSE_FETCH(uint16_t *sense1, uint16_t *sense2, uint16_t *sense3, uint16_t *sense4)
{
    uint8_t counter = 0;

    *sense1 = 0x0000;
    *sense2 = 0x0000;
    *sense3 = 0x0000;
    *sense4 = 0x0000;

    /* enable sensor chips and start conversion */
    PORTD &= ~((1 << PD5));
    PORTD &= ~((1 << PD7));
    __builtin_avr_delay_cycles(SENSE_TCLK);
    PORTD |=  ((1 << PD5));
    __builtin_avr_delay_cycles(SENSE_TCLK);
    PORTD &= ~((1 << PD5));
    __builtin_avr_delay_cycles(SENSE_TCLK);
    PORTD |=  ((1 << PD5));
    __builtin_avr_delay_cycles(SENSE_TCLK);
    PORTD &= ~((1 << PD5));
    __builtin_avr_delay_cycles(SENSE_TCLK);
    PORTD |=  ((1 << PD5));

    /* read bit per bit into sensor data buffer */
    for(counter = 0; counter < 12; counter++)
    {
        /* shift a new bit to input */
        __builtin_avr_delay_cycles(SENSE_TCLK);
        PORTD &= ~((1 << PD5));
        __builtin_avr_delay_cycles(SENSE_TCLK);
        PORTD |=  ((1 << PD5));

        /* shift data buffer by 1 position to the left */
        #ifdef SENSE_USE_CHANNEL_1
            *sense1 <<= 1;

            if(PINC & (1 << PC4))
            {
                *sense1 |= (1 << 0);
            }
        #endif
        #ifdef SENSE_USE_CHANNEL_2
            *sense2 <<= 1;

            if(PINC & (1 << PC5))
            {
                *sense2 |= (1 << 0);
            }
        #endif
        #ifdef SENSE_USE_CHANNEL_3
            *sense3 <<= 1;

            if(PINC & (1 << PC6))
            {
                *sense3 |= (1 << 0);
            }
        #endif
        #ifdef SENSE_USE_CHANNEL_4
            *sense4 <<= 1;

            if(PINC & (1 << PC7))
            {
                *sense4 |= (1 << 0);
            }
        #endif
    }

    __builtin_avr_delay_cycles(SENSE_TCLK);
    PORTD &= ~((1 << PD5));

    /* shutdown sensor chips */
    PORTD |= ((1 << PD7));
    __builtin_avr_delay_cycles(4 * SENSE_TCLK);

    /* filter data */
    #ifdef SENSE_USE_CHANNEL_1
        *sense1 = *sense1 & 0x0FFF;
    #endif
    #ifdef SENSE_USE_CHANNEL_2
        *sense2 = *sense2 & 0x0FFF;
    #endif
    #ifdef SENSE_USE_CHANNEL_3
        *sense3 = *sense3 & 0x0FFF;
    #endif
    #ifdef SENSE_USE_CHANNEL_4
        *sense4 = *sense4 & 0x0FFF;
    #endif
}
