DANTRACX/OpenVFD/(commit log)

2019-08-04 Update Folder Structure
    [vfd_dclink.brd, vfd_dclink.sch, vfd_igbtdriver.brd, vfd_igbtdriver.sch, vfd_igbtdriver_mfg.brd, vfd_logic.sch]
2019-08-04 Minor code changes
    Changed register definitions to match module name and allow
    redefinition for other modules.
    Changed pll lock wait loop to use the correct counter
    variable.
    [firmware.asm, interface.asm, svpwm.asm]
2019-08-09 Updated SVPWM API
    Added user accessable functions
    Added automatic frequency setting from register value
    Added more PWM frequency steps
2019-08-10 Fixed some bugs
    Switched back to small lookup table because index
    calculation generates overflow an corrupts output
    signal
    Fixed a bug in loop where sbrs used wrong bit identifier
    Fixed code for angle correction offset calculation
    [svpwm.asm]
2019-08-11 Fixed a bug in interval calculation
    Extended the lookuptable size to 2604 values so that
    it is now possible to get a 1Hz sine @ 16kHz
    Fixed the bug in the interval calculation which used
    a wrong reference value
    Some code size and speed optimization
    [svpwm.asm]
2019-10-10 Multiple Changes
    Fixed the footprint bug from the igbt drivers
    Added schematics and pcb for dc-bus
    Added new folders for partial pfc voltage doubling rectifier
    Added schematics for controller
    [vfd_controller.brd, vfd_controller.sch, vfd_dcbus.brd, vfd_dcbus.sch, vfd_dcbus_basis.brd, vfd_dclink.brd, vfd_dclink.sch, vfd_igbtdriver.brd]
2019-10-17 Update Controller Schematic & PCB
    [vfd_dcbus.brd, vfd_dcbus.sch, vfd_igbtdriver_mfg.brd]
2019-10-20 Updated Schematics
    Updated already finnished schematics with Reichelt (DE) parts attribute
    Finalized the controller board
    [partslist.csv, vfd_controller.brd, vfd_controller.sch, vfd_dcbus.brd, vfd_dcbus.sch, vfd_igbtdriver.brd, vfd_igbtdriver.sch]
2019-10-20 Added drill markins to pcb
    [vfd_controller.brd, vfd_dcbus.brd, vfd_igbtdriver.brd, vfd_igbtdriver_mfg.brd]
2019-10-21 Updated Parts List and fix Footprint
    Fixed 12V to 5V DCDC footprint in Controller PCB
    Switched some 100n Capacitor footprints to bigger RM
    Updated Parts List
    [partslist.csv, vfd_controller.brd, vfd_controller.sch]
2019-11-06 Interim commit of svpwm programming
    Added spi interface to svpwm ic
2019-11-06 Multiple Changes
    - Upgraded SVPWM to 0-65535mHz range
    - Finalized SPI Interface
2019-11-07 Updated SVPWM IC
    Removed glitching of Outputs caused by too much spi interrupts
    [interface.asm, svpwm.asm]
2019-11-10 Added SPI-SVPWM communication to controller
2019-11-11 Small Bugfixes in SVPWM
    Fixed bug with t0 calculation - removed /2 operation
    Fixed bug with wrong register for phase offset in interface
    [interface.asm, svpwm.asm]
2019-11-19 Multiple Additions
    - Added RS485 code (equal to RS232) with UART0
    - Added SENSE code
    - Switched RS232 interface to UART1
2020-03-30 Added subroutines started coding torque controller subroutine started coding registry subroutine
2020-04-01 Added further subroutines and modules Added a moving-average filter mechanism to the controller Added a timing/scheduling mechanism to controller Updated controller timeout behavior
2020-04-03 Updated REGISTRY and defined Adresses Switched serial module to scpi module Started working on scpi module Renamed some REGISTRY entries Defined MODBUS/SCPI Adresses
2020-04-05 Updates, Bugfixes and much more Updated the SCPI module to a more usable approach, polished the code. Fixed a bug in MEM module: decrement at wrong position led to address mismatch Implemented the U/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
    [CONTROLLER.c, REGISTRY.c, REGISTRY.h, REGREAD.c, REGWRITE.c]
2020-04-18 Multiple Changes - changed some regiser mapping - added sense offset regisers - switched status register from string to simpler sreg - removed some variables thanks to the new status register - added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
2020-04-20 Some Modifications - changed some register mappings - added some registers - fixed a bug with rs485 - fixed a bug in modbus register adressing
    [CONTROLLER.c, REGISTRY.c, REGISTRY.h]
2020-06-18 Added build documentation and some code testing
    -Added some images from vfd build
    -Found a bug in U and I measurement - still needs to be fixed
    -Added new filtering code
    -Added stencil for power module hole alignment
    [vfd_power_module.brd]
2020-07-04 Buxfixing and filter testing
    Fixed a bug in RS485+MODBUS where tx injects data to rx due to interface
    topology which leads to error and response data
    Added oversampling technique and median filtering for measurement
    improvement - seems not to work as good as it should
    [CONTROLLER.c, CONTROLLER.h, RS485.c, SENSE.c, SENSE.h]
2020-07-17 Updated schematic for controller Designed new PCB for the controller Modularity of controller has been increased I/O board and COM board are now independent of CPU board
    [partslist.csv, partslist_cpu.csv, partslist_io.csv, vfd_controller.brd, vfd_controller.sch, vfd_controller_com.brd, vfd_controller_com.sch, vfd_controller_cpu.brd]
2020-07-18 Minor changes to Schematics Changed IGBT-Driver signal-side connector to plugs Updated Schematic Information Field
    [partslist.csv, vfd_controller_cpu.brd, vfd_controller_cpu.sch, vfd_controller_io.brd, vfd_controller_io.sch, vfd_dcbus.brd, vfd_dcbus.sch, vfd_dcbus_holes.brd]
